QuinnFreedman/modular/modules/Lights/PCBs/lights_pcb/lights_pcb.kicad_pcb

## KiCad design modules/Lights/PCBs/lights_pcb/lights_pcb.kicad_pcb (2025-10-13)

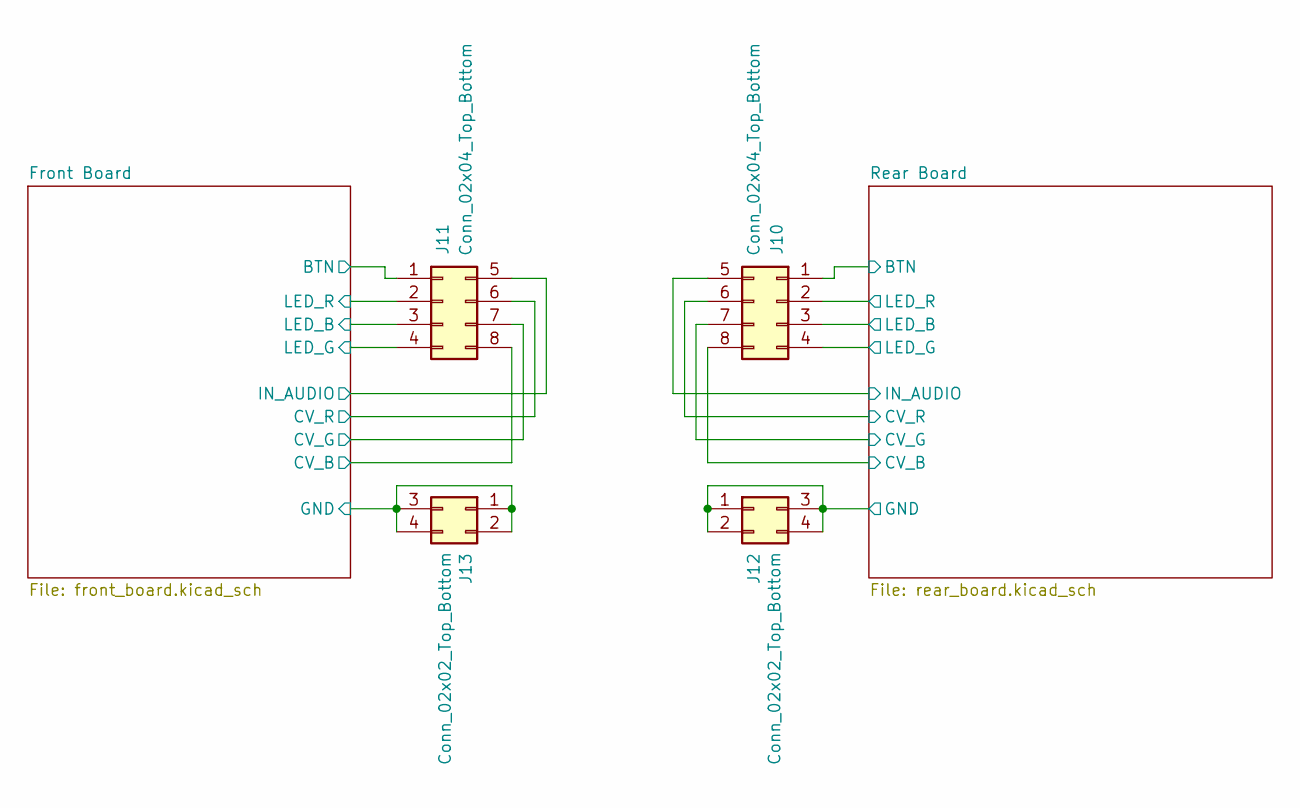
[picture p7: schematic lights_pcb.kicad_sch, Lights]

Parts:
J10: Conn_02x04_Top_Bottom; PinSocket_2x04_P2.54mm_Vertical
J11: Conn_02x04_Top_Bottom; PinHeader_2x04_P2.54mm_Horizontal
J12: Conn_02x02_Top_Bottom; PinSocket_2x02_P2.54mm_Vertical
J13: Conn_02x02_Top_Bottom; PinHeader_2x02_P2.54mm_Horizontal

Connections:
/Front Board/BTN: J11.1; also elsewhere on the board
/Front Board/CV_B: J11.8; also elsewhere on the board
/Front Board/CV_G: J11.7; also elsewhere on the board
/Front Board/CV_R: J11.6; also elsewhere on the board
/Front Board/GND: J13.1, J13.2, J13.3, J13.4; also elsewhere on the board
/Front Board/IN_AUDIO: J11.5; also elsewhere on the board
/Front Board/LED_B: J11.3; also elsewhere on the board
/Front Board/LED_G: J11.4; also elsewhere on the board
/Front Board/LED_R: J11.2; also elsewhere on the board
/Rear Board/BTN: J10.1; also elsewhere on the board
/Rear Board/CV_B: J10.8; also elsewhere on the board
/Rear Board/CV_G: J10.7; also elsewhere on the board
/Rear Board/CV_R: J10.6; also elsewhere on the board
/Rear Board/GND: J12.1, J12.2, J12.3, J12.4; also elsewhere on the board
/Rear Board/IN_AUDIO: J10.5; also elsewhere on the board
/Rear Board/LED_B: J10.3; also elsewhere on the board
/Rear Board/LED_G: J10.4; also elsewhere on the board
/Rear Board/LED_R: J10.2; also elsewhere on the board

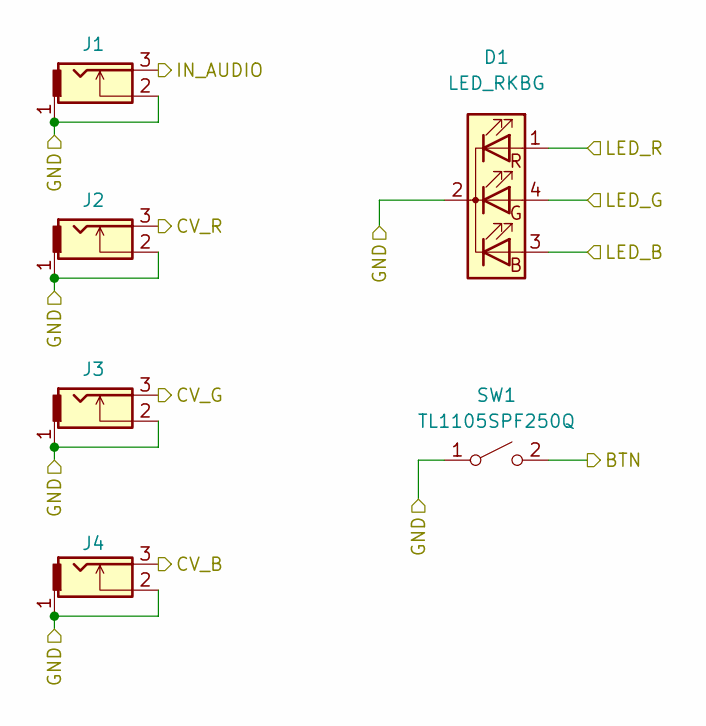
[picture p8: schematic front_board.kicad_sch, Lights]

Parts:
D1: LED_RKBG; LED_D5.0mm-4_RGB
J1, J2, J3, J4: THONKICONN
SW1: TL1105SPF250Q; SW_PUSH_6mm_H13mm

Connections:
/Front Board/BTN: SW1.2 (B); also elsewhere on the board
/Front Board/CV_B: J4.3; also elsewhere on the board
/Front Board/CV_G: J3.3; also elsewhere on the board
/Front Board/CV_R: J2.3; also elsewhere on the board
/Front Board/GND: D1.2 (K), J1.1, J1.2, J2.1, J2.2, J3.1, J3.2, J4.1, J4.2, SW1.1 (A); also elsewhere on the board
/Front Board/IN_AUDIO: J1.3; also elsewhere on the board
/Front Board/LED_B: D1.3 (BA); also elsewhere on the board
/Front Board/LED_G: D1.4 (GA); also elsewhere on the board
/Front Board/LED_R: D1.1 (RA); also elsewhere on the board

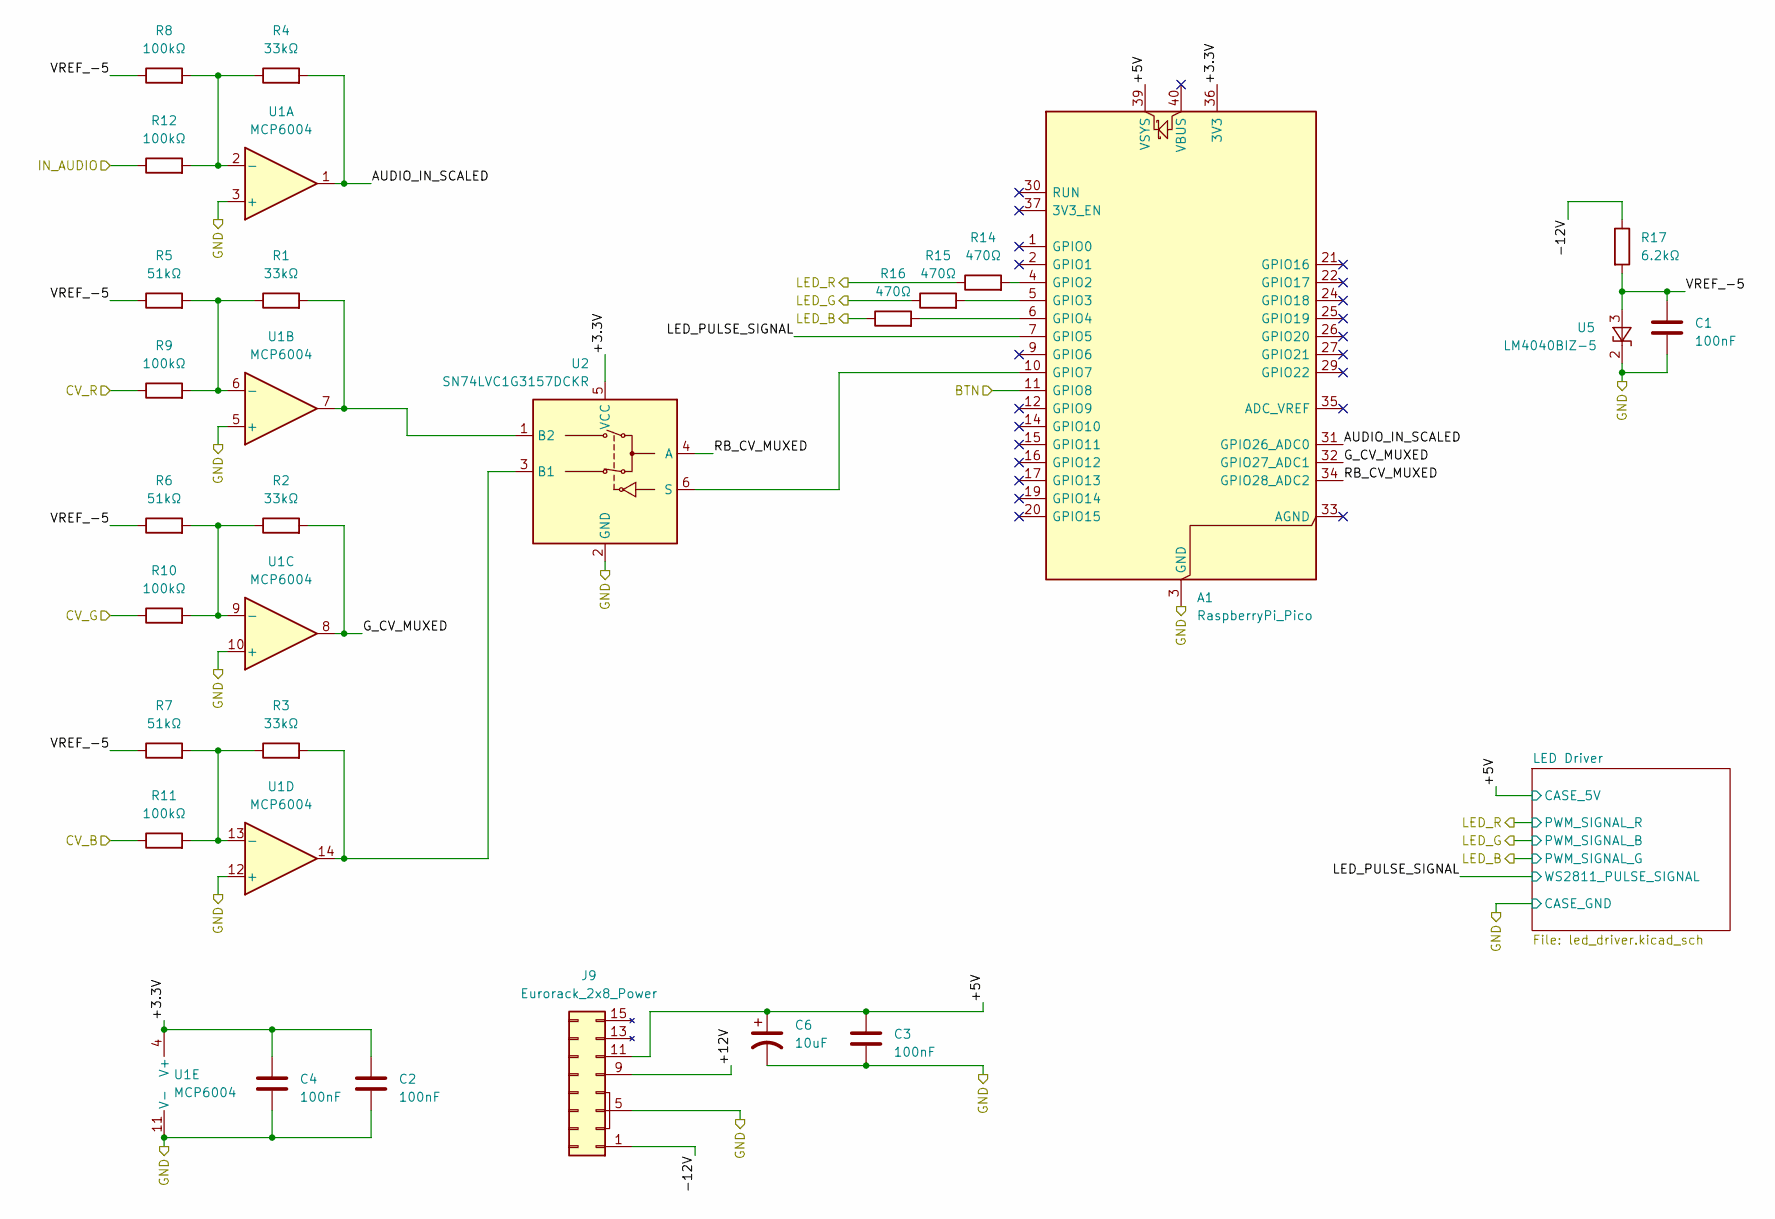
[picture p9: schematic rear_board.kicad_sch, Lights]

Parts:
A1: RaspberryPi_Pico; RaspberryPi_Pico_Common_Unspecified
C1, C2, C3, C4: 100nF; C_Disc_D5.0mm_W2.5mm_P5.00mm
C6: 10uF; CP_Radial_D4.0mm_P1.50mm
J9: Eurorack_2x8_Power; PinSocket_2x08_P2.54mm_Horizontal
R1, R2, R3, R4: 33kΩ; R_Axial_DIN0207_L6.3mm_D2.5mm_P7.62mm_Horizontal
R5, R6, R7: 51kΩ; R_Axial_DIN0207_L6.3mm_D2.5mm_P7.62mm_Horizontal
R8, R9, R10, R11, R12: 100kΩ; R_Axial_DIN0207_L6.3mm_D2.5mm_P7.62mm_Horizontal
R14, R15, R16: 470Ω; R_Axial_DIN0207_L6.3mm_D2.5mm_P7.62mm_Horizontal
R17: 6.2kΩ; R_Axial_DIN0207_L6.3mm_D2.5mm_P7.62mm_Horizontal
U1: MCP6004; DIP-14_W7.62mm
U2: SN74LVC1G3157DCKR; SOT-363_SC-70-6_Handsoldering
U5: LM4040BIZ-5; TO-92_Inline_Wide

Connections:
/Rear Board/+3.3V: A1.36 (3V3), C2.1, C4.1, U1.4 (V+), U2.5 (VCC)
/Rear Board/+5V: A1.39 (VSYS), C3.1, C6.1, J9.11 (+5v), J9.12 (+5v); also elsewhere on the board
/Rear Board/+12V: J9.9 (+12v), J9.10 (+12v)
/Rear Board/-12V: J9.1 (-12v), J9.2 (-12v), R17.1
/Rear Board/AUDIO_IN_SCALED: A1.31 (GPIO26_ADC0), R4.2, U1.1
/Rear Board/BTN: A1.11 (GPIO8); also elsewhere on the board
/Rear Board/CV_B: R11.1; also elsewhere on the board
/Rear Board/CV_G: R10.1; also elsewhere on the board
/Rear Board/CV_R: R9.1; also elsewhere on the board
/Rear Board/GND: A1.3 (GND), A1.8 (GND), A1.13 (GND), A1.18 (GND), A1.23 (GND), A1.28 (GND), A1.38 (GND), C1.2, C2.2, C3.2, C4.2, C6.2, J9.3 (GND), J9.4 (GND), J9.5 (GND), J9.6 (GND), J9.7 (GND), J9.8 (GND), U1.3 (+), U1.5 (+), U1.10 (+), U1.11 (V-), U1.12 (+), U2.2 (GND), U5.2 (K); also elsewhere on the board
/Rear Board/G_CV_MUXED: A1.32 (GPIO27_ADC1), R2.2, U1.8
/Rear Board/IN_AUDIO: R12.1; also elsewhere on the board
/Rear Board/LED_B: R16.1; also elsewhere on the board
/Rear Board/LED_G: R15.1; also elsewhere on the board
/Rear Board/LED_PULSE_SIGNAL: A1.7 (GPIO5); also elsewhere on the board
/Rear Board/LED_R: R14.1; also elsewhere on the board
/Rear Board/RB_CV_MUXED: A1.34 (GPIO28_ADC2), U2.4 (A)
/Rear Board/VREF_-5: C1.1, R5.1, R6.1, R7.1, R8.1, R17.2, U5.3 (A)
unnamed: A1.4 (GPIO2), R14.2
unnamed: A1.5 (GPIO3), R15.2
unnamed: A1.6 (GPIO4), R16.2
unnamed: A1.10 (GPIO7), U2.6 (S)
unnamed: R4.1, R8.2, R12.2, U1.2 (-)
unnamed: R1.1, R5.2, R9.2, U1.6 (-)
unnamed: R2.1, R6.2, R10.2, U1.9 (-)
unnamed: R3.1, R7.2, R11.2, U1.13 (-)
unnamed: R3.2, U1.14, U2.3 (B1)
unnamed: R1.2, U1.7, U2.1 (B2)

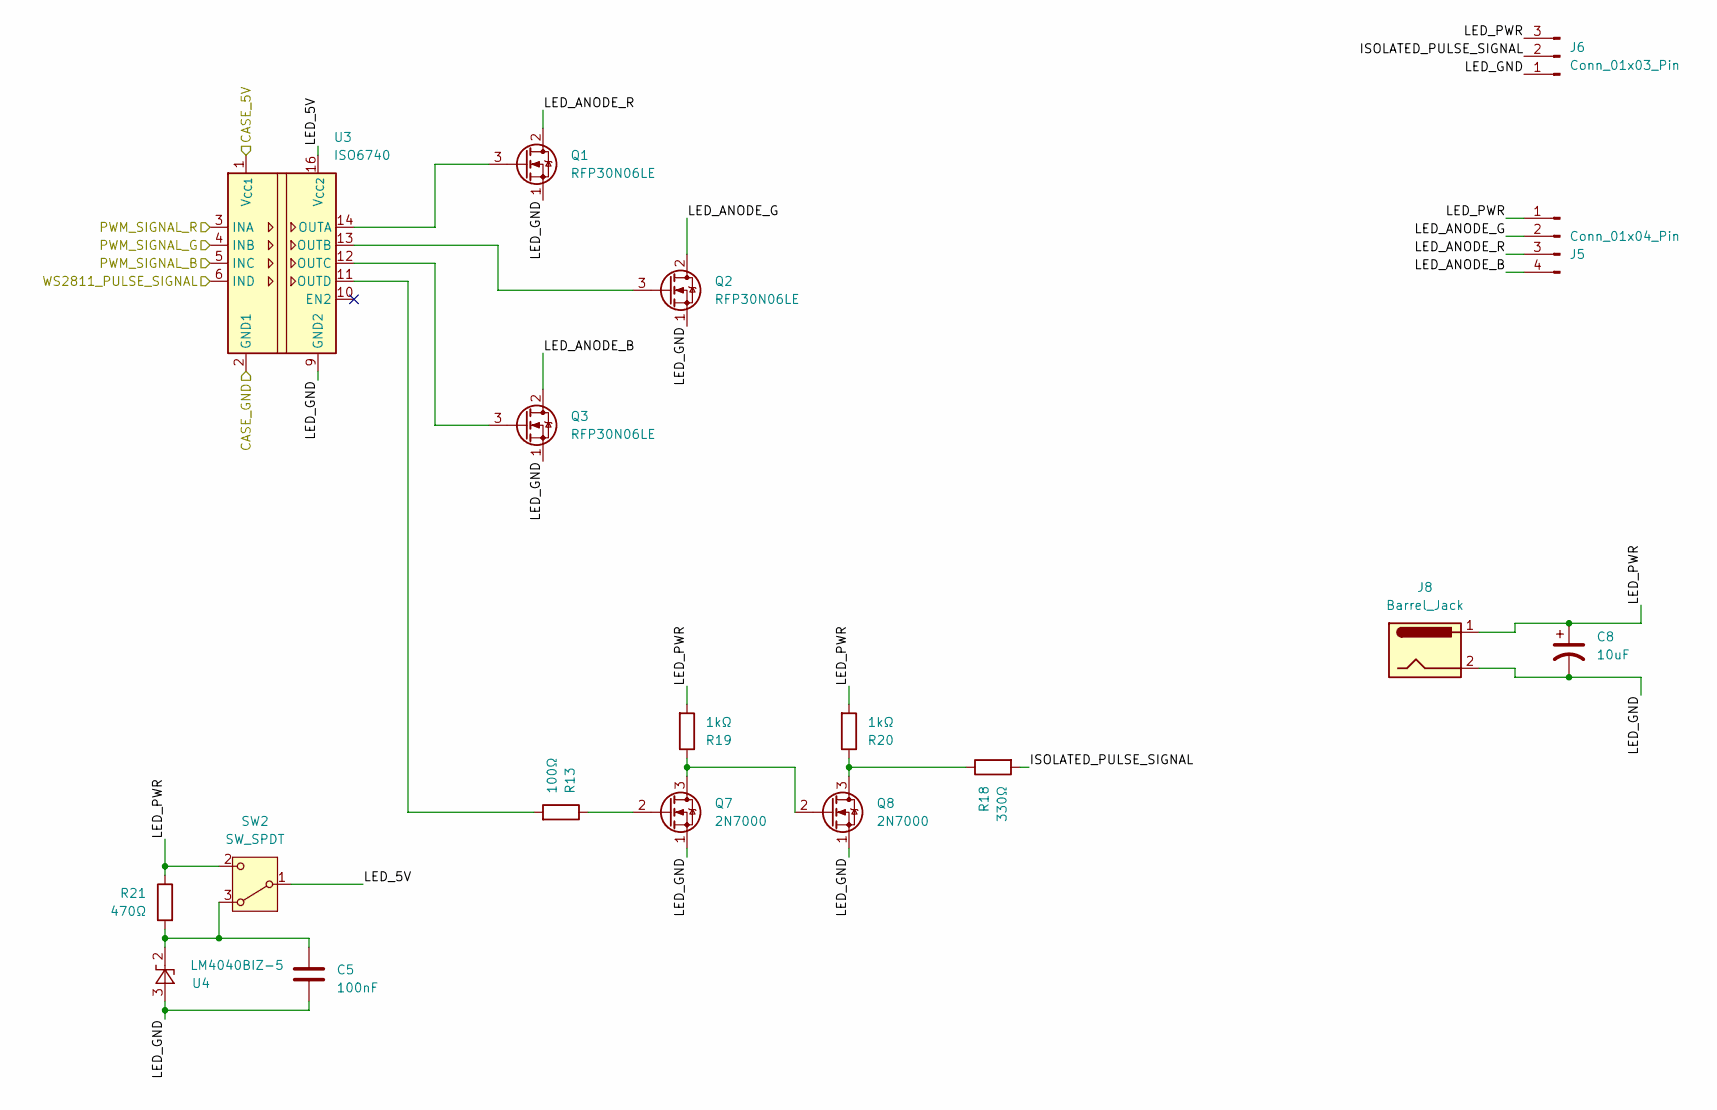
[picture p10: schematic led_driver.kicad_sch, Lights]

Parts:
C5: 100nF; C_Disc_D5.0mm_W2.5mm_P5.00mm
C8: 10uF; CP_Radial_D4.0mm_P1.50mm
J5: Conn_01x04_Pin; PinSocket_1x04_P2.54mm_Vertical
J6: Conn_01x03_Pin; PinSocket_1x03_P2.54mm_Vertical
J8: Barrel_Jack; BarrelJack_Wuerth_6941xx301002
Q1, Q2, Q3: RFP30N06LE; TO-220-3_Vertical
Q7, Q8: 2N7000; TO-92_Inline
R13: 100Ω; R_Axial_DIN0207_L6.3mm_D2.5mm_P7.62mm_Horizontal
R18: 330Ω; R_Axial_DIN0207_L6.3mm_D2.5mm_P7.62mm_Horizontal
R19, R20: 1kΩ; R_Axial_DIN0207_L6.3mm_D2.5mm_P7.62mm_Horizontal
R21: 470Ω; R_Axial_DIN0207_L6.3mm_D2.5mm_P7.62mm_Horizontal
SW2: SW_SPDT; SW_Slide-03_Wuerth-WS-SLTV_10x2.5x6.4_P2.54mm
U3: ISO6740; SOIC-16W_7.5x10.3mm_P1.27mm
U4: LM4040BIZ-5; TO-92_Inline_Wide

Connections:
/Rear Board/+5V: U3.1 (V_{CC1}); also elsewhere on the board
/Rear Board/GND: U3.2 (GND1), U3.8 (GND1); also elsewhere on the board
/Rear Board/LED Driver/ISOLATED_PULSE_SIGNAL: J6.2, R18.2
/Rear Board/LED Driver/LED_5V: SW2.1 (B), U3.16 (V_{CC2})
/Rear Board/LED Driver/LED_ANODE_B: J5.4, Q3.2 (D)
/Rear Board/LED Driver/LED_ANODE_G: J5.2, Q2.2 (D)
/Rear Board/LED Driver/LED_ANODE_R: J5.3, Q1.2 (D)
/Rear Board/LED Driver/LED_GND: C5.2, C8.2, J6.1, J8.2, Q1.1 (S), Q2.1 (S), Q3.1 (S), Q7.1 (S), Q8.1 (S), U3.9 (GND2), U3.15 (GND2), U4.3 (A)
/Rear Board/LED Driver/LED_PWR: C8.1, J5.1, J6.3, J8.1, R19.2, R20.2, R21.1, SW2.2 (C)
/Rear Board/LED_B: U3.4 (INB); also elsewhere on the board
/Rear Board/LED_G: U3.5 (INC); also elsewhere on the board
/Rear Board/LED_PULSE_SIGNAL: U3.6 (IND); also elsewhere on the board
/Rear Board/LED_R: U3.3 (INA); also elsewhere on the board
unnamed: Q1.3 (G), U3.14 (OUTA)
unnamed: Q2.3 (G), U3.13 (OUTB)
unnamed: Q3.3 (G), U3.12 (OUTC)
unnamed: Q7.3 (D), Q8.2 (G), R19.1
unnamed: Q7.2 (G), R13.1
unnamed: Q8.3 (D), R18.1, R20.1
unnamed: C5.1, R21.2, SW2.3 (A), U4.2 (K)
unnamed: R13.2, U3.11 (OUTD)
