QuinnFreedman/modular/modules/Lights/PCBs/lights_pcb/lights_pcb.kicad_pcb

## KiCad design modules/Lights/PCBs/lights_pcb/lights_pcb.kicad_pcb (continued)

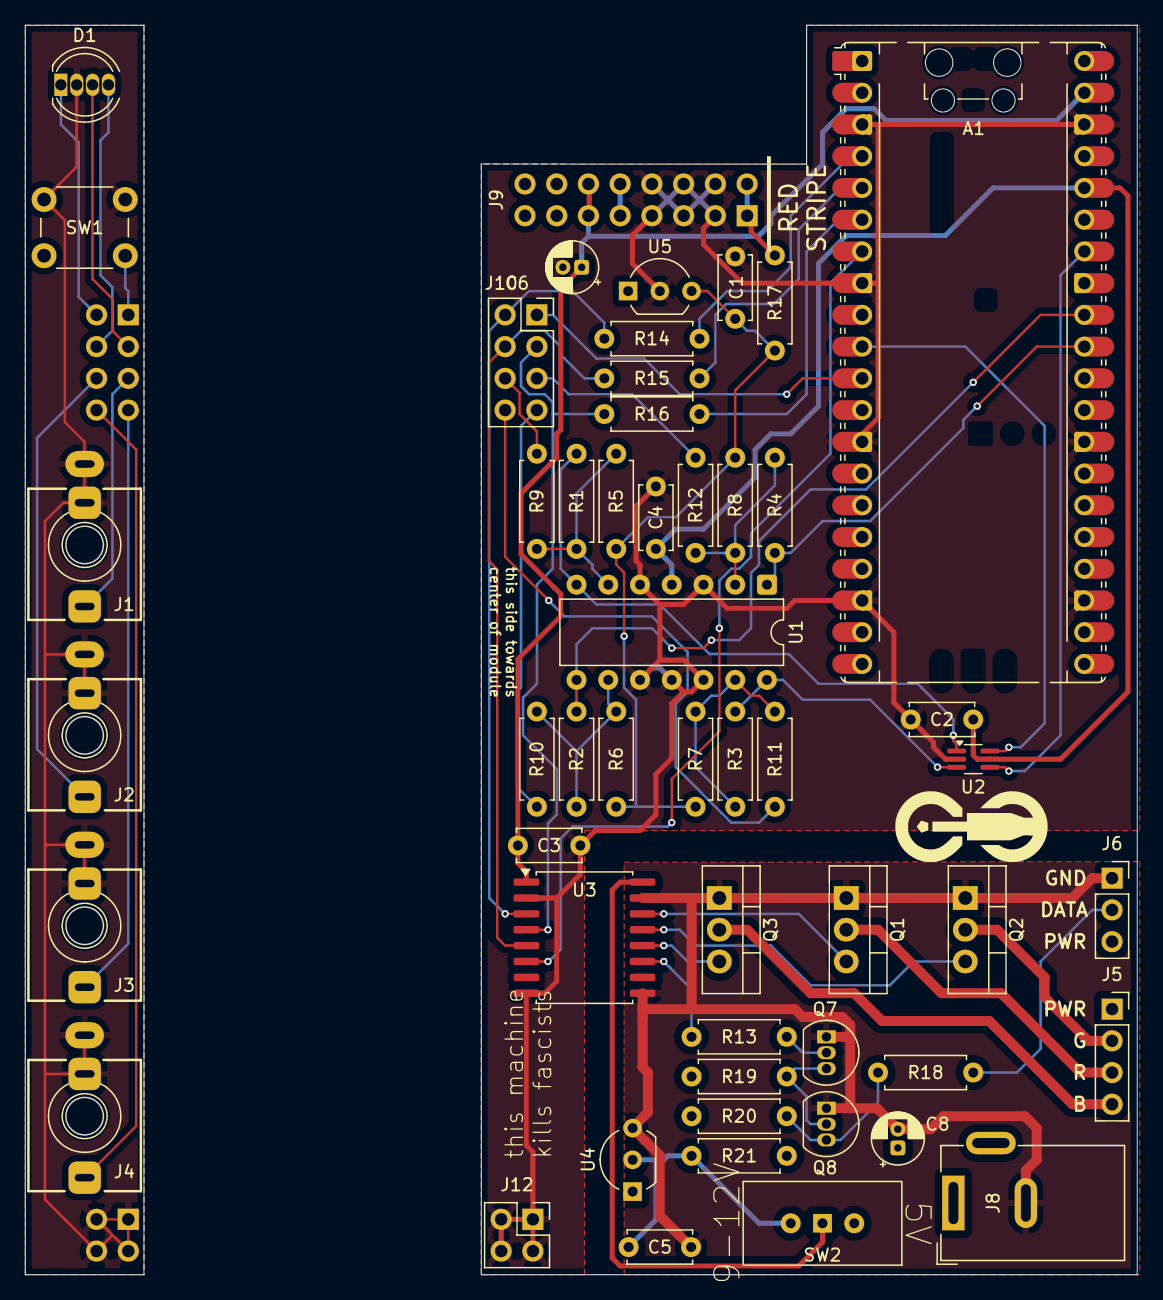
[picture p11: board lights_pcb.kicad_pcb from above]

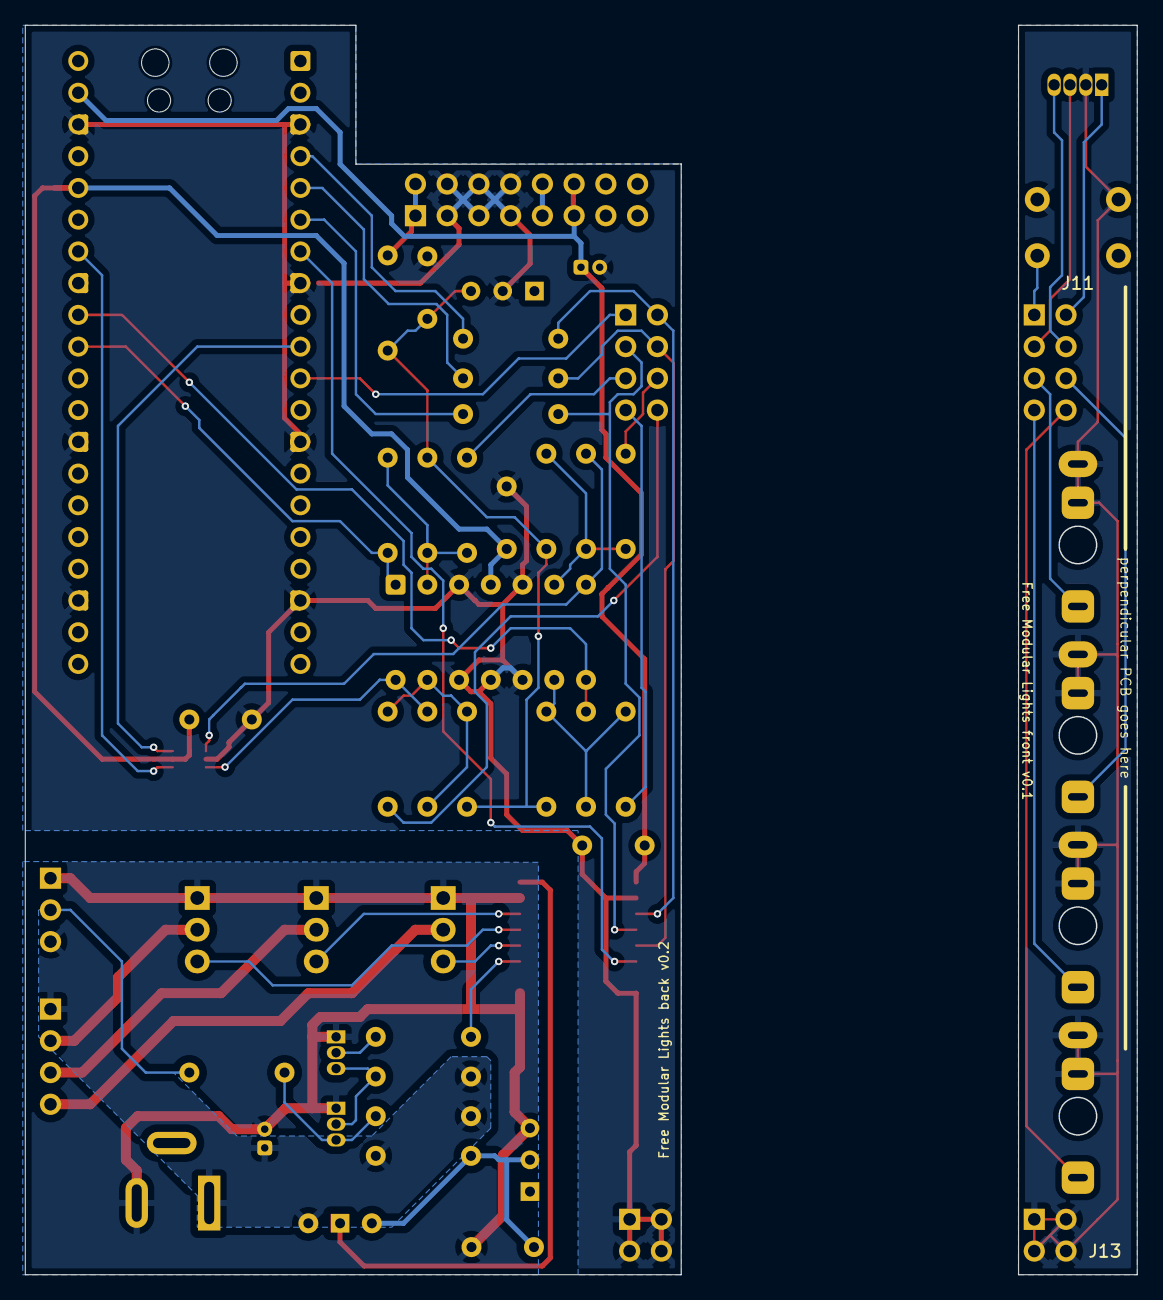
[picture p12: board lights_pcb.kicad_pcb from below]

Board: 2 copper layers, 52.5 x 100.0 mm, 57 parts (2 on the bottom side), 52 nets.

Other parts of the board:
B1, B2: Board
G1: logo_small
