QuinnFreedman/modular/modules/Logic/PCBs/logic_pcb/logic_pcb.kicad_pcb

## KiCad design modules/Logic/PCBs/logic_pcb/logic_pcb.kicad_pcb (2025-06-04)

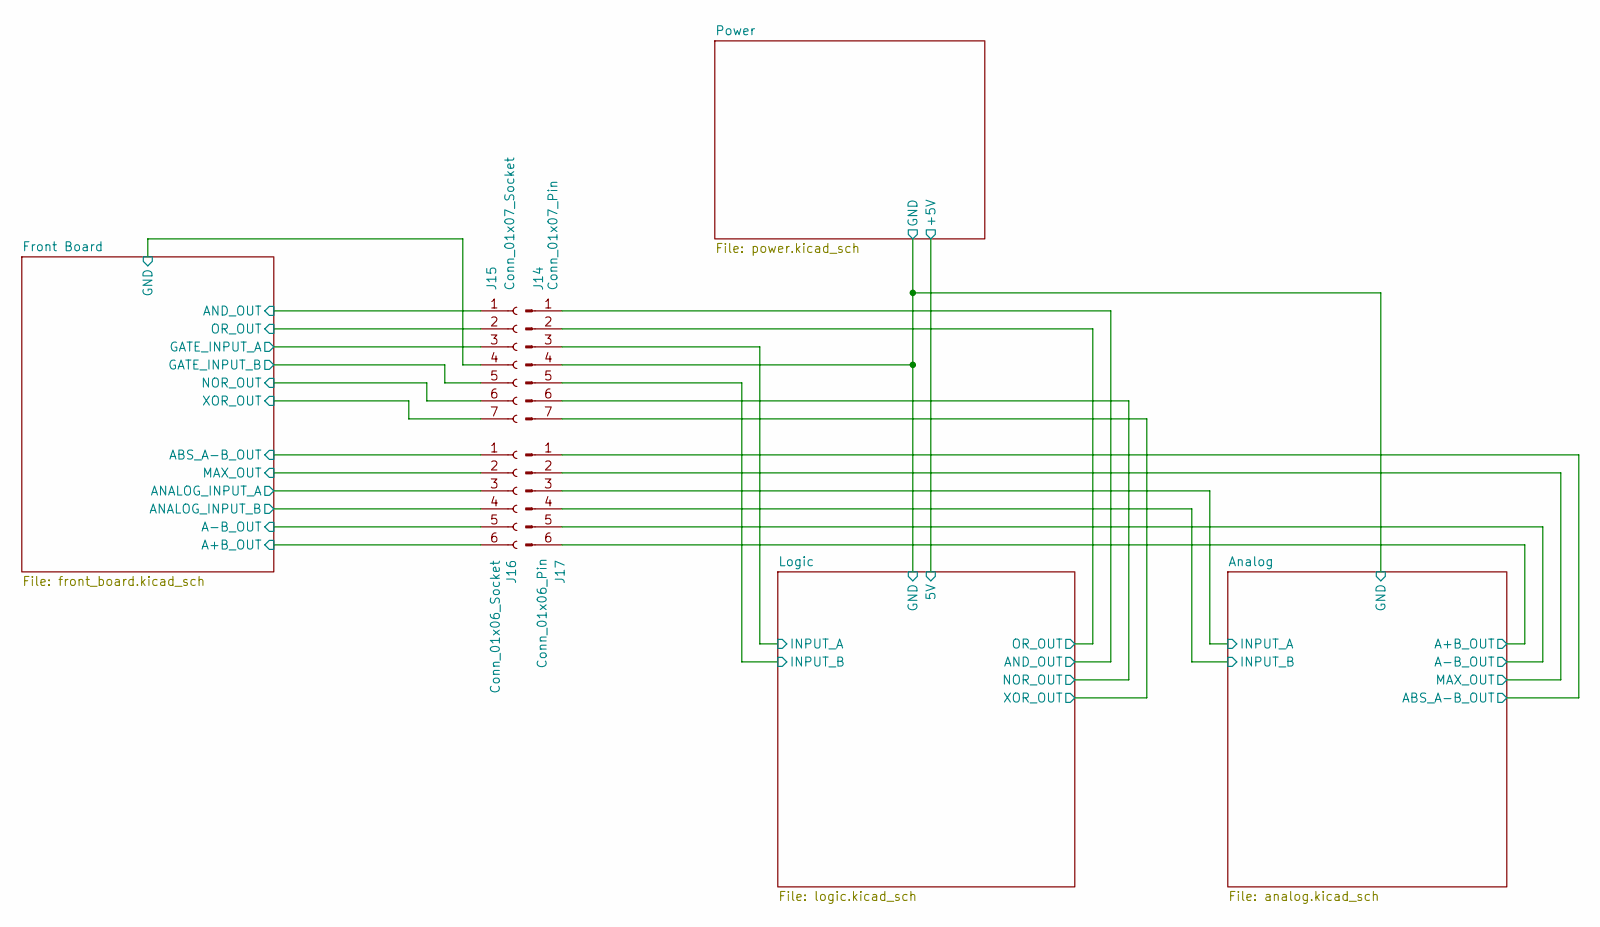
[picture p18: schematic logic_pcb.kicad_sch, ALU]

Parts:
J14: Conn_01x07_Pin; PinSocket_1x07_P2.54mm_Vertical
J15: Conn_01x07_Socket; PinSocket_1x07_P2.54mm_Vertical
J16: Conn_01x06_Socket; PinSocket_1x06_P2.54mm_Vertical
J17: Conn_01x06_Pin; PinSocket_1x06_P2.54mm_Vertical

Connections:
/Analog/A+B_OUT: J17.6; also elsewhere on the board
/Analog/A-B_OUT: J17.5; also elsewhere on the board
/Analog/ABS_A-B_OUT: J17.1; also elsewhere on the board
/Analog/GND: J14.4; also elsewhere on the board
/Analog/INPUT_A: J17.3; also elsewhere on the board
/Analog/INPUT_B: J17.4; also elsewhere on the board
/Analog/MAX_OUT: J17.2; also elsewhere on the board
/Front Board/A+B_OUT: J16.6; also elsewhere on the board
/Front Board/A-B_OUT: J16.5; also elsewhere on the board
/Front Board/ABS_A-B_OUT: J16.1; also elsewhere on the board
/Front Board/ANALOG_INPUT_A: J16.3; also elsewhere on the board
/Front Board/ANALOG_INPUT_B: J16.4; also elsewhere on the board
/Front Board/AND_OUT: J15.1; also elsewhere on the board
/Front Board/GATE_INPUT_A: J15.3; also elsewhere on the board
/Front Board/GATE_INPUT_B: J15.5; also elsewhere on the board
/Front Board/GND: J15.4; also elsewhere on the board
/Front Board/MAX_OUT: J16.2; also elsewhere on the board
/Front Board/NOR_OUT: J15.6; also elsewhere on the board
/Front Board/OR_OUT: J15.2; also elsewhere on the board
/Front Board/XOR_OUT: J15.7; also elsewhere on the board
/Logic/AND_OUT: J14.1; also elsewhere on the board
/Logic/INPUT_A: J14.3; also elsewhere on the board
/Logic/INPUT_B: J14.5; also elsewhere on the board
/Logic/NOR_OUT: J14.6; also elsewhere on the board
/Logic/OR_OUT: J14.2; also elsewhere on the board
/Logic/XOR_OUT: J14.7; also elsewhere on the board
