QuinnFreedman/modular/modules/Logic/PCBs/logic_pcb/logic_pcb.kicad_pcb

## KiCad design modules/Logic/PCBs/logic_pcb/logic_pcb.kicad_pcb (continued)

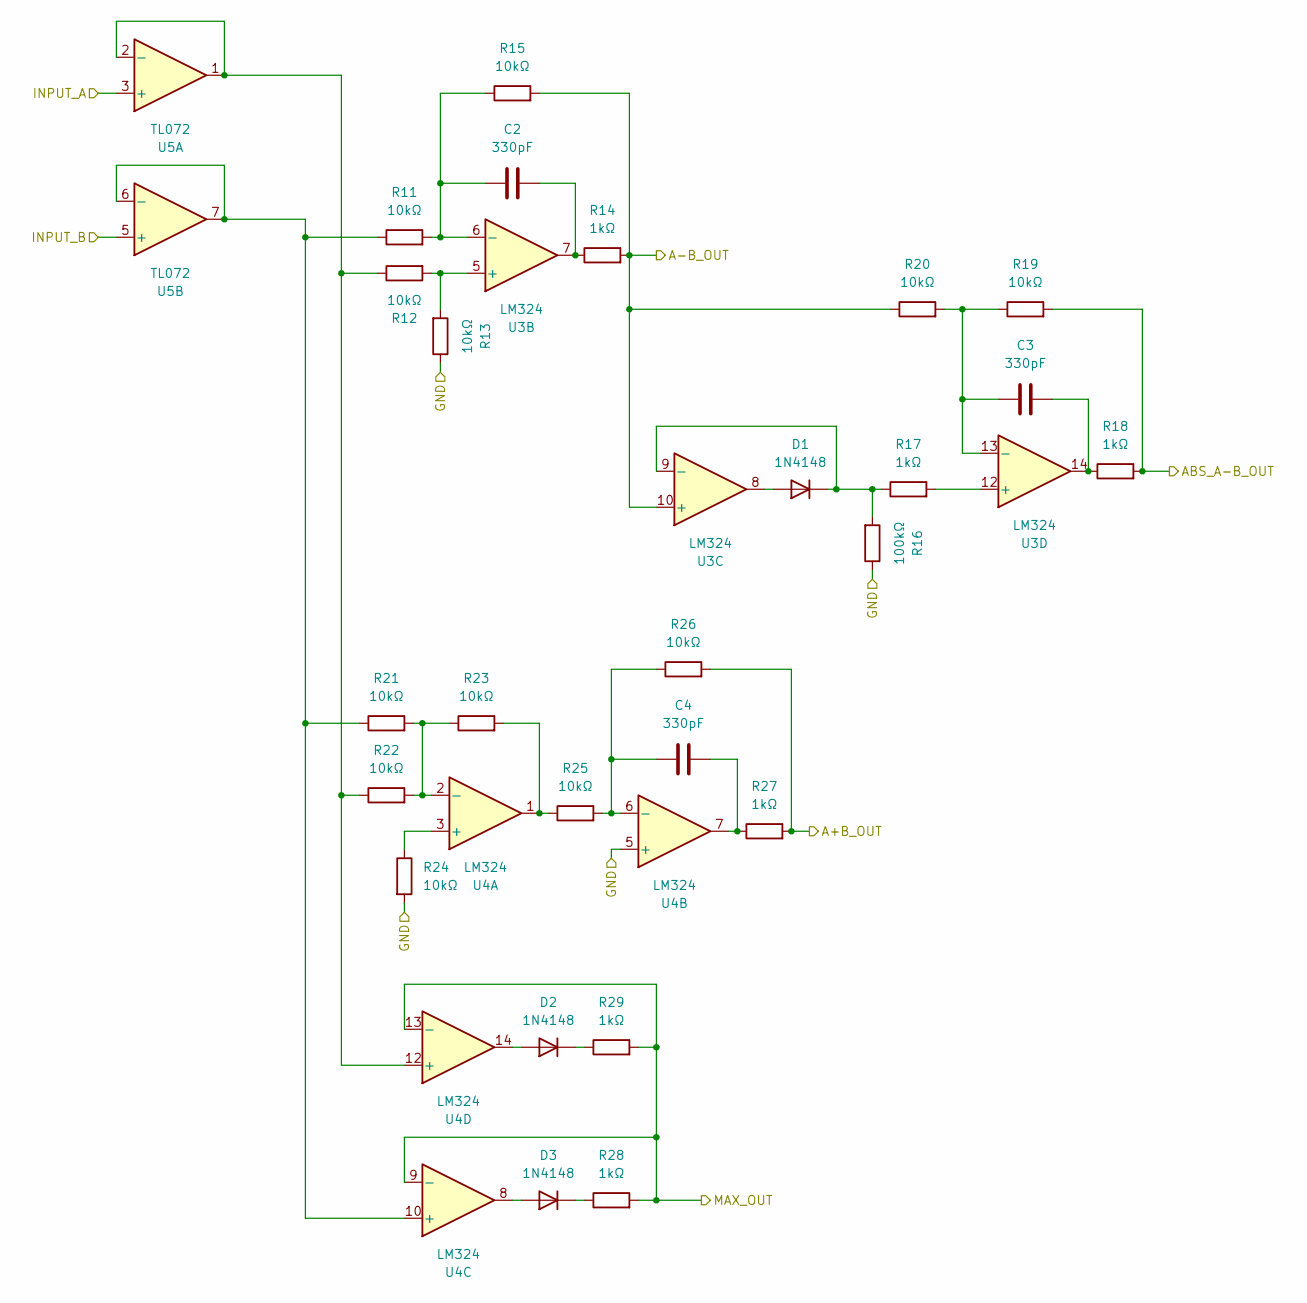
[picture p19: schematic analog.kicad_sch, ALU]

Parts:
C2, C3, C4: 330pF; C_0805_2012Metric_Pad1.18x1.45mm_HandSolder; JLC C376974
D1, D2, D3: 1N4148; D_SOD-123; JLC C5443965
R11, R12, R13, R15, R19, R20, R21, R22, R23, R24, R25, R26: 10kΩ; R_0805_2012Metric_Pad1.20x1.40mm_HandSolder; JLC C17414
R14, R17, R18, R27, R28, R29: 1kΩ; R_0805_2012Metric_Pad1.20x1.40mm_HandSolder; JLC C17513
R16: 100kΩ; R_0805_2012Metric_Pad1.20x1.40mm_HandSolder; JLC C149504
U3, U4: LM324; SOIC-14_3.9x8.7mm_P1.27mm; JLC C7943
U5: TL072; SOP-8_3.9x4.9mm_P1.27mm; JLC C5310783

Connections:
/Analog/A+B_OUT: R26.2, R27.2; also elsewhere on the board
/Analog/A-B_OUT: R14.2, R15.2, R20.1, U3.10 (+); also elsewhere on the board
/Analog/ABS_A-B_OUT: R18.2, R19.2; also elsewhere on the board
/Analog/GND: R13.1, R16.1, R24.2, U4.5 (+); also elsewhere on the board
/Analog/INPUT_A: U5.3 (+); also elsewhere on the board
/Analog/INPUT_B: U5.5 (+); also elsewhere on the board
/Analog/MAX_OUT: R28.2, R29.2, U4.9 (-), U4.13 (-); also elsewhere on the board
unnamed: C2.2, R14.1, U3.7
unnamed: C3.2, R18.1, U3.14
unnamed: C4.2, R27.1, U4.7
unnamed: D1.2 (A), U3.8
unnamed: D1.1 (K), R16.2, R17.1, U3.9 (-)
unnamed: D2.2 (A), U4.14
unnamed: D2.1 (K), R29.1
unnamed: D3.2 (A), U4.8
unnamed: D3.1 (K), R28.1
unnamed: R23.2, R25.1, U4.1
unnamed: R12.2, R13.2, U3.5 (+)
unnamed: C2.1, R11.2, R15.1, U3.6 (-)
unnamed: R17.2, U3.12 (+)
unnamed: C3.1, R19.1, R20.2, U3.13 (-)
unnamed: R24.1, U4.3 (+)
unnamed: R21.2, R22.2, R23.1, U4.2 (-)
unnamed: C4.1, R25.2, R26.1, U4.6 (-)
unnamed: R11.1, R21.1, U4.10 (+), U5.6 (-), U5.7
unnamed: R12.1, R22.1, U4.12 (+), U5.1, U5.2 (-)

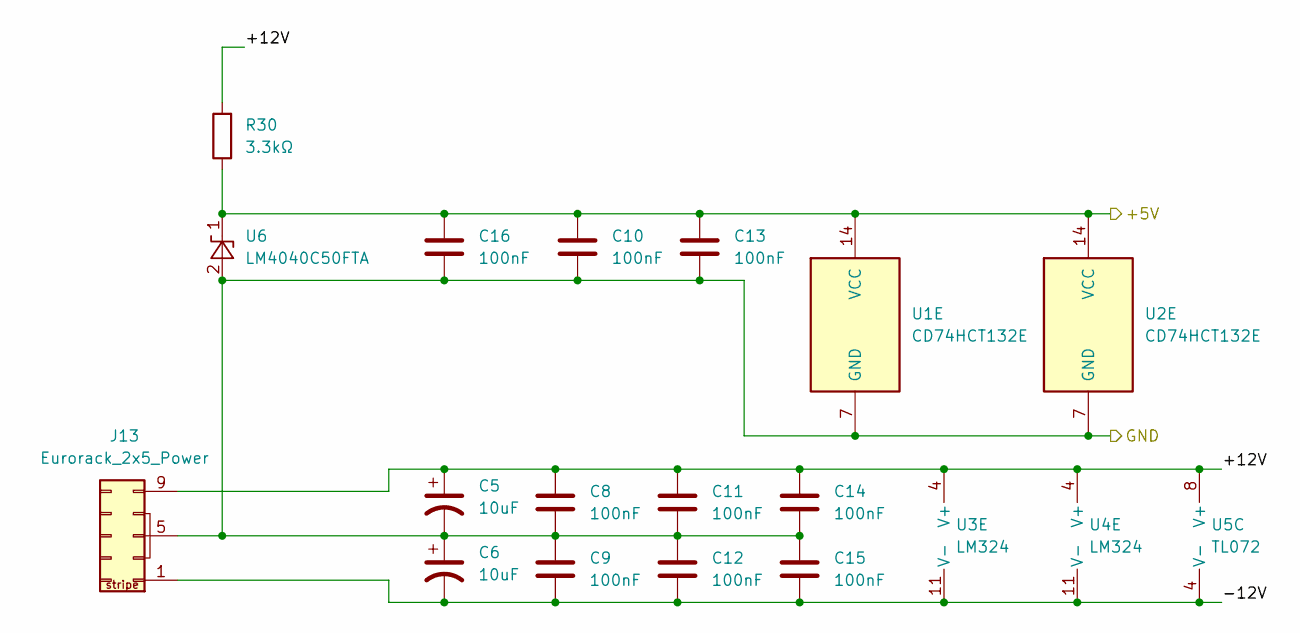
[picture p20: schematic power.kicad_sch, ALU]

Parts:
C5, C6: 10uF; CP_Elec_4x5.4; JLC C3343
C8, C9, C10, C11, C12, C13, C14, C15, C16: 100nF; C_0805_2012Metric_Pad1.18x1.45mm_HandSolder; JLC C29926
J13: Eurorack_2x5_Power; IDC-Header_2x05_P2.54mm_Vertical
R30: 3.3kΩ; R_0805_2012Metric_Pad1.20x1.40mm_HandSolder; JLC C26010
U1, U2: CD74HCT132E; SOIC-14_3.9x8.7mm_P1.27mm; JLC C484714
U3, U4: LM324; SOIC-14_3.9x8.7mm_P1.27mm; JLC C7943
U5: TL072; SOP-8_3.9x4.9mm_P1.27mm; JLC C5310783
U6: LM4040C50FTA; SOT-23; JLC C156291

Connections:
/Analog/GND: C5.2, C6.1, C8.2, C9.1, C10.2, C11.2, C12.1, C13.2, C14.2, C15.1, C16.2, J13.3 (GND), J13.4 (GND), J13.5 (GND), J13.6 (GND), J13.7 (GND), J13.8 (GND), U1.7 (GND), U2.7 (GND), U6.2 (A); also elsewhere on the board
/Logic/5V: C10.1, C13.1, C16.1, R30.1, U1.14 (VCC), U2.14 (VCC), U6.1 (K); also elsewhere on the board
/Power/+12V: C5.1, C8.1, C11.1, C14.1, J13.9 (+12v), J13.10 (+12v), R30.2, U3.4 (V+), U4.4 (V+), U5.8 (V+)
/Power/-12V: C6.2, C9.2, C12.2, C15.2, J13.1 (-12v), J13.2 (-12v), U3.11 (V-), U4.11 (V-), U5.4 (V-)

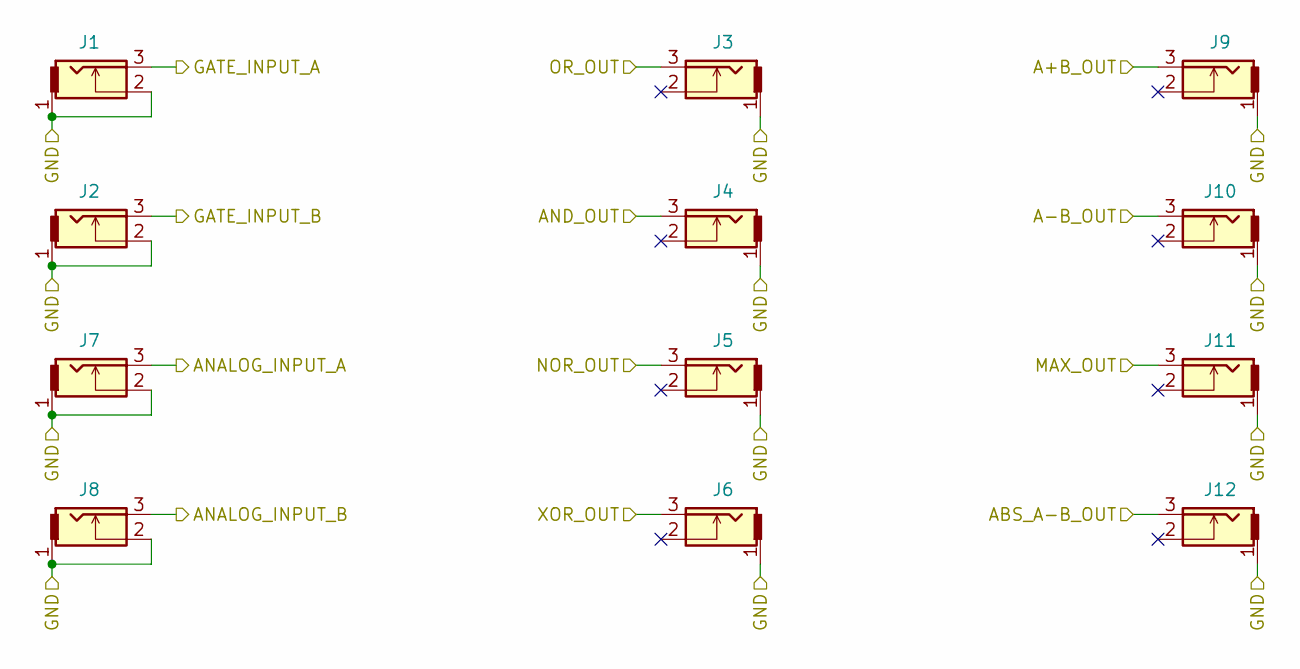
[picture p21: schematic front_board.kicad_sch, ALU]

Parts:
J1, J2, J3, J4, J5, J6, J7, J8, J9, J10, J11, J12: THONKICONN

Connections:
/Front Board/A+B_OUT: J9.3; also elsewhere on the board
/Front Board/A-B_OUT: J10.3; also elsewhere on the board
/Front Board/ABS_A-B_OUT: J12.3; also elsewhere on the board
/Front Board/ANALOG_INPUT_A: J7.3; also elsewhere on the board
/Front Board/ANALOG_INPUT_B: J8.3; also elsewhere on the board
/Front Board/AND_OUT: J4.3; also elsewhere on the board
/Front Board/GATE_INPUT_A: J1.3; also elsewhere on the board
/Front Board/GATE_INPUT_B: J2.3; also elsewhere on the board
/Front Board/GND: J1.1, J1.2, J2.1, J2.2, J3.1, J4.1, J5.1, J6.1, J7.1, J7.2, J8.1, J8.2, J9.1, J10.1, J11.1, J12.1; also elsewhere on the board
/Front Board/MAX_OUT: J11.3; also elsewhere on the board
/Front Board/NOR_OUT: J5.3; also elsewhere on the board
/Front Board/OR_OUT: J3.3; also elsewhere on the board
/Front Board/XOR_OUT: J6.3; also elsewhere on the board

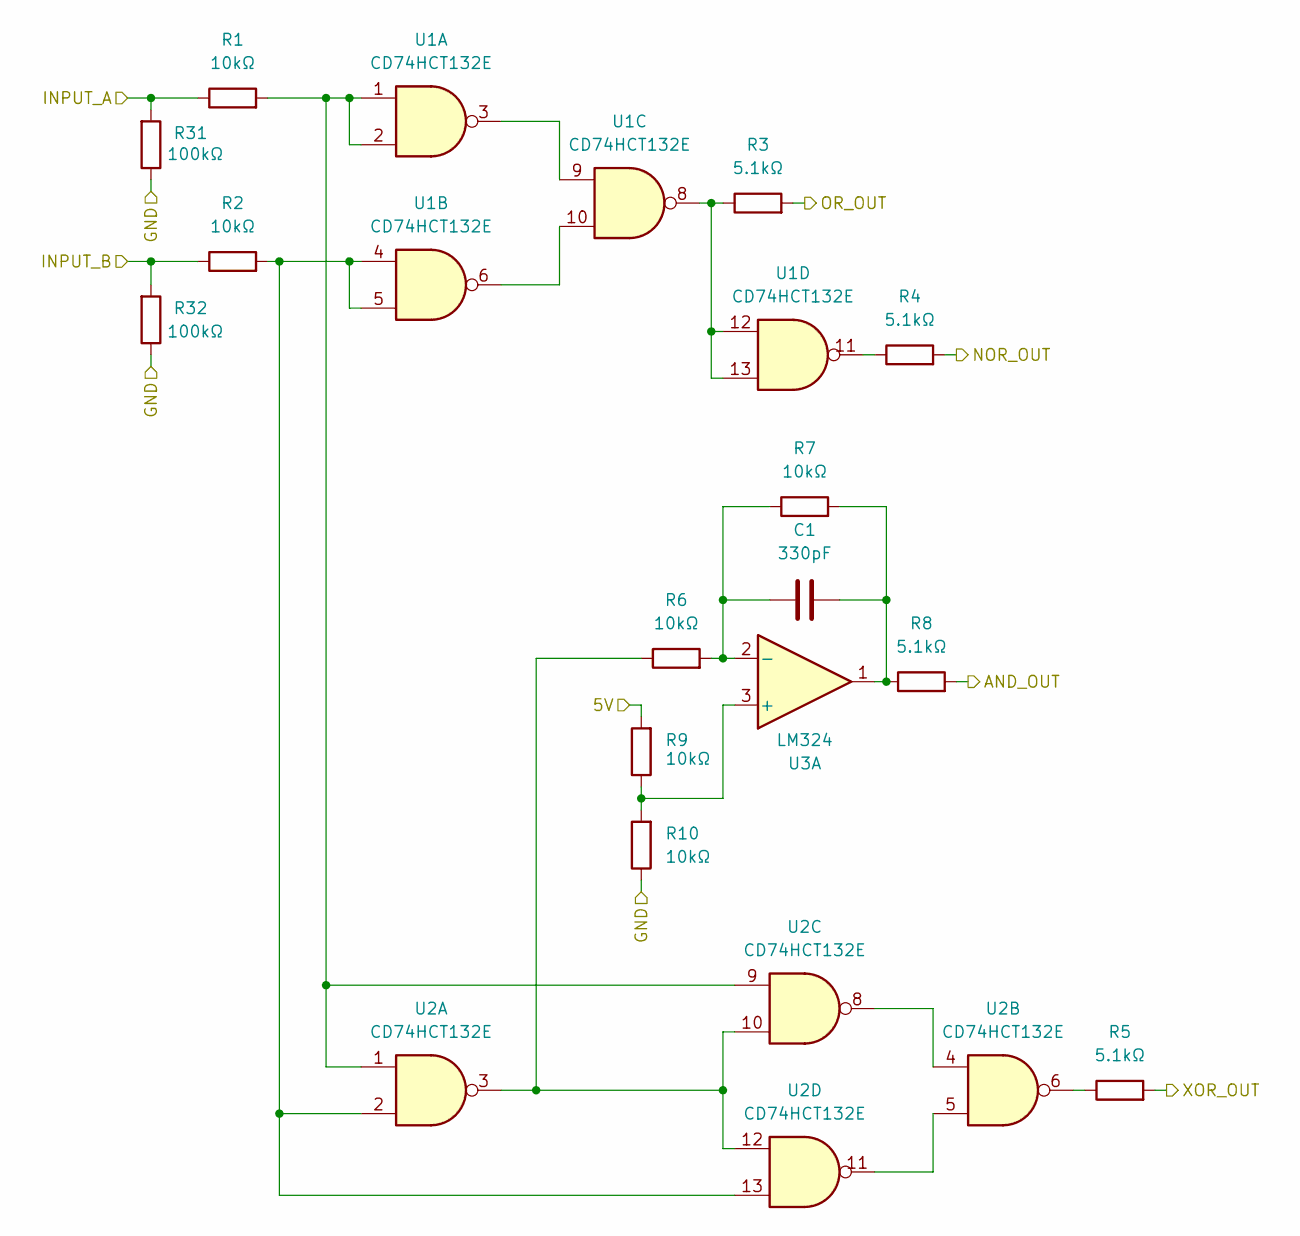
[picture p22: schematic logic.kicad_sch, ALU]

Parts:
C1: 330pF; C_0805_2012Metric_Pad1.18x1.45mm_HandSolder; JLC C376974
R1, R2, R6, R7, R9, R10: 10kΩ; R_0805_2012Metric_Pad1.20x1.40mm_HandSolder; JLC C17414
R3, R4, R5, R8: 5.1kΩ; R_0805_2012Metric_Pad1.20x1.40mm_HandSolder; JLC C27834
R31, R32: 100kΩ; R_0805_2012Metric_Pad1.20x1.40mm_HandSolder; JLC C149504
U1, U2: CD74HCT132E; SOIC-14_3.9x8.7mm_P1.27mm; JLC C484714
U3: LM324; SOIC-14_3.9x8.7mm_P1.27mm; JLC C7943

Connections:
/Analog/GND: R10.1, R31.1, R32.1; also elsewhere on the board
/Logic/5V: R9.2; also elsewhere on the board
/Logic/AND_OUT: R8.2; also elsewhere on the board
/Logic/INPUT_A: R1.1, R31.2; also elsewhere on the board
/Logic/INPUT_B: R2.1, R32.2; also elsewhere on the board
/Logic/NOR_OUT: R4.2; also elsewhere on the board
/Logic/OR_OUT: R3.2; also elsewhere on the board
/Logic/XOR_OUT: R5.2; also elsewhere on the board
unnamed: C1.2, R7.2, R8.1, U3.1
unnamed: R1.2, U1.1, U1.2, U2.1, U2.9
unnamed: R2.2, U1.4, U1.5, U2.2, U2.13
unnamed: R3.1, U1.8, U1.12, U1.13
unnamed: R4.1, U1.11
unnamed: R5.1, U2.6
unnamed: R6.1, U2.3, U2.10, U2.12
unnamed: U1.3, U1.9
unnamed: U1.6, U1.10
unnamed: U2.4, U2.8
unnamed: U2.5, U2.11
unnamed: R9.1, R10.2, U3.3 (+)
unnamed: C1.1, R6.2, R7.1, U3.2 (-)

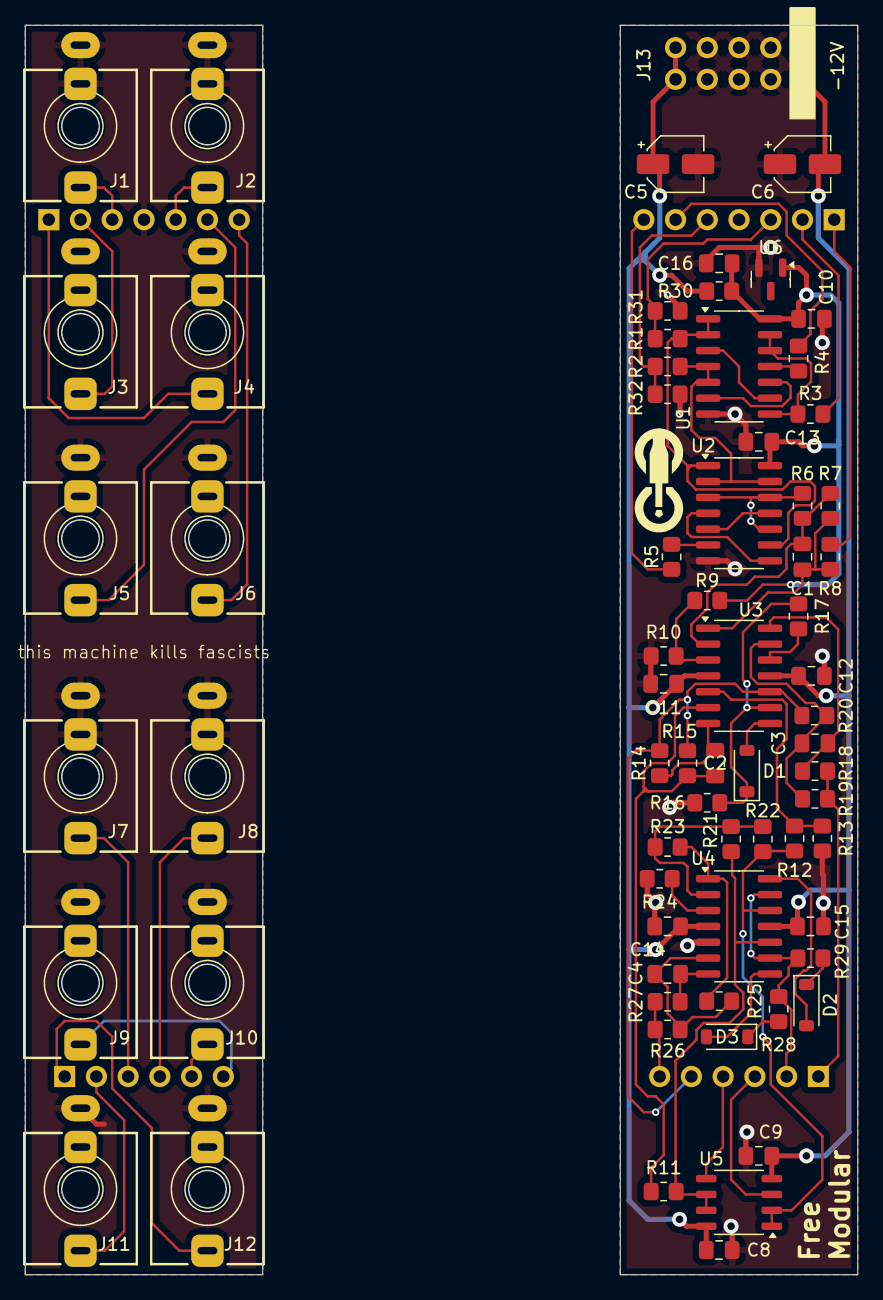
[picture p23: board logic_pcb.kicad_pcb from above]

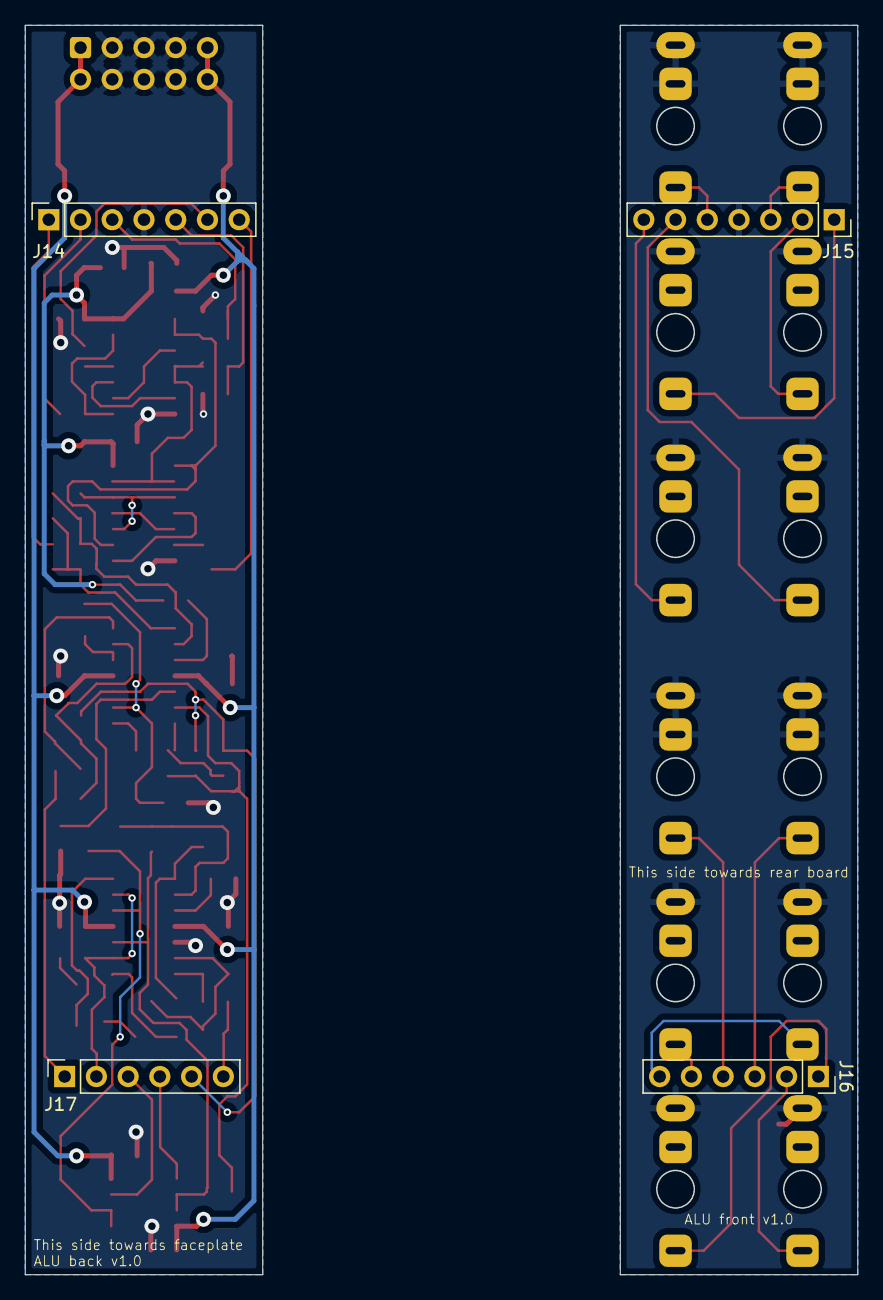
[picture p24: board logic_pcb.kicad_pcb from below]

Board: 2 copper layers, 19.0 x 100.0 mm, 76 parts (4 on the bottom side), 61 nets.

Other parts of the board:
B1, B2: Board
G1: logo_very_small
