QuinnFreedman/modular/modules/OffsetAtten/PCBs/offset_atten_pcb/offset_atten_pcb.kicad_pcb

## KiCad design modules/OffsetAtten/PCBs/offset_atten_pcb/offset_atten_pcb.kicad_pcb (2025-04-23)

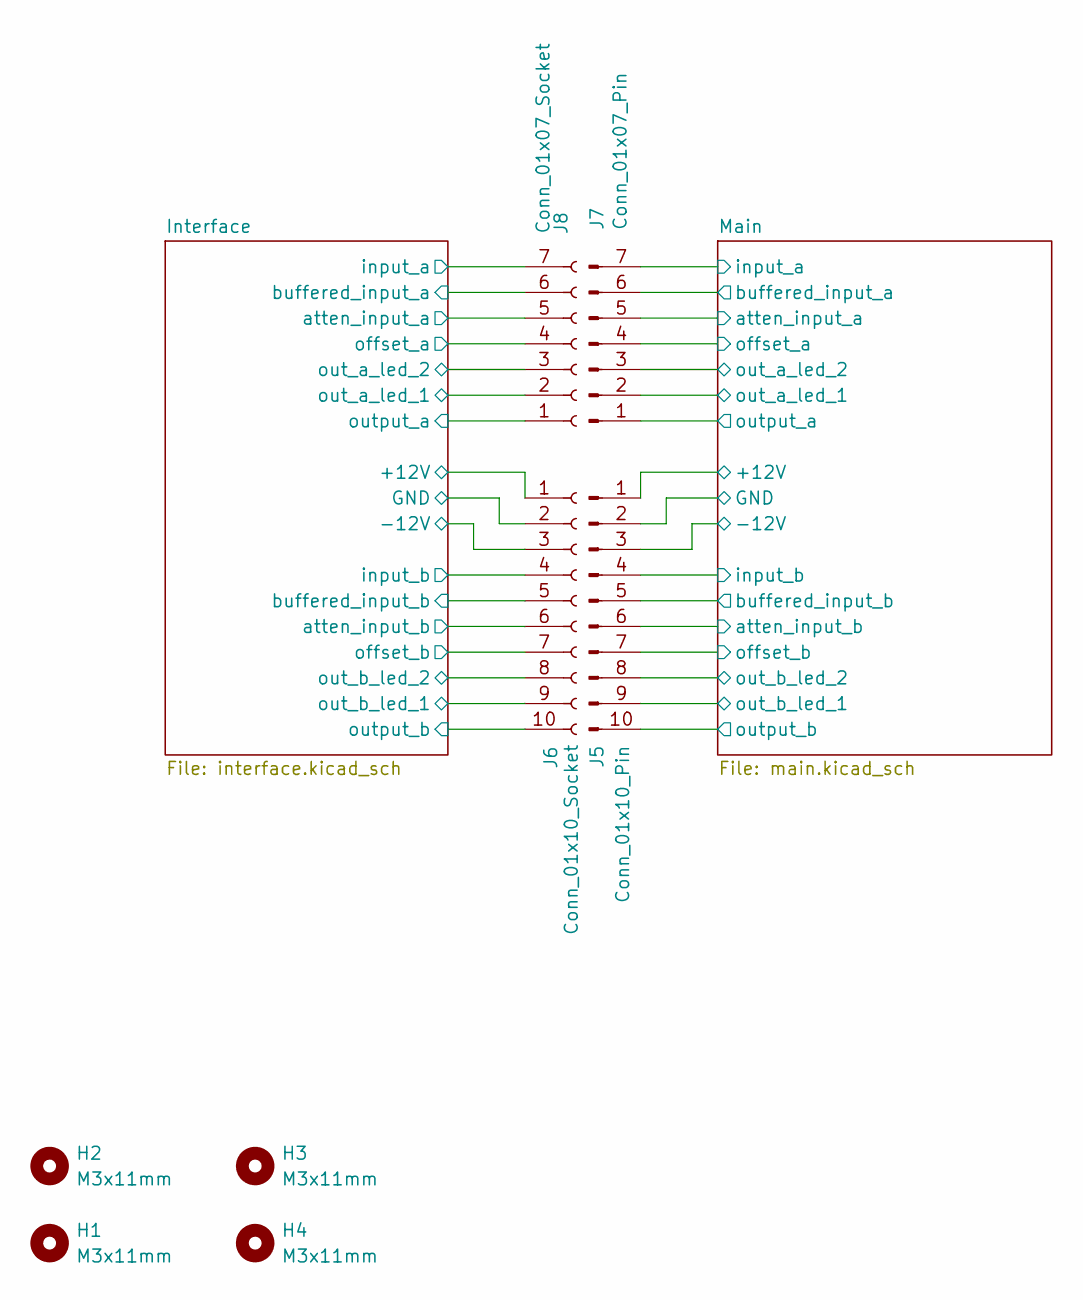
[picture p25: schematic offset_atten_pcb.kicad_sch, OffsetAtten]

Parts:
H1, H2, H3, H4: M3x11mm; MountingHole_3.2mm_M3
J5: Conn_01x10_Pin; PinSocket_1x10_P2.54mm_Vertical
J6: Conn_01x10_Socket; PinSocket_1x10_P2.54mm_Vertical
J7: Conn_01x07_Pin; PinSocket_1x07_P2.54mm_Vertical
J8: Conn_01x07_Socket; PinSocket_1x07_P2.54mm_Vertical

Connections:
/Interface/+12V: J6.1; also elsewhere on the board
/Interface/-12V: J6.3; also elsewhere on the board
/Interface/GND: J6.2; also elsewhere on the board
/Interface/atten_input_a: J8.5; also elsewhere on the board
/Interface/atten_input_b: J6.6; also elsewhere on the board
/Interface/buffered_input_a: J8.6; also elsewhere on the board
/Interface/buffered_input_b: J6.5; also elsewhere on the board
/Interface/input_a: J8.7; also elsewhere on the board
/Interface/input_b: J6.4; also elsewhere on the board
/Interface/offset_a: J8.4; also elsewhere on the board
/Interface/offset_b: J6.7; also elsewhere on the board
/Interface/out_a_led_1: J8.2; also elsewhere on the board
/Interface/out_a_led_2: J8.3; also elsewhere on the board
/Interface/out_b_led_1: J6.9; also elsewhere on the board
/Interface/out_b_led_2: J6.8; also elsewhere on the board
/Interface/output_a: J8.1; also elsewhere on the board
/Interface/output_b: J6.10; also elsewhere on the board
/Main/+12V: J5.1; also elsewhere on the board
/Main/-12V: J5.3; also elsewhere on the board
/Main/GND: J5.2; also elsewhere on the board
/Main/atten_input_a: J7.5; also elsewhere on the board
/Main/atten_input_b: J5.6; also elsewhere on the board
/Main/buffered_input_a: J7.6; also elsewhere on the board
/Main/buffered_input_b: J5.5; also elsewhere on the board
/Main/input_a: J7.7; also elsewhere on the board
/Main/input_b: J5.4; also elsewhere on the board
/Main/offset_a: J7.4; also elsewhere on the board
/Main/offset_b: J5.7; also elsewhere on the board
/Main/out_a_led_1: J7.2; also elsewhere on the board
/Main/out_a_led_2: J7.3; also elsewhere on the board
/Main/out_b_led_1: J5.9; also elsewhere on the board
/Main/out_b_led_2: J5.8; also elsewhere on the board
/Main/output_a: J7.1; also elsewhere on the board
/Main/output_b: J5.10; also elsewhere on the board

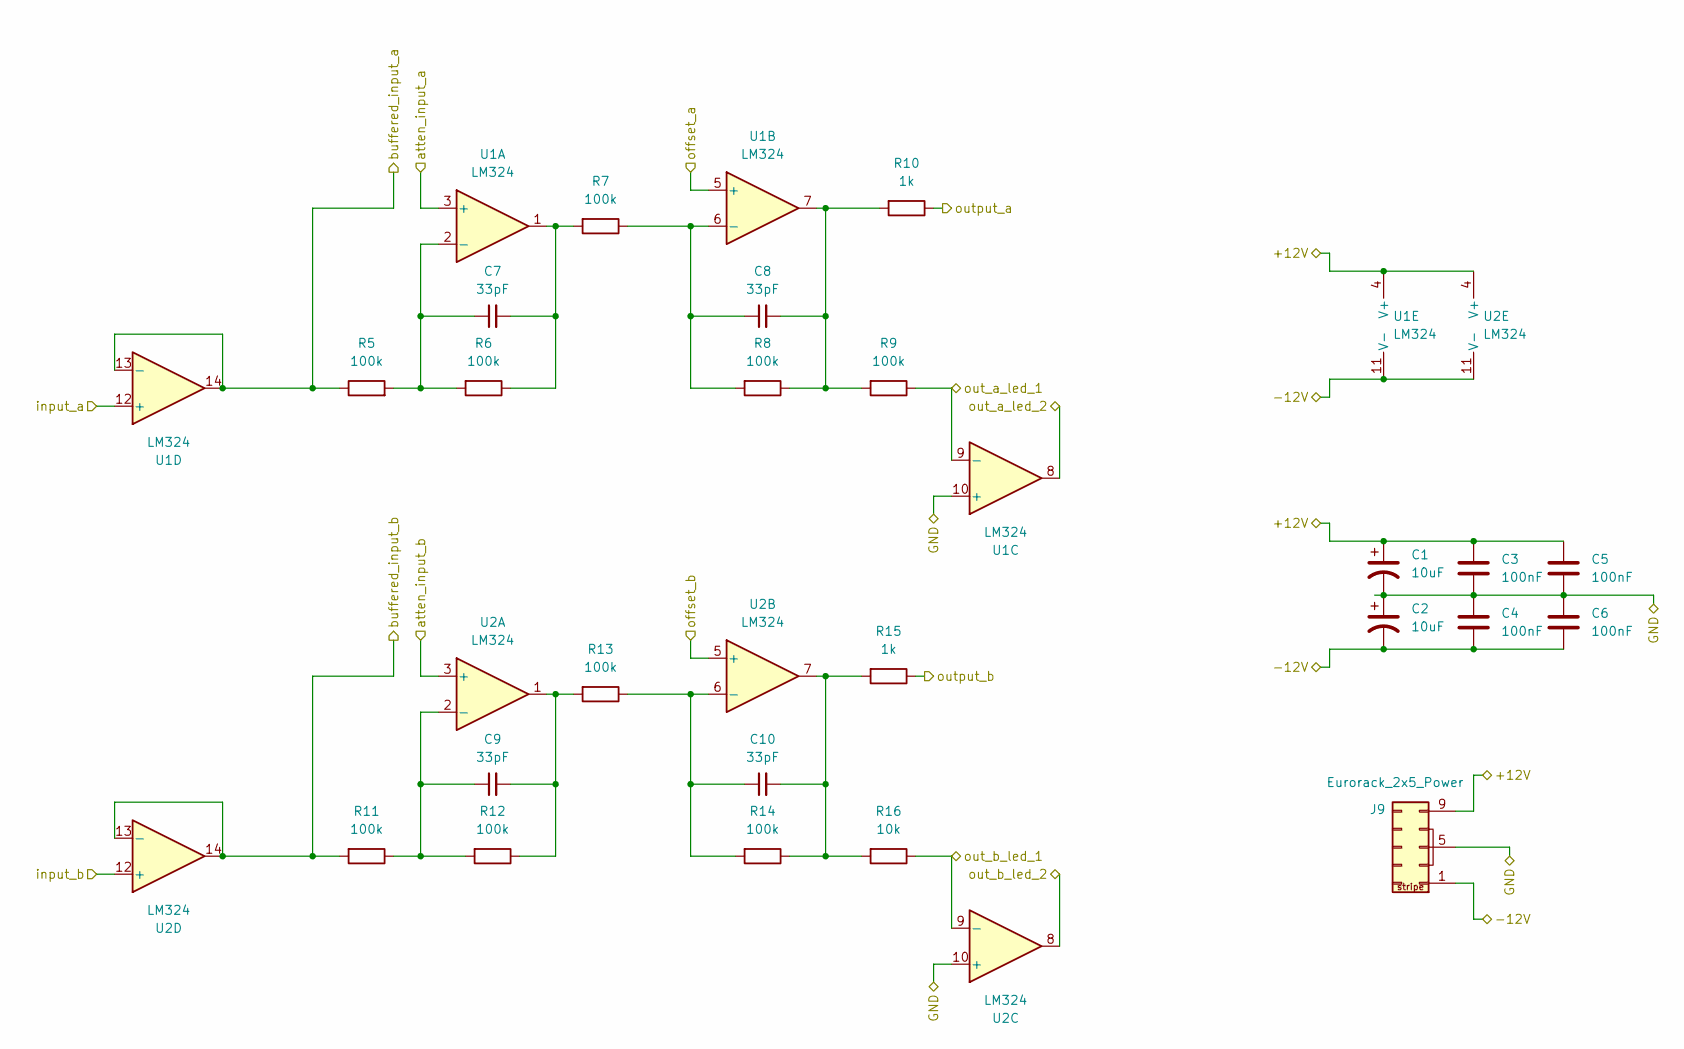
[picture p26: schematic main.kicad_sch, OffsetAtten]

Parts:
C1, C2: 10uF; CP_Radial_D4.0mm_P1.50mm
C3, C4, C5, C6: 100nF; C_Disc_D4.7mm_W2.5mm_P5.00mm
C7, C8, C9, C10: 33pF; C_Disc_D4.7mm_W2.5mm_P5.00mm
J9: Eurorack_2x5_Power; IDC-Header_2x05_P2.54mm_Vertical
R5, R6, R7, R8, R9, R11, R12, R13, R14: 100k; R_Axial_DIN0207_L6.3mm_D2.5mm_P10.16mm_Horizontal
R10, R15: 1k; R_Axial_DIN0207_L6.3mm_D2.5mm_P10.16mm_Horizontal
R16: 10k; R_Axial_DIN0207_L6.3mm_D2.5mm_P10.16mm_Horizontal
U1, U2: LM324; DIP-14_W7.62mm

Connections:
/Main/+12V: C1.1, C3.1, C5.1, J9.9 (+12v), J9.10 (+12v), U1.4 (V+), U2.4 (V+); also elsewhere on the board
/Main/-12V: C2.2, C4.2, C6.2, J9.1 (-12v), J9.2 (-12v), U1.11 (V-), U2.11 (V-); also elsewhere on the board
/Main/GND: C1.2, C2.1, C3.2, C4.1, C5.2, C6.1, J9.3 (GND), J9.4 (GND), J9.5 (GND), J9.6 (GND), J9.7 (GND), J9.8 (GND), U1.10 (+), U2.10 (+); also elsewhere on the board
/Main/atten_input_a: U1.3 (+); also elsewhere on the board
/Main/atten_input_b: U2.3 (+); also elsewhere on the board
/Main/buffered_input_a: R5.1, U1.13 (-), U1.14; also elsewhere on the board
/Main/buffered_input_b: R11.2, U2.13 (-), U2.14; also elsewhere on the board
/Main/input_a: U1.12 (+); also elsewhere on the board
/Main/input_b: U2.12 (+); also elsewhere on the board
/Main/offset_a: U1.5 (+); also elsewhere on the board
/Main/offset_b: U2.5 (+); also elsewhere on the board
/Main/out_a_led_1: R9.1, U1.9 (-); also elsewhere on the board
/Main/out_a_led_2: U1.8; also elsewhere on the board
/Main/out_b_led_1: R16.1, U2.9 (-); also elsewhere on the board
/Main/out_b_led_2: U2.8; also elsewhere on the board
/Main/output_a: R10.1; also elsewhere on the board
/Main/output_b: R15.1; also elsewhere on the board
unnamed: C7.2, R6.1, R7.2, U1.1
unnamed: C8.2, R8.1, R9.2, R10.2, U1.7
unnamed: C9.2, R12.1, R13.2, U2.1
unnamed: C10.2, R14.1, R15.2, R16.2, U2.7
unnamed: C7.1, R5.2, R6.2, U1.2 (-)
unnamed: C8.1, R7.1, R8.2, U1.6 (-)
unnamed: C9.1, R11.1, R12.2, U2.2 (-)
unnamed: C10.1, R13.1, R14.2, U2.6 (-)

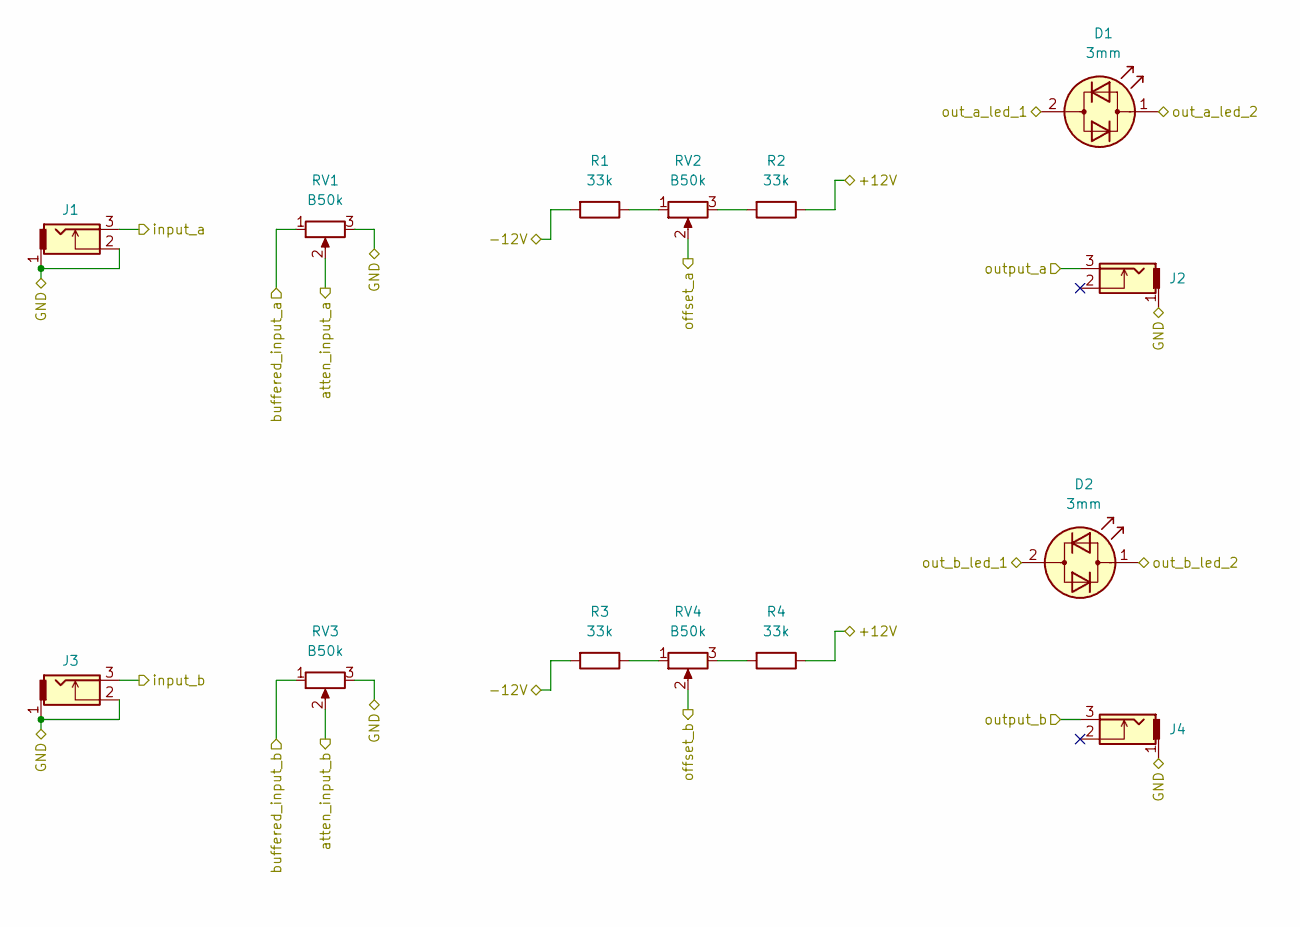
[picture p27: schematic interface.kicad_sch, OffsetAtten]

Parts:
D1, D2: 3mm; LED_D3.0mm_Clear
J1, J2, J3, J4: THONKICONN; THONKICONN_perf
R1, R2, R3, R4: 33k; R_Axial_DIN0207_L6.3mm_D2.5mm_P10.16mm_Horizontal
RV1, RV2, RV3, RV4: B50k; Alpha_Potentiometer_Grounded

Connections:
/Interface/+12V: R2.1, R4.1; also elsewhere on the board
/Interface/-12V: R1.2, R3.2; also elsewhere on the board
/Interface/GND: J1.1, J1.2, J2.1, J3.1, J3.2, J4.1, RV1.3, RV1.MP, RV2.MP, RV3.3, RV4.MP; also elsewhere on the board
/Interface/atten_input_a: RV1.2; also elsewhere on the board
/Interface/atten_input_b: RV3.2; also elsewhere on the board
/Interface/buffered_input_a: RV1.1; also elsewhere on the board
/Interface/buffered_input_b: RV3.1; also elsewhere on the board
/Interface/input_a: J1.3; also elsewhere on the board
/Interface/input_b: J3.3; also elsewhere on the board
/Interface/offset_a: RV2.2; also elsewhere on the board
/Interface/offset_b: RV4.2; also elsewhere on the board
/Interface/out_a_led_1: D1.2 (AK); also elsewhere on the board
/Interface/out_a_led_2: D1.1 (KA); also elsewhere on the board
/Interface/out_b_led_1: D2.2 (AK); also elsewhere on the board
/Interface/out_b_led_2: D2.1 (KA); also elsewhere on the board
/Interface/output_a: J2.3; also elsewhere on the board
/Interface/output_b: J4.3; also elsewhere on the board
unnamed: R1.1, RV2.1
unnamed: R2.2, RV2.3
unnamed: R3.1, RV4.1
unnamed: R4.2, RV4.3

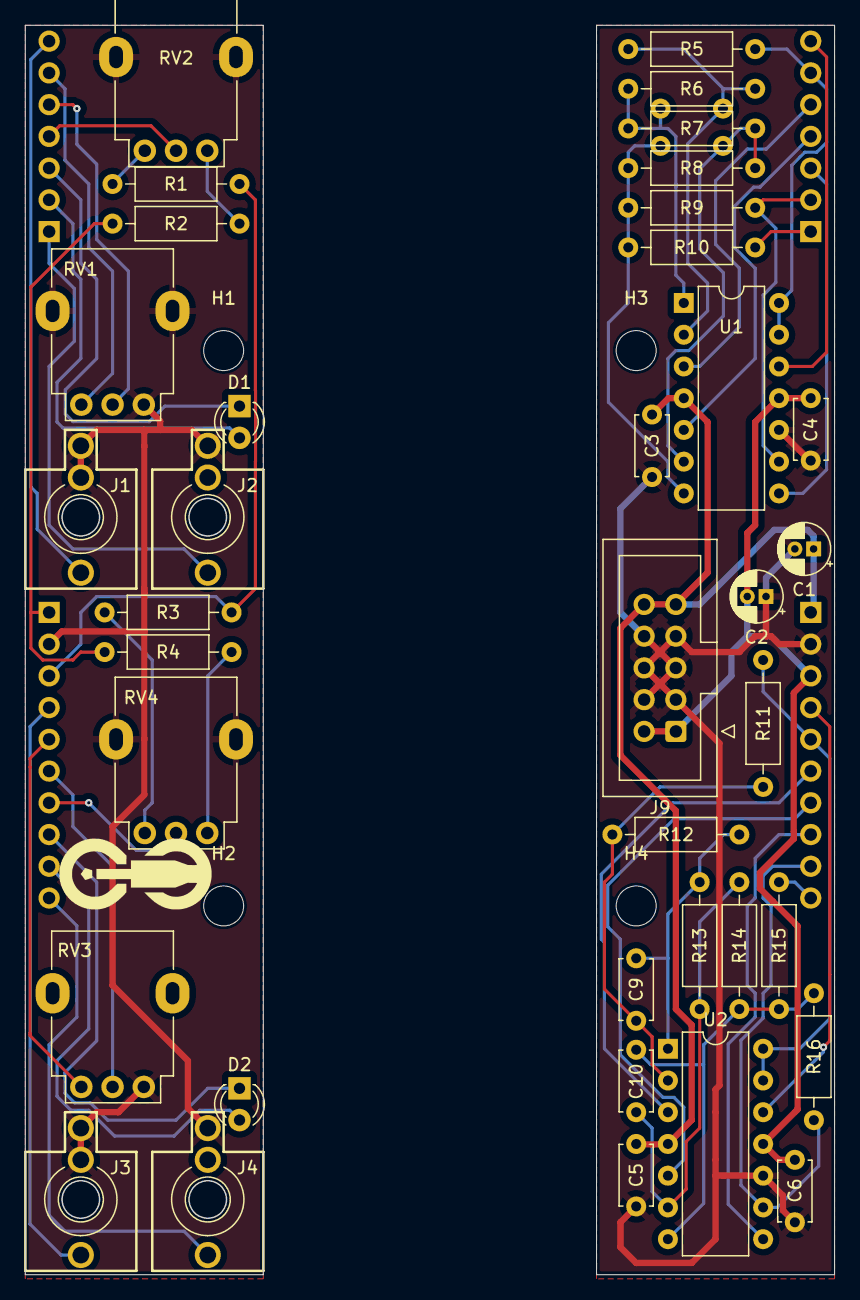
[picture p28: board offset_atten_pcb.kicad_pcb from above]

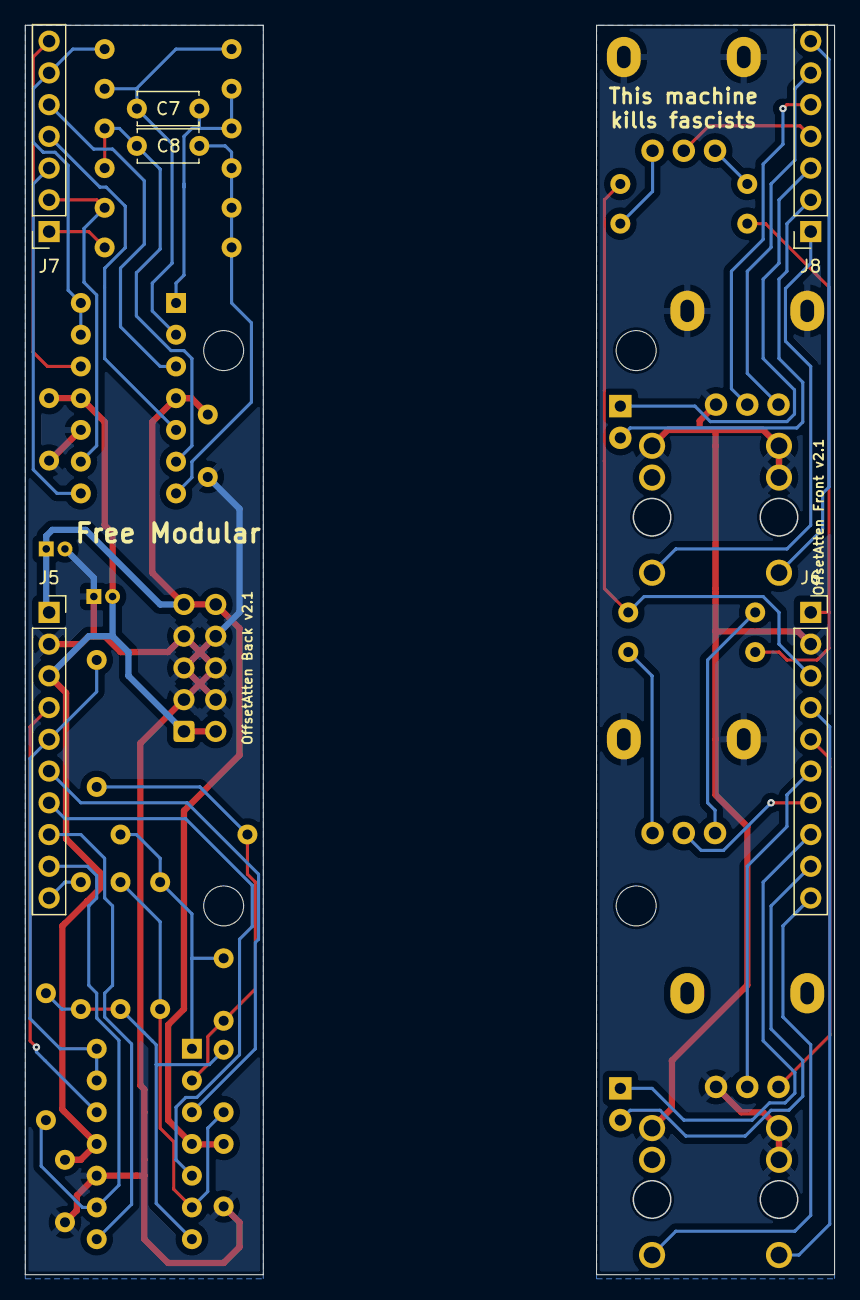
[picture p29: board offset_atten_pcb.kicad_pcb from below]

Board: 2 copper layers, 64.8 x 100.0 mm, 50 parts (6 on the bottom side), 46 nets.

Other parts of the board:
B1, B2: Board
G1: logo_small
