QuinnFreedman/modular/modules/Output/PCBs/output_pcb/output_pcb.kicad_pcb

## KiCad design modules/Output/PCBs/output_pcb/output_pcb.kicad_pcb (2025-03-09)

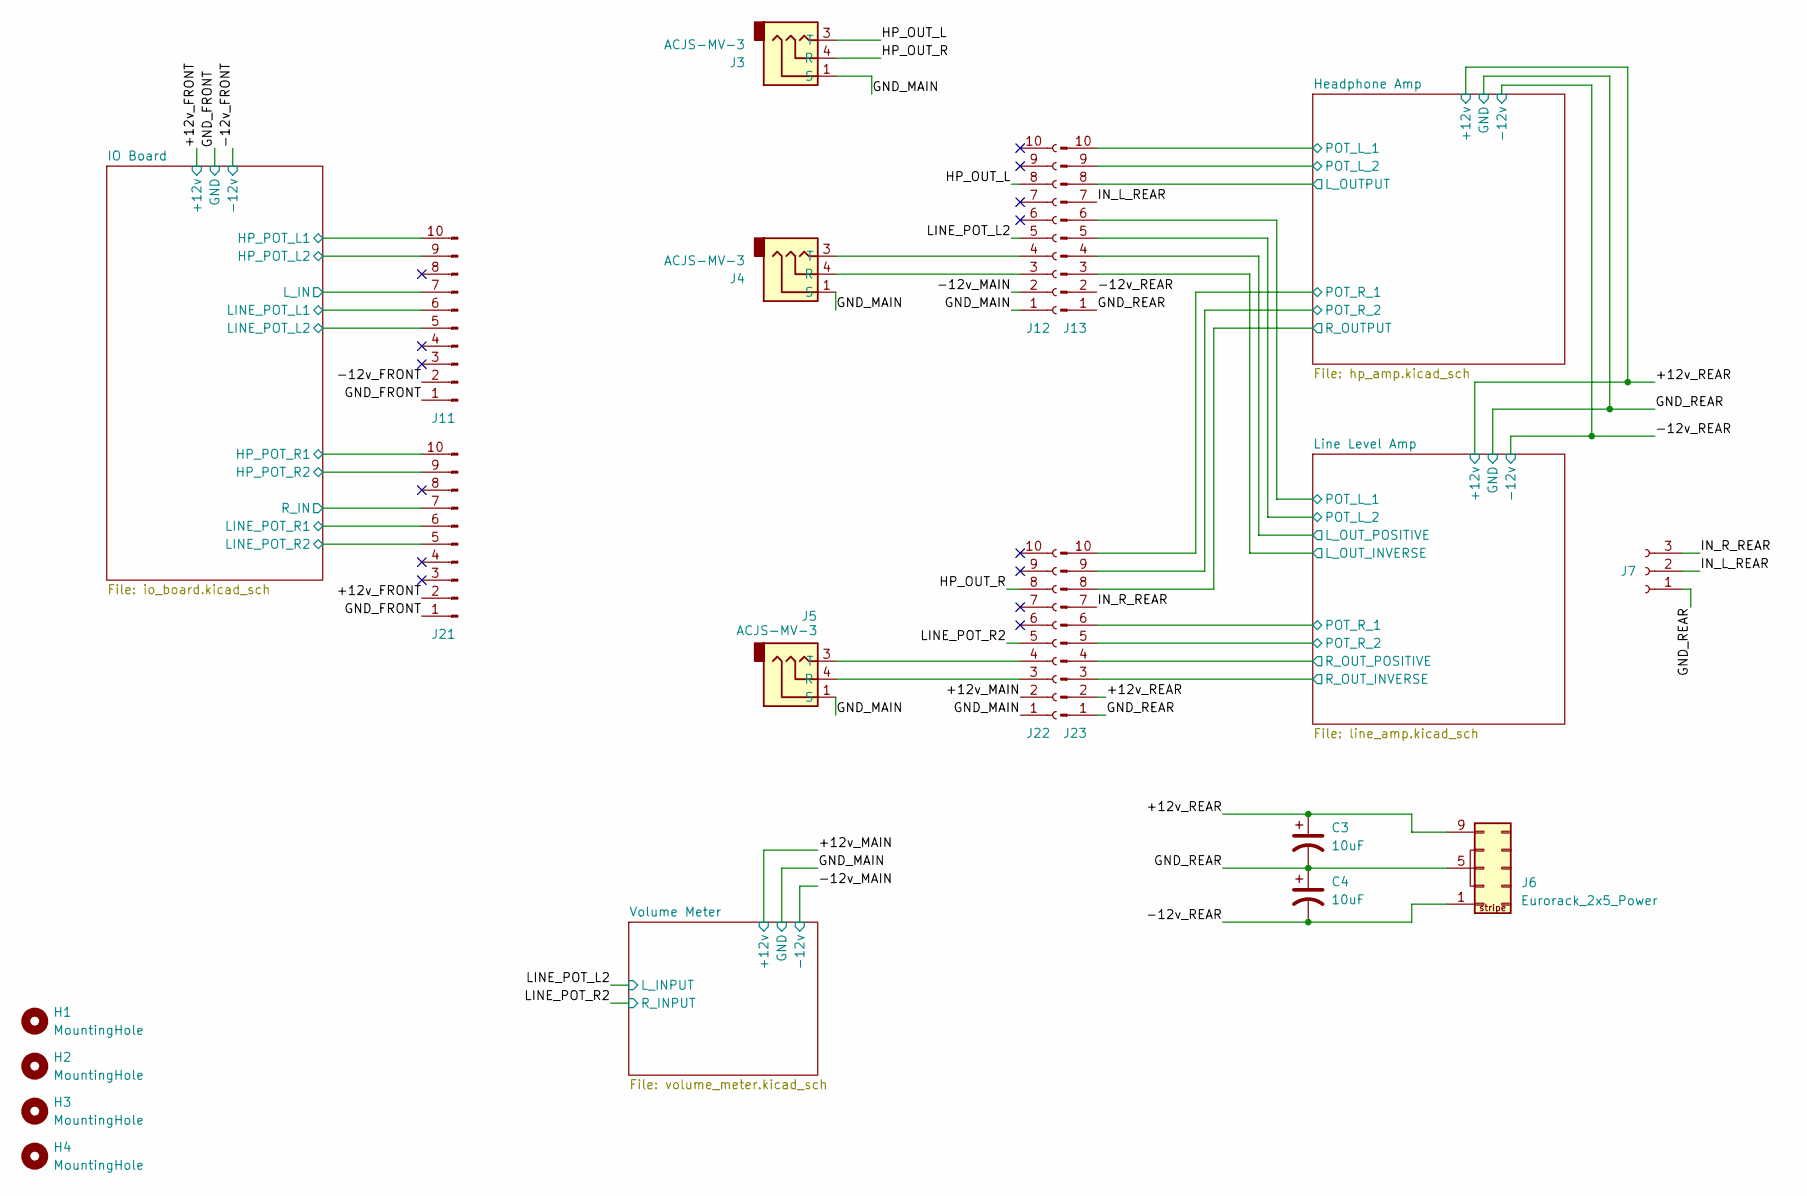
[picture p30: schematic output_pcb.kicad_sch, Output]

Parts:
C3, C4: 10uF; CP_Radial_D4.0mm_P1.50mm
H1, H2, H3, H4: MountingHole; MountingHole_2.7mm_M2.5
J3, J4, J5: ACJS-MV-3; Jack_6.35mm_ACJS-MV
J6: Eurorack_2x5_Power; IDC-Header_2x05_P2.54mm_Vertical
J7: Conn_01x03_Socket; PinHeader_1x03_P2.54mm_Vertical
J11, J13, J21, J23: Conn_01x10_Pin; PinHeader_1x10_P2.54mm_Vertical
J12, J22: Conn_01x10_Socket; PinHeader_1x10_P2.54mm_Vertical

Connections:
/+12v_FRONT: J21.2; also elsewhere on the board
/+12v_MAIN: J22.2; also elsewhere on the board
/+12v_REAR: C3.1, J6.9 (+12v), J6.10 (+12v), J23.2; also elsewhere on the board
/-12v_FRONT: J11.2; also elsewhere on the board
/-12v_MAIN: J12.2; also elsewhere on the board
/-12v_REAR: C4.2, J6.1 (-12v), J6.2 (-12v), J13.2; also elsewhere on the board
/GND_FRONT: J11.1, J21.1; also elsewhere on the board
/GND_MAIN: J3.1 (S), J4.1 (S), J5.1 (S), J12.1, J22.1; also elsewhere on the board
/GND_REAR: C3.2, C4.1, J6.3 (GND), J6.4 (GND), J6.5 (GND), J6.6 (GND), J6.7 (GND), J6.8 (GND), J7.1, J13.1, J23.1; also elsewhere on the board
/HP_OUT_L: J3.3 (T), J12.8
/HP_OUT_R: J3.4 (R), J22.8
/Headphone Amp/L_OUTPUT: J13.8; also elsewhere on the board
/Headphone Amp/POT_L_1: J13.10; also elsewhere on the board
/Headphone Amp/POT_L_2: J13.9; also elsewhere on the board
/Headphone Amp/POT_R_1: J23.10; also elsewhere on the board
/Headphone Amp/POT_R_2: J23.9; also elsewhere on the board
/Headphone Amp/R_OUTPUT: J23.8; also elsewhere on the board
/IN_L_REAR: J7.2, J13.7
/IN_R_REAR: J7.3, J23.7
/IO Board/HP_POT_L1: J11.10; also elsewhere on the board
/IO Board/HP_POT_L2: J11.9; also elsewhere on the board
/IO Board/HP_POT_R1: J21.10; also elsewhere on the board
/IO Board/HP_POT_R2: J21.9; also elsewhere on the board
/IO Board/LINE_POT_L1: J11.6; also elsewhere on the board
/IO Board/LINE_POT_L2: J11.5; also elsewhere on the board
/IO Board/LINE_POT_R1: J21.6; also elsewhere on the board
/IO Board/LINE_POT_R2: J21.5; also elsewhere on the board
/IO Board/L_IN: J11.7; also elsewhere on the board
/IO Board/R_IN: J21.7; also elsewhere on the board
/LINE_POT_L2: J12.5; also elsewhere on the board
/LINE_POT_R2: J22.5; also elsewhere on the board
/Line Level Amp/L_OUT_INVERSE: J13.3; also elsewhere on the board
/Line Level Amp/L_OUT_POSITIVE: J13.4; also elsewhere on the board
/Line Level Amp/POT_L_1: J13.6; also elsewhere on the board
/Line Level Amp/POT_L_2: J13.5; also elsewhere on the board
/Line Level Amp/POT_R_1: J23.6; also elsewhere on the board
/Line Level Amp/POT_R_2: J23.5; also elsewhere on the board
/Line Level Amp/R_OUT_INVERSE: J23.3; also elsewhere on the board
/Line Level Amp/R_OUT_POSITIVE: J23.4; also elsewhere on the board
unnamed: J4.4 (R), J12.3
unnamed: J4.3 (T), J12.4
unnamed: J5.4 (R), J22.3
unnamed: J5.3 (T), J22.4

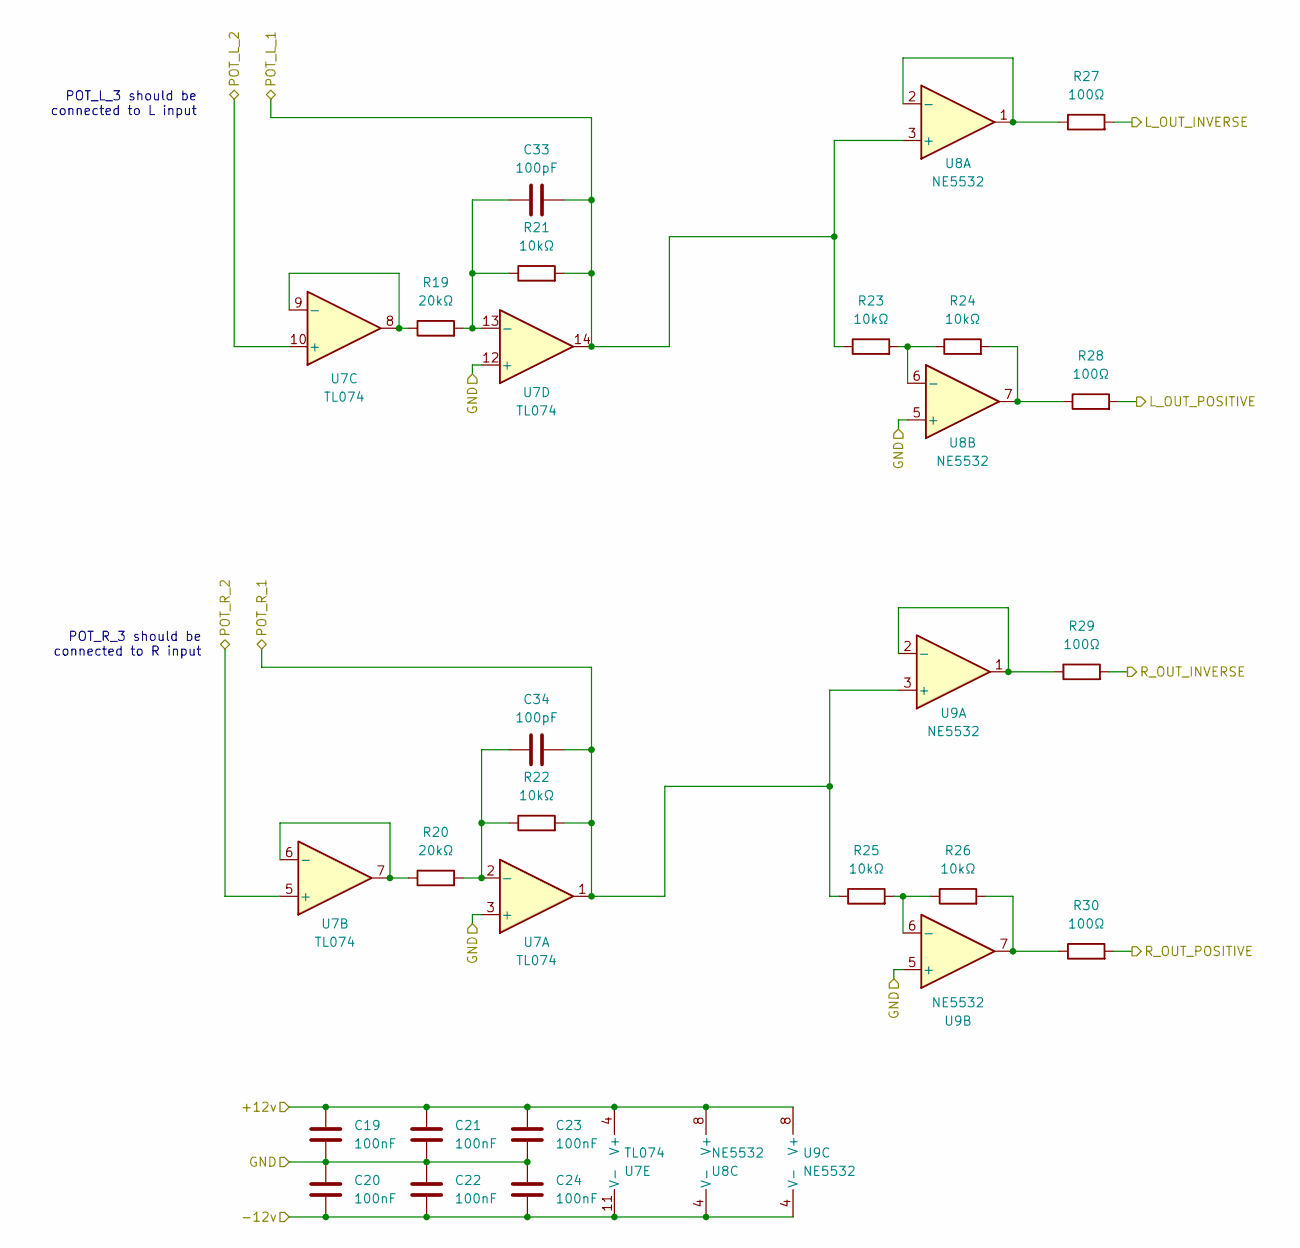
[picture p31: schematic line_amp.kicad_sch, Output]

Parts:
C19, C20, C21, C22, C23, C24: 100nF; C_Disc_D4.7mm_W2.5mm_P5.00mm
C33, C34: 100pF; C_Disc_D4.7mm_W2.5mm_P5.00mm
R19, R20: 20kΩ; R_Axial_DIN0207_L6.3mm_D2.5mm_P10.16mm_Horizontal
R21, R22, R23, R24, R25, R26: 10kΩ; R_Axial_DIN0207_L6.3mm_D2.5mm_P10.16mm_Horizontal
R27, R28, R29, R30: 100Ω; R_Axial_DIN0207_L6.3mm_D2.5mm_P10.16mm_Horizontal
U7: TL074; DIP-14_W7.62mm
U8, U9: NE5532; DIP-8_W7.62mm

Connections:
/+12v_REAR: C19.2, C21.2, C23.2, U7.4 (V+), U8.8 (V+), U9.8 (V+); also elsewhere on the board
/-12v_REAR: C20.1, C22.1, C24.1, U7.11 (V-), U8.4 (V-), U9.4 (V-); also elsewhere on the board
/GND_REAR: C19.1, C20.2, C21.1, C22.2, C23.1, C24.2, U7.3 (+), U7.12 (+), U8.5 (+), U9.5 (+); also elsewhere on the board
/Line Level Amp/L_OUT_INVERSE: R27.2; also elsewhere on the board
/Line Level Amp/L_OUT_POSITIVE: R28.2; also elsewhere on the board
/Line Level Amp/POT_L_1: C33.2, R21.2, R23.1, U7.14, U8.3 (+); also elsewhere on the board
/Line Level Amp/POT_L_2: U7.10 (+); also elsewhere on the board
/Line Level Amp/POT_R_1: C34.2, R22.2, R25.1, U7.1, U9.3 (+); also elsewhere on the board
/Line Level Amp/POT_R_2: U7.5 (+); also elsewhere on the board
/Line Level Amp/R_OUT_INVERSE: R29.2; also elsewhere on the board
/Line Level Amp/R_OUT_POSITIVE: R30.2; also elsewhere on the board
unnamed: R24.2, R28.1, U8.7
unnamed: R26.2, R30.1, U9.7
unnamed: C34.1, R20.2, R22.1, U7.2 (-)
unnamed: R20.1, U7.6 (-), U7.7
unnamed: R19.1, U7.8, U7.9 (-)
unnamed: C33.1, R19.2, R21.1, U7.13 (-)
unnamed: R27.1, U8.1, U8.2 (-)
unnamed: R23.2, R24.1, U8.6 (-)
unnamed: R29.1, U9.1, U9.2 (-)
unnamed: R25.2, R26.1, U9.6 (-)

Notes on the sheet:
POT_R_3 should be connected to R input
POT_L_3 should be connected to L input

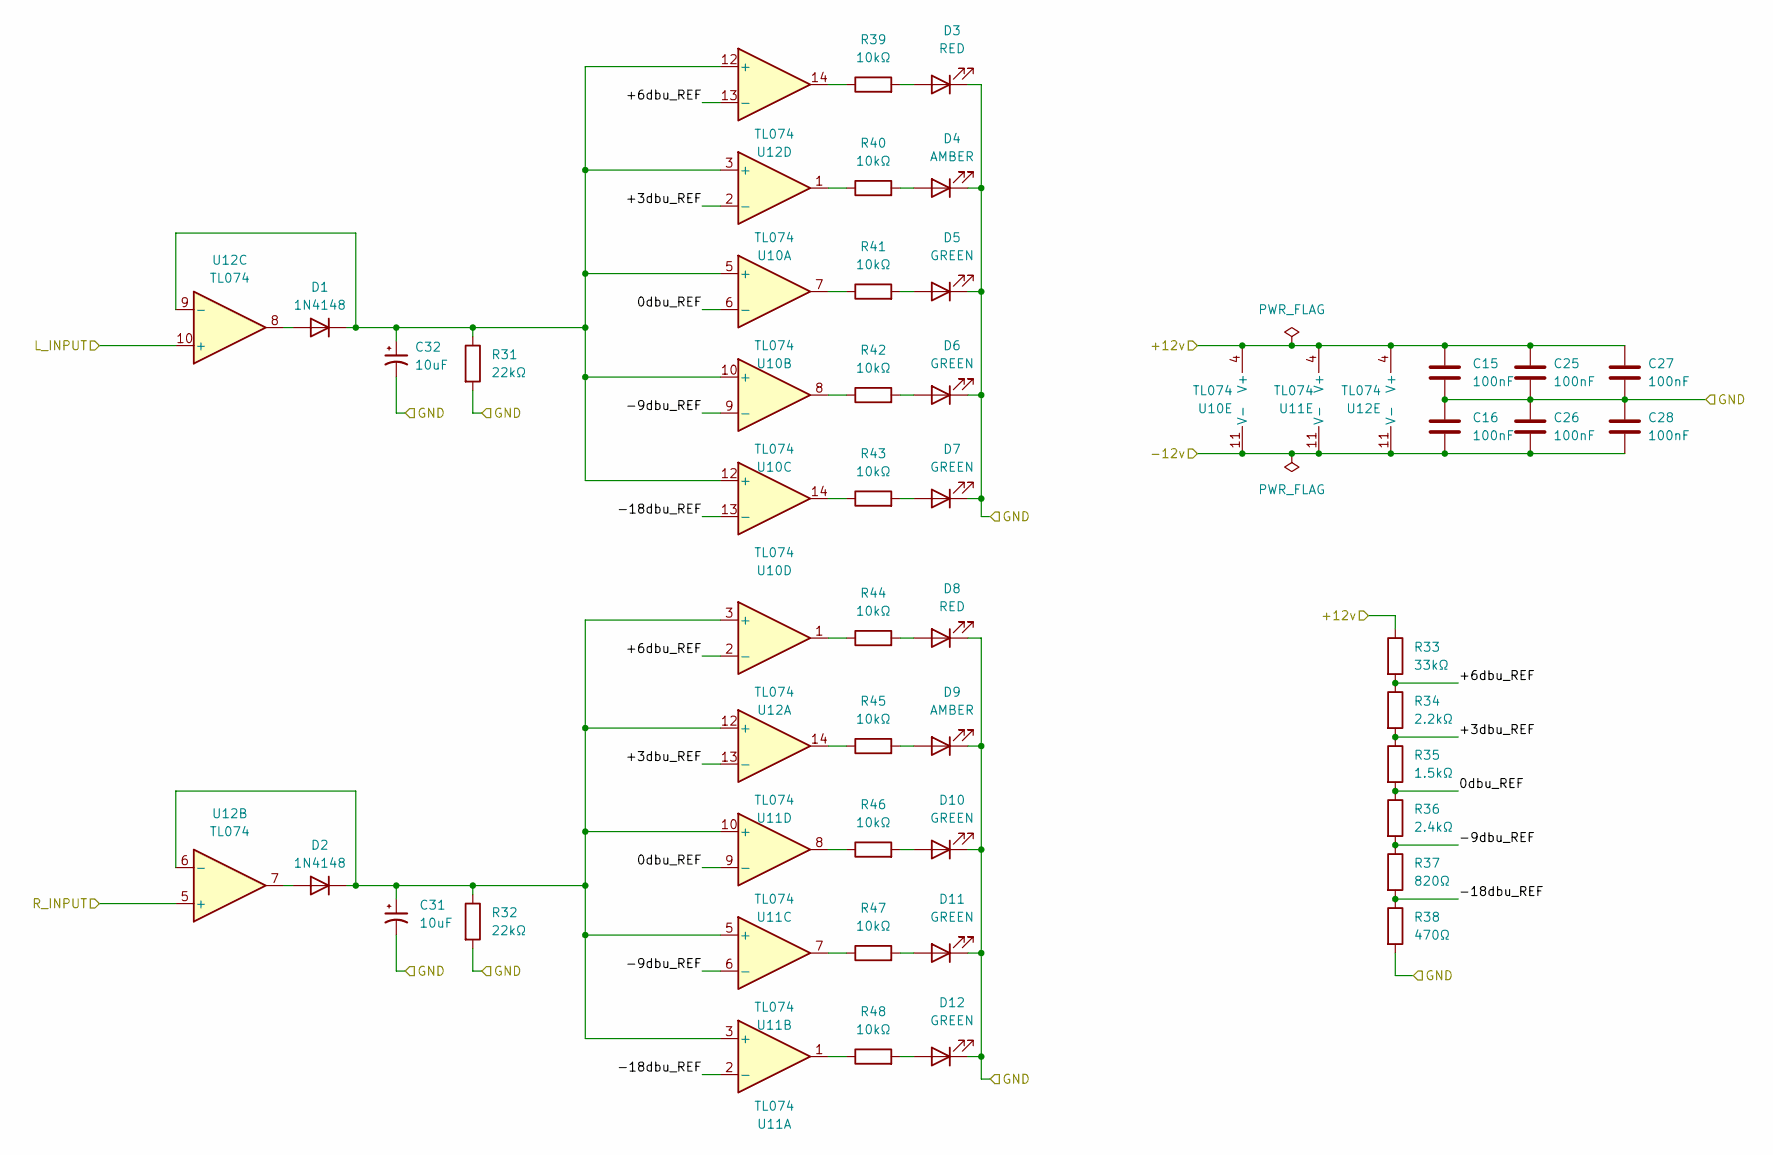
[picture p32: schematic volume_meter.kicad_sch, Output]

Parts:
C15, C16, C25, C26, C27, C28: 100nF; C_Disc_D4.7mm_W2.5mm_P5.00mm
C31, C32: 10uF; CP_Radial_D4.0mm_P1.50mm
D1, D2: 1N4148; D_A-405_P7.62mm_Horizontal
D3, D8: RED; LED_D3.0mm
D4, D9: AMBER; LED_D3.0mm
D5, D6, D7, D10, D11, D12: GREEN; LED_D3.0mm
R31, R32: 22kΩ; R_Axial_DIN0207_L6.3mm_D2.5mm_P10.16mm_Horizontal
R33: 33kΩ; R_Axial_DIN0207_L6.3mm_D2.5mm_P10.16mm_Horizontal
R34: 2.2kΩ; R_Axial_DIN0207_L6.3mm_D2.5mm_P10.16mm_Horizontal
R35: 1.5kΩ; R_Axial_DIN0207_L6.3mm_D2.5mm_P10.16mm_Horizontal
R36: 2.4kΩ; R_Axial_DIN0207_L6.3mm_D2.5mm_P10.16mm_Horizontal
R37: 820Ω; R_Axial_DIN0207_L6.3mm_D2.5mm_P10.16mm_Horizontal
R38: 470Ω; R_Axial_DIN0207_L6.3mm_D2.5mm_P10.16mm_Horizontal
R39, R40, R41, R42, R43, R44, R45, R46, R47, R48: 10kΩ; R_Axial_DIN0207_L6.3mm_D2.5mm_P10.16mm_Horizontal
U10, U11, U12: TL074; DIP-14_W7.62mm

Connections:
/+12v_MAIN: C15.1, C25.1, C27.1, R33.1, U10.4 (V+), U11.4 (V+), U12.4 (V+); also elsewhere on the board
/-12v_MAIN: C16.2, C26.2, C28.2, U10.11 (V-), U11.11 (V-), U12.11 (V-); also elsewhere on the board
/GND_MAIN: C15.2, C16.1, C25.2, C26.1, C27.2, C28.1, C31.2, C32.2, D3.1 (K), D4.1 (K), D5.1 (K), D6.1 (K), D7.1 (K), D8.1 (K), D9.1 (K), D10.1 (K), D11.1 (K), D12.1 (K), R31.2, R32.2, R38.2; also elsewhere on the board
/LINE_POT_L2: U12.10 (+); also elsewhere on the board
/LINE_POT_R2: U12.5 (+); also elsewhere on the board
/Volume Meter/0dbu_REF: R35.2, R36.1, U10.6 (-), U11.9 (-)
/Volume Meter/+3dbu_REF: R34.2, R35.1, U10.2 (-), U11.13 (-)
/Volume Meter/+6dbu_REF: R33.2, R34.1, U12.2 (-), U12.13 (-)
/Volume Meter/-9dbu_REF: R36.2, R37.1, U10.9 (-), U11.6 (-)
/Volume Meter/-18dbu_REF: R37.2, R38.1, U10.13 (-), U11.2 (-)
unnamed: D1.2 (A), U12.8
unnamed: C32.1, D1.1 (K), R31.1, U10.3 (+), U10.5 (+), U10.10 (+), U10.12 (+), U12.9 (-), U12.12 (+)
unnamed: D2.2 (A), U12.7
unnamed: C31.1, D2.1 (K), R32.1, U11.3 (+), U11.5 (+), U11.10 (+), U11.12 (+), U12.3 (+), U12.6 (-)
unnamed: D3.2 (A), R39.2
unnamed: D4.2 (A), R40.2
unnamed: D5.2 (A), R41.2
unnamed: D6.2 (A), R42.2
unnamed: D7.2 (A), R43.2
unnamed: D8.2 (A), R44.2
unnamed: D9.2 (A), R45.2
unnamed: D10.2 (A), R46.2
unnamed: D11.2 (A), R47.2
unnamed: D12.2 (A), R48.2
unnamed: R39.1, U12.14
unnamed: R40.1, U10.1
unnamed: R41.1, U10.7
unnamed: R42.1, U10.8
unnamed: R43.1, U10.14
unnamed: R44.1, U12.1
unnamed: R45.1, U11.14
unnamed: R46.1, U11.8
unnamed: R47.1, U11.7
unnamed: R48.1, U11.1

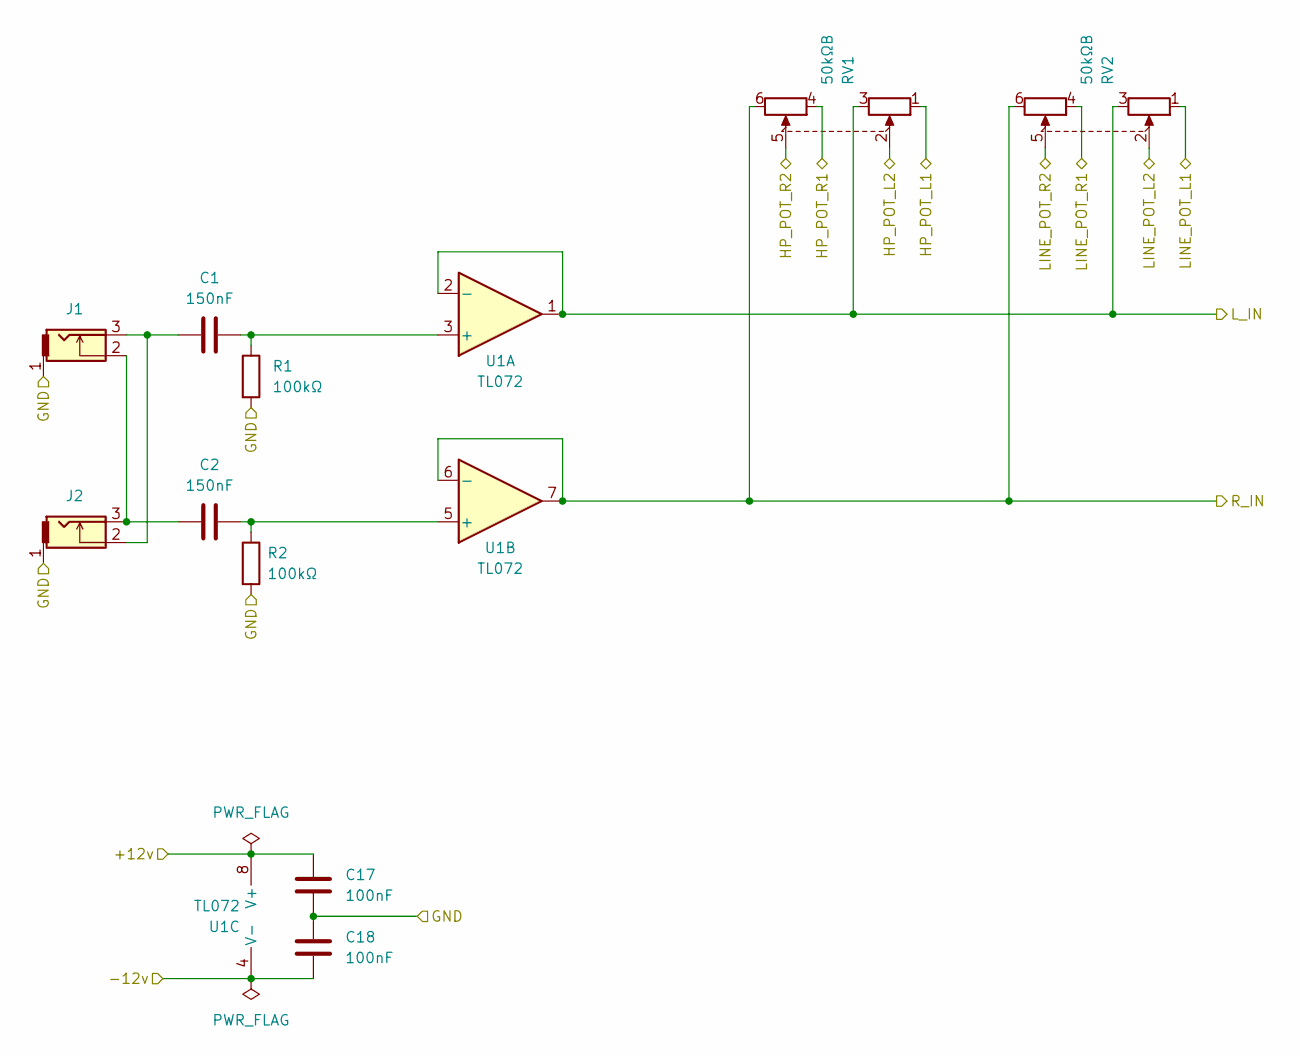
[picture p33: schematic io_board.kicad_sch, Output]

Parts:
C1, C2: 150nF; C_Disc_D4.7mm_W2.5mm_P5.00mm
C17, C18: 100nF; C_Disc_D4.7mm_W2.5mm_P5.00mm
J1, J2: THONKICONN
R1, R2: 100kΩ; R_Axial_DIN0207_L6.3mm_D2.5mm_P10.16mm_Horizontal
RV1, RV2: 50kΩB; Potentiometer_Alpha_RD902F-40-00D_Dual_Vertical
U1: TL072; DIP-8_W7.62mm

Connections:
/+12v_FRONT: C17.1, U1.8 (V+); also elsewhere on the board
/-12v_FRONT: C18.2, U1.4 (V-); also elsewhere on the board
/GND_FRONT: C17.2, C18.1, J1.1, J2.1, R1.2, R2.2; also elsewhere on the board
/IO Board/HP_POT_L1: RV1.1; also elsewhere on the board
/IO Board/HP_POT_L2: RV1.2; also elsewhere on the board
/IO Board/HP_POT_R1: RV1.4; also elsewhere on the board
/IO Board/HP_POT_R2: RV1.5; also elsewhere on the board
/IO Board/LINE_POT_L1: RV2.1; also elsewhere on the board
/IO Board/LINE_POT_L2: RV2.2; also elsewhere on the board
/IO Board/LINE_POT_R1: RV2.4; also elsewhere on the board
/IO Board/LINE_POT_R2: RV2.5; also elsewhere on the board
/IO Board/L_IN: RV1.3, RV2.3, U1.1, U1.2 (-); also elsewhere on the board
/IO Board/R_IN: RV1.6, RV2.6, U1.6 (-), U1.7; also elsewhere on the board
unnamed: C1.1, J1.3, J2.2
unnamed: C2.1, J1.2, J2.3
unnamed: C1.2, R1.1, U1.3 (+)
unnamed: C2.2, R2.1, U1.5 (+)

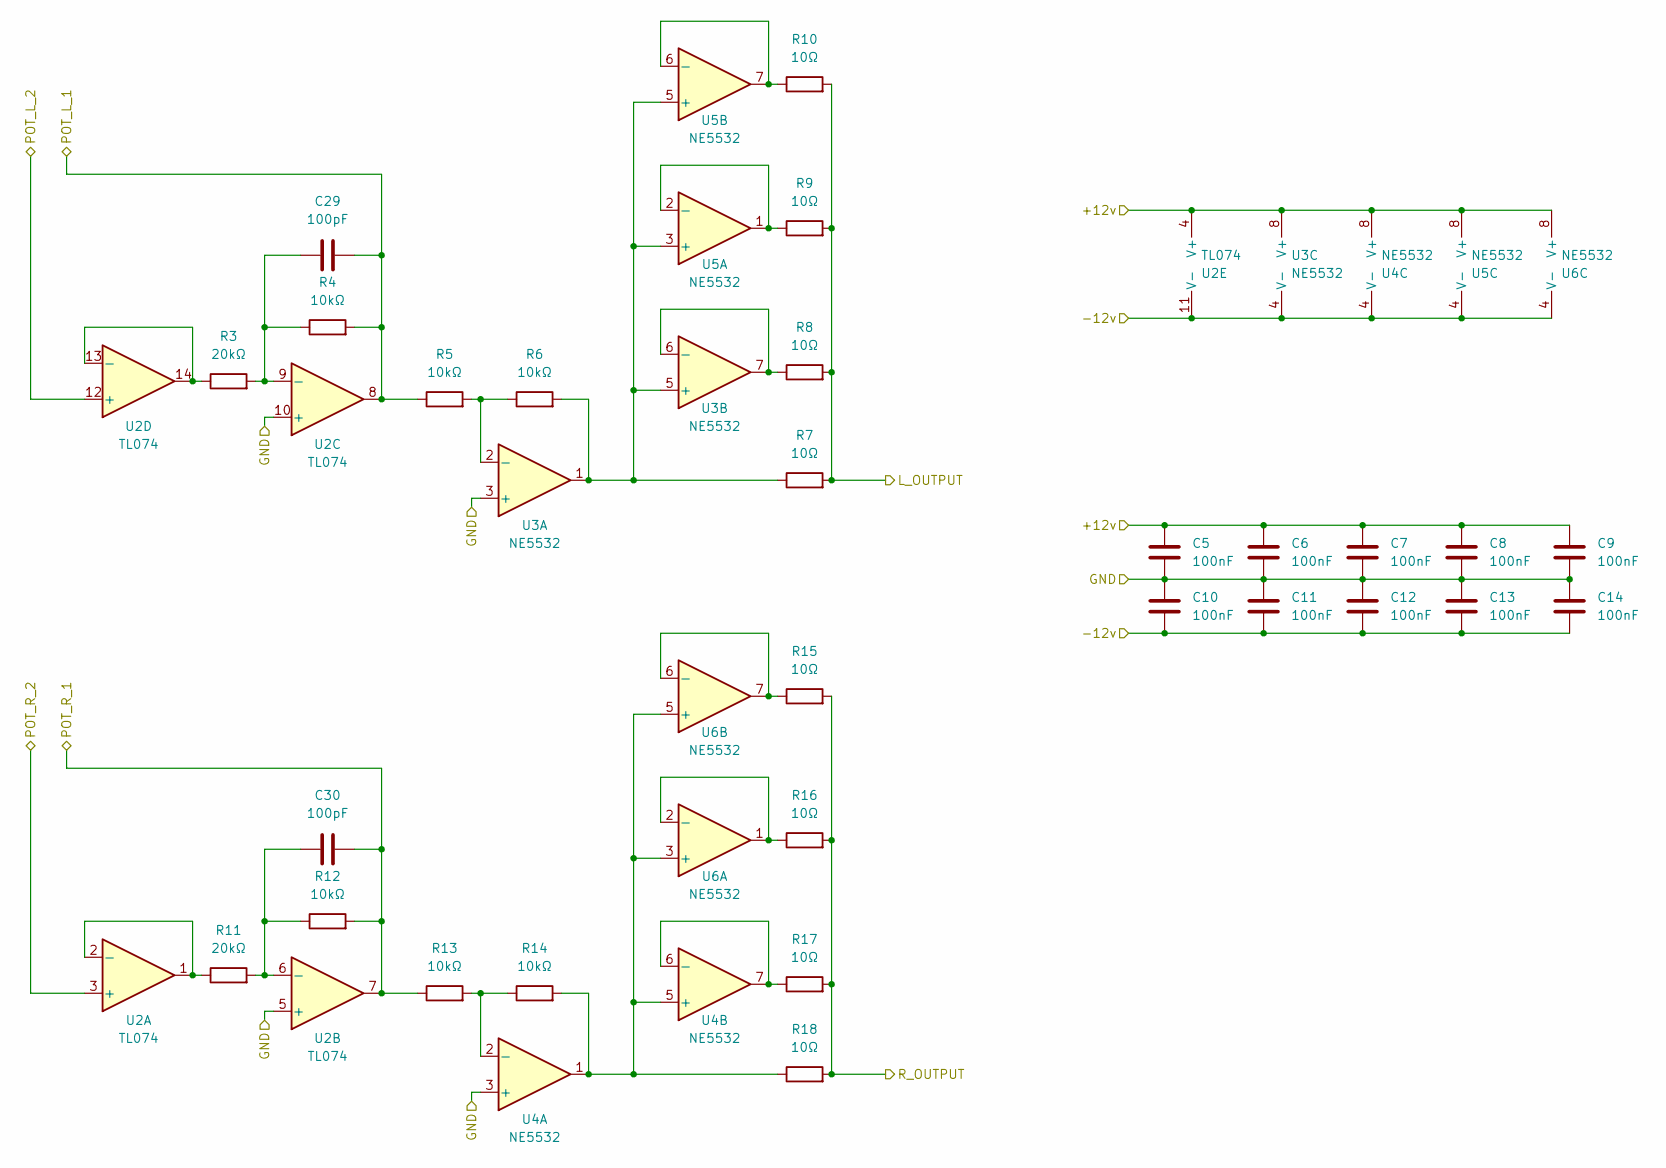
[picture p34: schematic hp_amp.kicad_sch, Output]

Parts:
C5, C6, C7, C8, C9, C10, C11, C12, C13, C14: 100nF; C_Disc_D4.7mm_W2.5mm_P5.00mm
C29, C30: 100pF; C_Disc_D4.7mm_W2.5mm_P5.00mm
R3, R11: 20kΩ; R_Axial_DIN0207_L6.3mm_D2.5mm_P10.16mm_Horizontal
R4, R5, R6, R12, R13, R14: 10kΩ; R_Axial_DIN0207_L6.3mm_D2.5mm_P10.16mm_Horizontal
R7, R8, R9, R10, R15, R16, R17, R18: 10Ω; R_Axial_DIN0207_L6.3mm_D2.5mm_P10.16mm_Horizontal
U2: TL074; DIP-14_W7.62mm
U3, U4, U5, U6: NE5532; DIP-8_W7.62mm

Connections:
/+12v_REAR: C5.2, C6.2, C7.2, C8.2, C9.2, U2.4 (V+), U3.8 (V+), U4.8 (V+), U5.8 (V+), U6.8 (V+); also elsewhere on the board
/-12v_REAR: C10.1, C11.1, C12.1, C13.1, C14.1, U2.11 (V-), U3.4 (V-), U4.4 (V-), U5.4 (V-), U6.4 (V-); also elsewhere on the board
/GND_REAR: C5.1, C6.1, C7.1, C8.1, C9.1, C10.2, C11.2, C12.2, C13.2, C14.2, U2.5 (+), U2.10 (+), U3.3 (+), U4.3 (+); also elsewhere on the board
/Headphone Amp/L_OUTPUT: R7.2, R8.2, R9.2, R10.2; also elsewhere on the board
/Headphone Amp/POT_L_1: C29.2, R4.2, R5.1, U2.8; also elsewhere on the board
/Headphone Amp/POT_L_2: U2.12 (+); also elsewhere on the board
/Headphone Amp/POT_R_1: C30.2, R12.2, R13.1, U2.7; also elsewhere on the board
/Headphone Amp/POT_R_2: U2.3 (+); also elsewhere on the board
/Headphone Amp/R_OUTPUT: R15.2, R16.2, R17.2, R18.2; also elsewhere on the board
unnamed: R11.1, U2.1, U2.2 (-)
unnamed: C30.1, R11.2, R12.1, U2.6 (-)
unnamed: C29.1, R3.2, R4.1, U2.9 (-)
unnamed: R3.1, U2.13 (-), U2.14
unnamed: R5.2, R6.1, U3.2 (-)
unnamed: R6.2, R7.1, U3.1, U3.5 (+), U5.3 (+), U5.5 (+)
unnamed: R8.1, U3.6 (-), U3.7
unnamed: R13.2, R14.1, U4.2 (-)
unnamed: R14.2, R18.1, U4.1, U4.5 (+), U6.3 (+), U6.5 (+)
unnamed: R17.1, U4.6 (-), U4.7
unnamed: R9.1, U5.1, U5.2 (-)
unnamed: R10.1, U5.6 (-), U5.7
unnamed: R16.1, U6.1, U6.2 (-)
unnamed: R15.1, U6.6 (-), U6.7

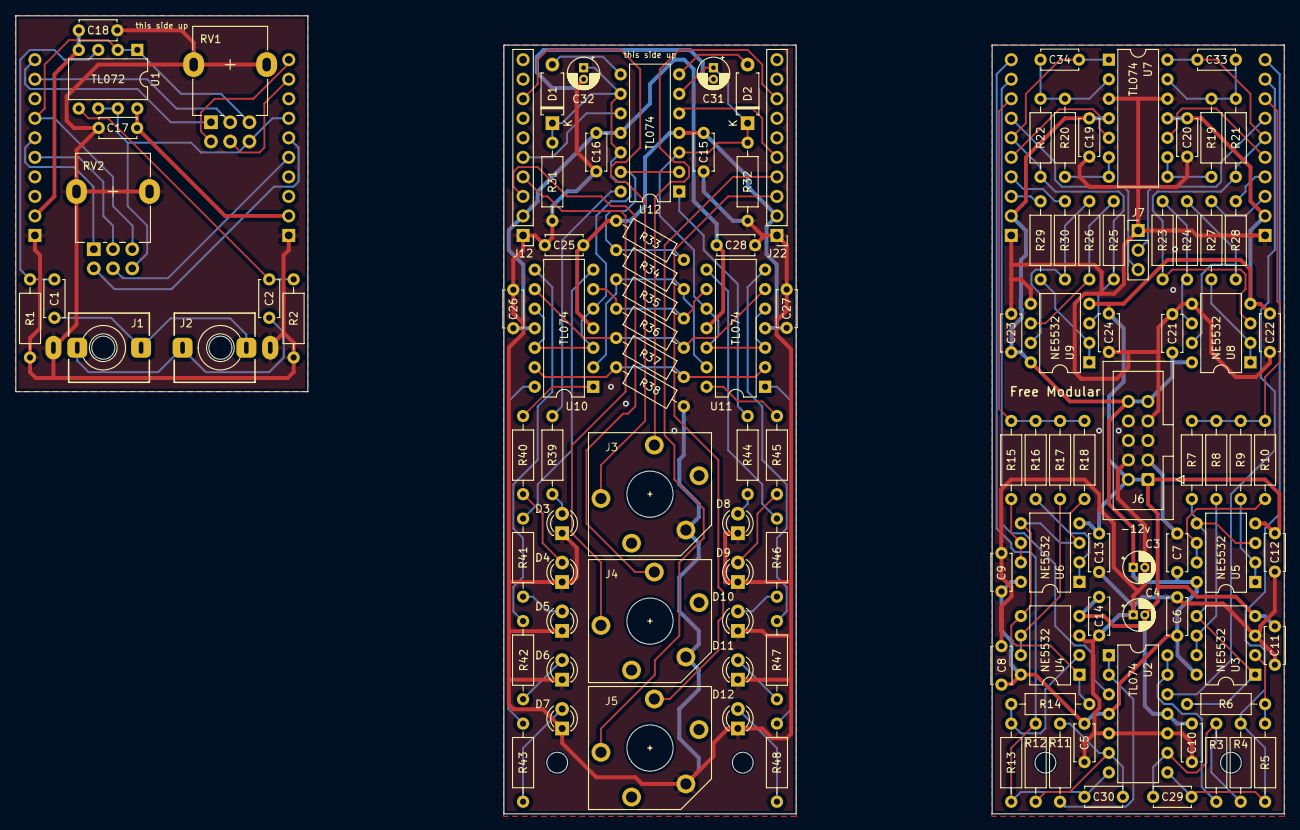
[picture p35: board output_pcb.kicad_pcb from above]

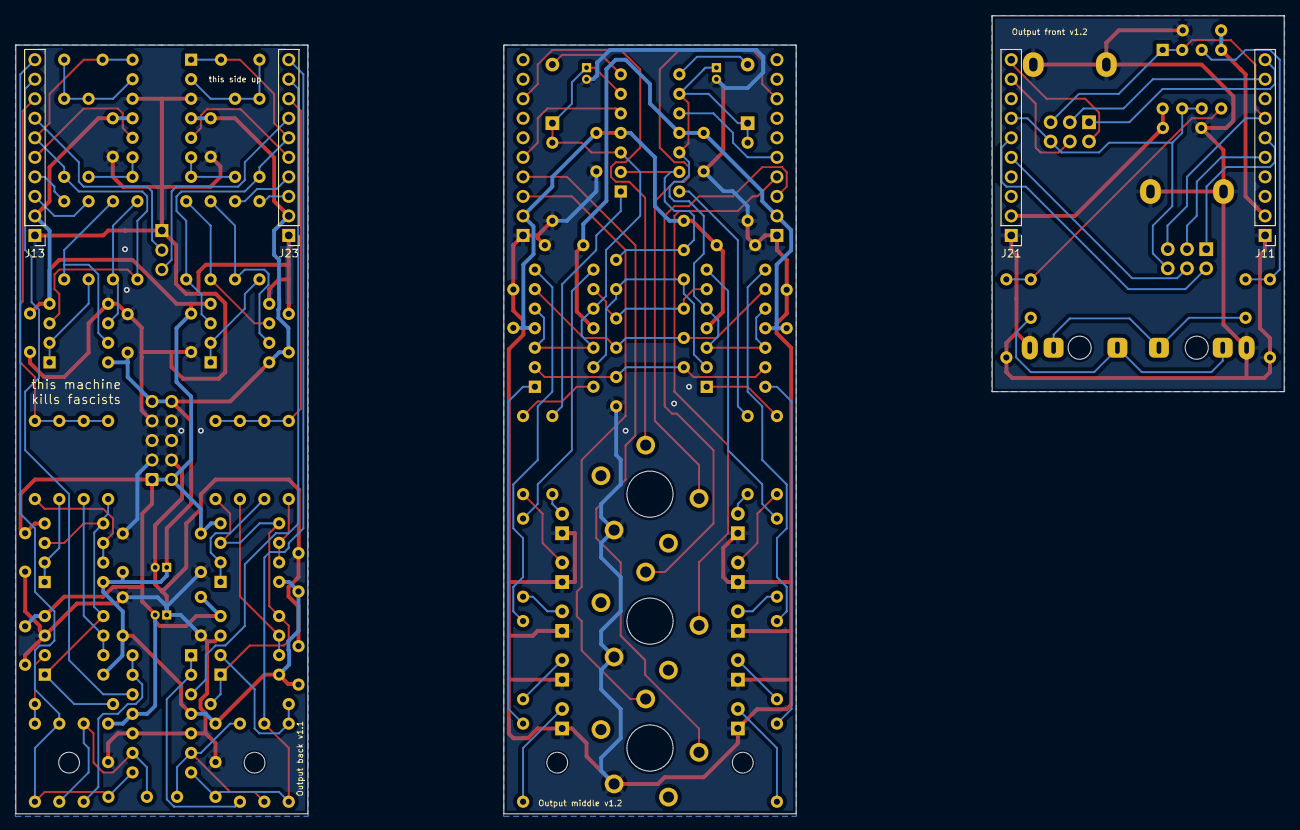
[picture p36: board output_pcb.kicad_pcb from below]

Board: 2 copper layers, 165.0 x 103.8 mm, 128 parts (4 on the bottom side), 100 nets.

Other parts of the board:
B1, B2, B3: Board
