QuinnFreedman/modular/modules/RNG/PCBs/rng_pcb_front/rng_pcb_front.kicad_pcb

## KiCad design modules/RNG/PCBs/rng_pcb_front/rng_pcb_front.kicad_pcb (2025-01-02)

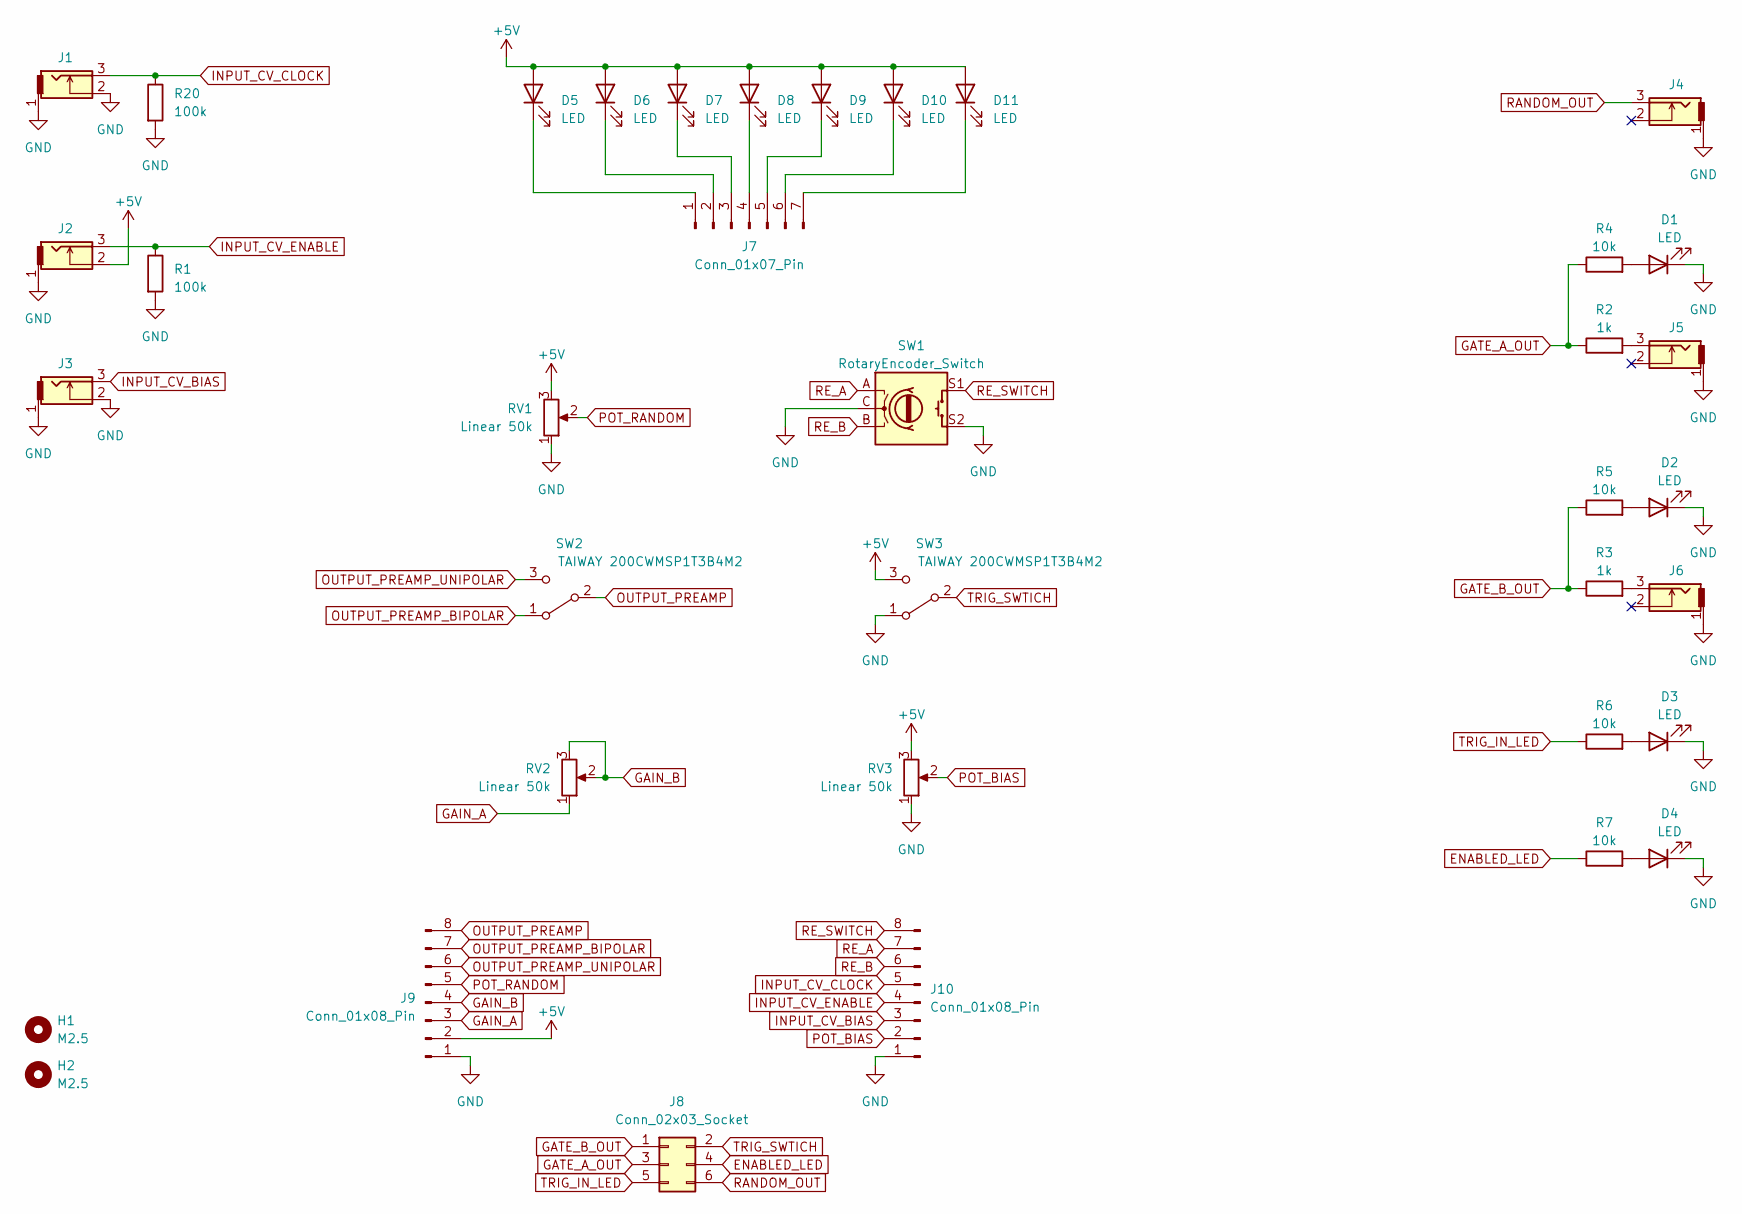
[picture p37: schematic rng_pcb_front.kicad_sch, RNG Front]

Parts:
D1, D2, D3, D4, D5, D6, D7, D8, D9, D10, D11: LED; LED_D3.0mm
H1, H2: M2.5; MountingHole_2.7mm_M2.5
J1, J2, J3, J4, J5, J6: THONKICONN
J7: Conn_01x07_Pin; PinHeader_1x07_P2.54mm_Vertical
J8: Conn_02x03_Socket; PinHeader_2x03_P2.54mm_Vertical
J9, J10: Conn_01x08_Pin; PinHeader_1x08_P2.54mm_Vertical
R1, R20: 100k; R_Axial_DIN0207_L6.3mm_D2.5mm_P7.62mm_Horizontal
R2, R3: 1k; R_Axial_DIN0207_L6.3mm_D2.5mm_P7.62mm_Horizontal
R4, R5, R6, R7: 10k; R_Axial_DIN0207_L6.3mm_D2.5mm_P7.62mm_Horizontal
RV1, RV2, RV3: Linear 50k; Alpha_Potentiometer_Grounded
SW1: RotaryEncoder_Switch; RotaryEncoder_Alps_EC12E-Switch_Vertical_H20mm
SW2, SW3: TAIWAY 200CWMSP1T3B4M2

Connections:
+5V: D5.2 (A), D6.2 (A), D7.2 (A), D8.2 (A), D9.2 (A), D10.2 (A), D11.2 (A), J2.2, J9.2, RV1.3, RV3.3, SW3.3 (C)
ENABLED_LED: J8.4, R7.1
GAIN_A: J9.3, RV2.1
GAIN_B: J9.4, RV2.2, RV2.3
GATE_A_OUT: J8.3, R2.1, R4.1
GATE_B_OUT: J8.1, R3.1, R5.1
GND: D1.1 (K), D2.1 (K), D3.1 (K), D4.1 (K), J1.1, J1.2, J2.1, J3.1, J3.2, J4.1, J5.1, J6.1, J9.1, J10.1, R1.2, R20.2, RV1.1, RV1.MP, RV2.MP, RV3.1, RV3.MP, SW1.C, SW1.MP, SW1.S2, SW3.1 (A)
INPUT_CV_BIAS: J3.3, J10.3
INPUT_CV_CLOCK: J1.3, J10.5, R20.1
INPUT_CV_ENABLE: J2.3, J10.4, R1.1
unnamed: D1.2 (A), R4.2
unnamed: D2.2 (A), R5.2
unnamed: D3.2 (A), R6.2
unnamed: D4.2 (A), R7.2
unnamed: D5.1 (K), J7.1
unnamed: D6.1 (K), J7.2
unnamed: D7.1 (K), J7.3
unnamed: D8.1 (K), J7.4
unnamed: D9.1 (K), J7.5
unnamed: D10.1 (K), J7.6
unnamed: D11.1 (K), J7.7
unnamed: J5.3, R2.2
unnamed: J6.3, R3.2
OUTPUT_PREAMP: J9.8, SW2.2 (B)
OUTPUT_PREAMP_BIPOLAR: J9.7, SW2.1 (A)
OUTPUT_PREAMP_UNIPOLAR: J9.6, SW2.3 (C)
POT_BIAS: J10.2, RV3.2
POT_RANDOM: J9.5, RV1.2
RANDOM_OUT: J4.3, J8.6
RE_A: J10.7, SW1.A
RE_B: J10.6, SW1.B
RE_SWITCH: J10.8, SW1.S1
TRIG_IN_LED: J8.5, R6.1
TRIG_SWTICH: J8.2, SW3.2 (B)

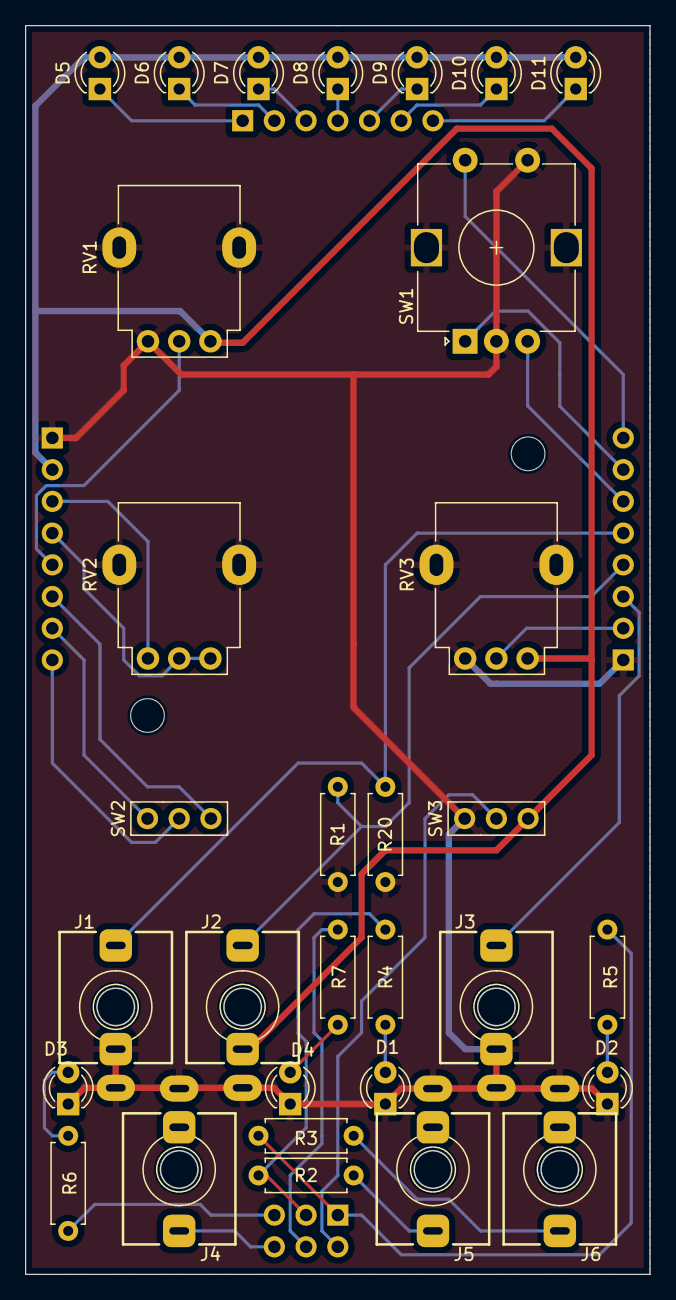
[picture p38: board rng_pcb_front.kicad_pcb from above]

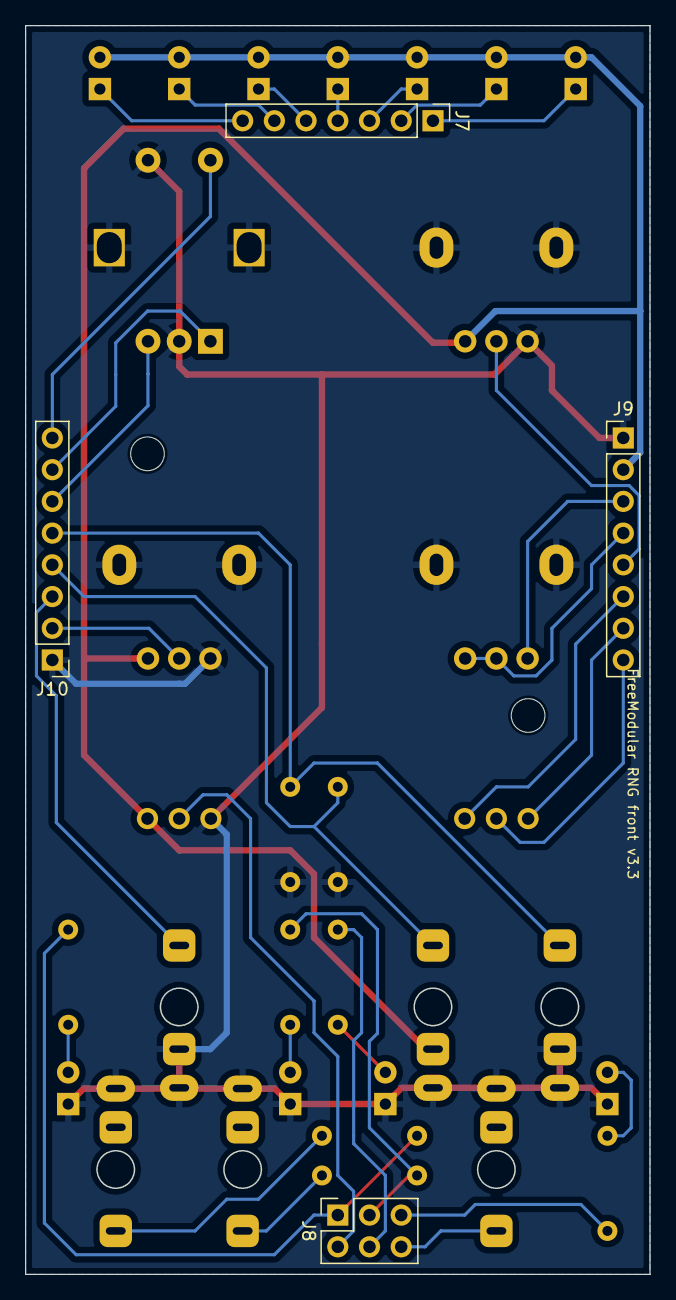
[picture p39: board rng_pcb_front.kicad_pcb from below]

Board: 2 copper layers, 50.0 x 100.0 mm, 37 parts (3 on the bottom side), 34 nets.
