QuinnFreedman/modular/modules/Boost/PCBs/boost_pcb/boost_pcb.kicad_pcb

## KiCad design modules/Boost/PCBs/boost_pcb/boost_pcb.kicad_pcb (2024-10-30)

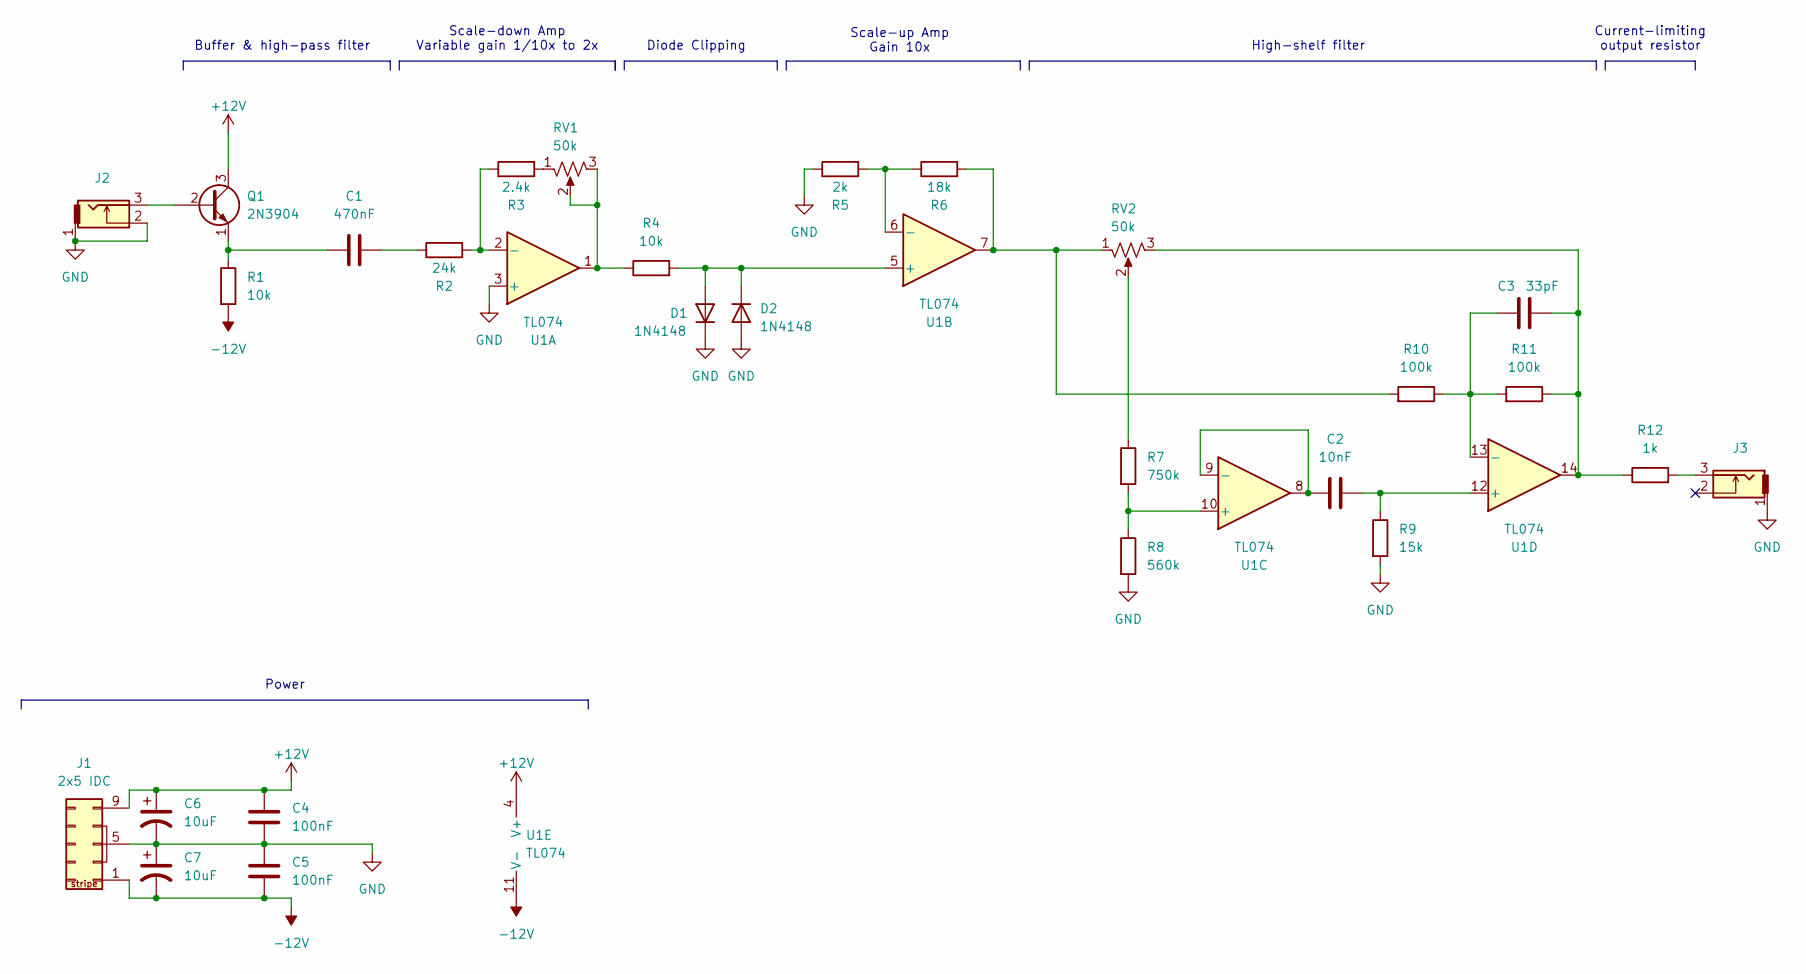
[picture p40: schematic boost_pcb.kicad_sch, Boost]

Parts:
C1: 470nF; C_Disc_D4.7mm_W2.5mm_P5.00mm
C2: 10nF; C_Disc_D4.7mm_W2.5mm_P5.00mm
C3: 33pF; C_Disc_D4.7mm_W2.5mm_P5.00mm
C4, C5: 100nF; C_Disc_D4.7mm_W2.5mm_P5.00mm
C6, C7: 10uF; CP_Radial_D4.0mm_P1.50mm
D1, D2: 1N4148; D_DO-35_SOD27_P7.62mm_Horizontal
J1: 2x5 IDC; IDC-Header_2x05_P2.54mm_Vertical
J2, J3: THONKICONN
Q1: 2N3904; TO-92_Inline_Wide
R1, R4: 10k; R_Axial_DIN0207_L6.3mm_D2.5mm_P7.62mm_Horizontal
R2: 24k; R_Axial_DIN0207_L6.3mm_D2.5mm_P7.62mm_Horizontal
R3: 2.4k; R_Axial_DIN0207_L6.3mm_D2.5mm_P7.62mm_Horizontal
R5: 2k; R_Axial_DIN0207_L6.3mm_D2.5mm_P7.62mm_Horizontal
R6: 18k; R_Axial_DIN0207_L6.3mm_D2.5mm_P7.62mm_Horizontal
R7: 750k; R_Axial_DIN0207_L6.3mm_D2.5mm_P7.62mm_Horizontal
R8: 560k; R_Axial_DIN0207_L6.3mm_D2.5mm_P7.62mm_Horizontal
R9: 15k; R_Axial_DIN0207_L6.3mm_D2.5mm_P7.62mm_Horizontal
R10, R11: 100k; R_Axial_DIN0207_L6.3mm_D2.5mm_P7.62mm_Horizontal
R12: 1k; R_Axial_DIN0207_L6.3mm_D2.5mm_P7.62mm_Horizontal
RV1, RV2: 50k; Alpha_Potentiometer_Grounded
U1: TL074; DIP-14_W7.62mm

Connections:
+12V: C4.1, C6.1, J1.9 (+12v), J1.10 (+12v), Q1.3 (C), U1.4 (V+)
-12V: C5.2, C7.2, J1.1 (-12v), J1.2 (-12v), R1.2, U1.11 (V-)
GND: C4.2, C5.1, C6.2, C7.1, D1.1 (K), D2.2 (A), J1.3 (GND), J1.4 (GND), J1.5 (GND), J1.6 (GND), J1.7 (GND), J1.8 (GND), J2.1, J2.2, J3.1, R5.1, R8.2, R9.2, RV1.MP, RV2.MP, U1.3 (+)
unnamed: C1.2, R2.1
unnamed: C3.2, R11.1, R12.1, RV2.3, U1.14
unnamed: D1.2 (A), D2.1 (K), R4.2, U1.5 (+)
unnamed: J3.3, R12.2
unnamed: J2.3, Q1.2 (B)
unnamed: C1.1, Q1.1 (E), R1.1
unnamed: R3.2, RV1.1
unnamed: R4.1, RV1.2, RV1.3, U1.1
unnamed: R7.1, RV2.2
unnamed: R6.2, R10.2, RV2.1, U1.7
unnamed: R2.2, R3.1, U1.2 (-)
unnamed: R5.2, R6.1, U1.6 (-)
unnamed: R7.2, R8.1, U1.10 (+)
unnamed: C2.1, U1.8, U1.9 (-)
unnamed: C2.2, R9.1, U1.12 (+)
unnamed: C3.1, R10.1, R11.2, U1.13 (-)

Notes on the sheet:
Buffer & high-pass filter
Current-limiting output resistor
Scale-up Amp Gain 10x
Diode Clipping
High-shelf filter
Scale-down Amp Variable gain 1/10x to 2x
Power

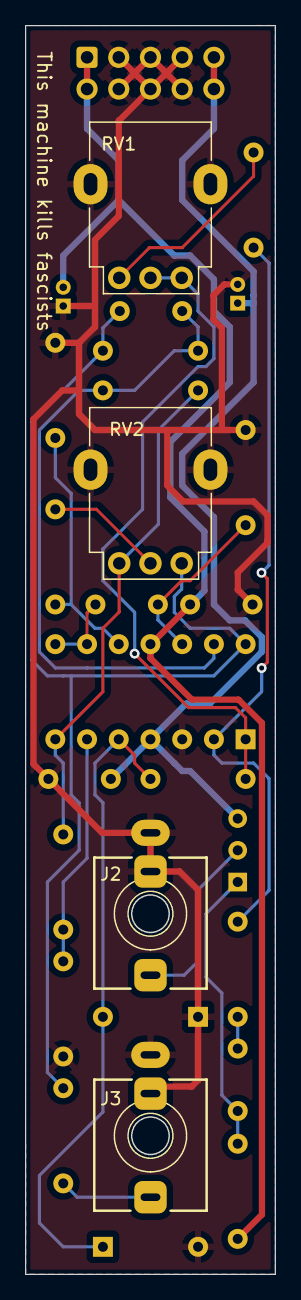
[picture p41: board boost_pcb.kicad_pcb from above]

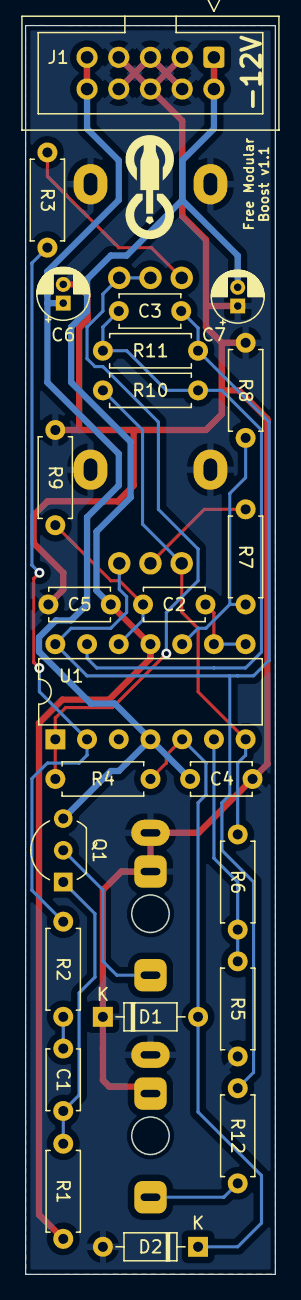
[picture p42: board boost_pcb.kicad_pcb from below]

Board: 2 copper layers, 20.0 x 100.0 mm, 29 parts (25 on the bottom side), 19 nets.

Other parts of the board:
G1: logo_very_small
