QuinnFreedman/modular/modules/RNG/PCBs/rng_pcb_back/rng_pcb_back.kicad_pcb

## KiCad design modules/RNG/PCBs/rng_pcb_back/rng_pcb_back.kicad_pcb (2024-10-24)

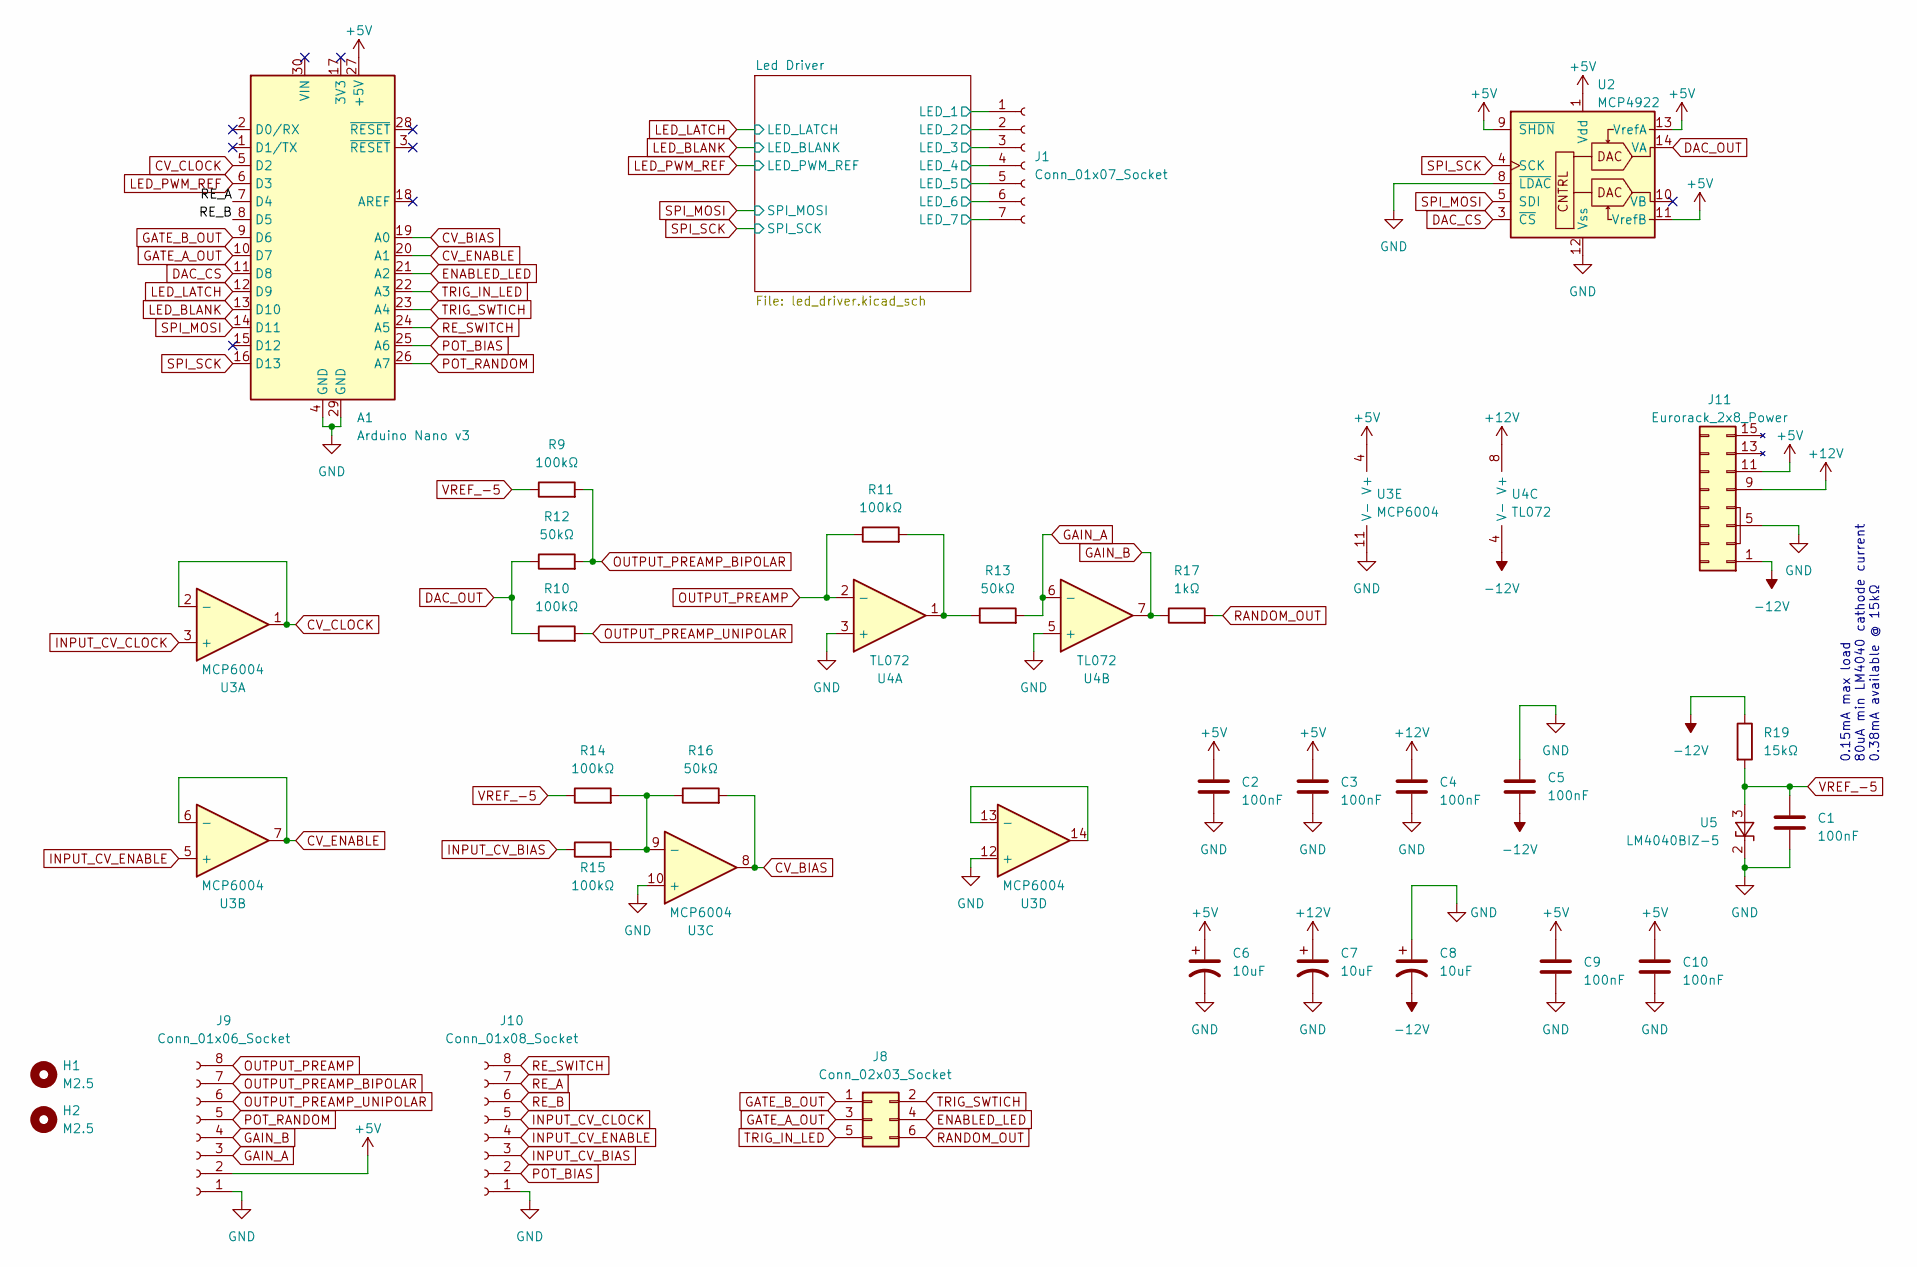
[picture p43: schematic rng_pcb_back.kicad_sch, RNG]

Parts:
A1: Arduino Nano v3; Arduino_Nano
C1, C2, C3, C4, C5, C9, C10: 100nF; C_Disc_D5.0mm_W2.5mm_P5.00mm
C6, C7, C8: 10uF; CP_Radial_D4.0mm_P1.50mm
H1, H2: M2.5; MountingHole_2.7mm_M2.5
J1: Conn_01x07_Socket; PinHeader_1x07_P2.54mm_Vertical
J8: Conn_02x03_Socket; PinHeader_2x03_P2.54mm_Vertical
J9: Conn_01x06_Socket; PinHeader_1x08_P2.54mm_Vertical
J10: Conn_01x08_Socket; PinHeader_1x08_P2.54mm_Vertical
J11: Eurorack_2x8_Power; IDC-Header_2x08_P2.54mm_Vertical
R9, R10, R11, R14, R15: 100kΩ; R_Axial_DIN0207_L6.3mm_D2.5mm_P7.62mm_Horizontal
R12, R13, R16: 50kΩ; R_Axial_DIN0207_L6.3mm_D2.5mm_P7.62mm_Horizontal
R17: 1kΩ; R_Axial_DIN0207_L6.3mm_D2.5mm_P7.62mm_Horizontal
R19: 15kΩ; R_Axial_DIN0207_L6.3mm_D2.5mm_P7.62mm_Horizontal
U2: MCP4922; DIP-14_W7.62mm
U3: MCP6004; DIP-14_W7.62mm
U4: TL072; DIP-8_W7.62mm
U5: LM4040BIZ-5; TO-92_Inline_Wide

Connections:
+5V: A1.27 (+5V), C2.1, C3.1, C6.1, C9.1, C10.1, J9.2, J11.11 (+5v), J11.12 (+5v), U2.1 (Vdd), U2.9 (~SHDN), U2.11 (VrefB), U2.13 (VrefA), U3.4 (V+); also elsewhere on the board
+12V: C4.1, C7.1, J11.9 (+12v), J11.10 (+12v), U4.8 (V+)
-12V: C5.2, C8.2, J11.1 (-12v), J11.2 (-12v), R19.1, U4.4 (V-)
/Led Driver/LED_1: J1.1; also elsewhere on the board
/Led Driver/LED_2: J1.2; also elsewhere on the board
/Led Driver/LED_3: J1.3; also elsewhere on the board
/Led Driver/LED_4: J1.4; also elsewhere on the board
/Led Driver/LED_5: J1.5; also elsewhere on the board
/Led Driver/LED_6: J1.6; also elsewhere on the board
/Led Driver/LED_7: J1.7; also elsewhere on the board
CV_BIAS: A1.19 (A0), R16.2, U3.8
CV_CLOCK: A1.5 (D2), U3.1, U3.2 (-)
CV_ENABLE: A1.20 (A1), U3.6 (-), U3.7
DAC_CS: A1.11 (D8), U2.3 (~CS)
DAC_OUT: R10.1, R12.1, U2.14 (VA)
ENABLED_LED: A1.21 (A2), J8.4
GAIN_A: J9.3, R13.2, U4.6 (-)
GAIN_B: J9.4, R17.1, U4.7
GATE_A_OUT: A1.10 (D7), J8.3
GATE_B_OUT: A1.9 (D6), J8.1
GND: A1.4 (GND), A1.29 (GND), C1.2, C2.2, C3.2, C4.2, C5.1, C6.2, C7.2, C8.1, C9.2, C10.2, J9.1, J10.1, J11.3 (GND), J11.4 (GND), J11.5 (GND), J11.6 (GND), J11.7 (GND), J11.8 (GND), U2.8 (~LDAC), U2.12 (Vss), U3.10 (+), U3.11 (V-), U3.12 (+), U4.3 (+), U4.5 (+), U5.2 (K); also elsewhere on the board
INPUT_CV_BIAS: J10.3, R15.1
INPUT_CV_CLOCK: J10.5, U3.3 (+)
INPUT_CV_ENABLE: J10.4, U3.5 (+)
LED_BLANK: A1.13 (D10); also elsewhere on the board
LED_LATCH: A1.12 (D9); also elsewhere on the board
LED_PWM_REF: A1.6 (D3); also elsewhere on the board
unnamed: R11.2, R13.1, U4.1
unnamed: R14.2, R15.2, R16.1, U3.9 (-)
unnamed: U3.13 (-), U3.14
OUTPUT_PREAMP: J9.8, R11.1, U4.2 (-)
OUTPUT_PREAMP_BIPOLAR: J9.7, R9.2, R12.2
OUTPUT_PREAMP_UNIPOLAR: J9.6, R10.2
POT_BIAS: A1.25 (A6), J10.2
POT_RANDOM: A1.26 (A7), J9.5
RANDOM_OUT: J8.6, R17.2
RE_A: A1.7 (D4), J10.7
RE_B: A1.8 (D5), J10.6
RE_SWITCH: A1.24 (A5), J10.8
SPI_MOSI: A1.14 (D11), U2.5 (SDI); also elsewhere on the board
SPI_SCK: A1.16 (D13), U2.4 (SCK); also elsewhere on the board
TRIG_IN_LED: A1.22 (A3), J8.5
TRIG_SWTICH: A1.23 (A4), J8.2
VREF_-5: C1.1, R9.1, R14.1, R19.2, U5.3 (A)

Notes on the sheet:
0.15mA max load 80uA min LM4040 cathode current 0.38mA available @ 15kΩ

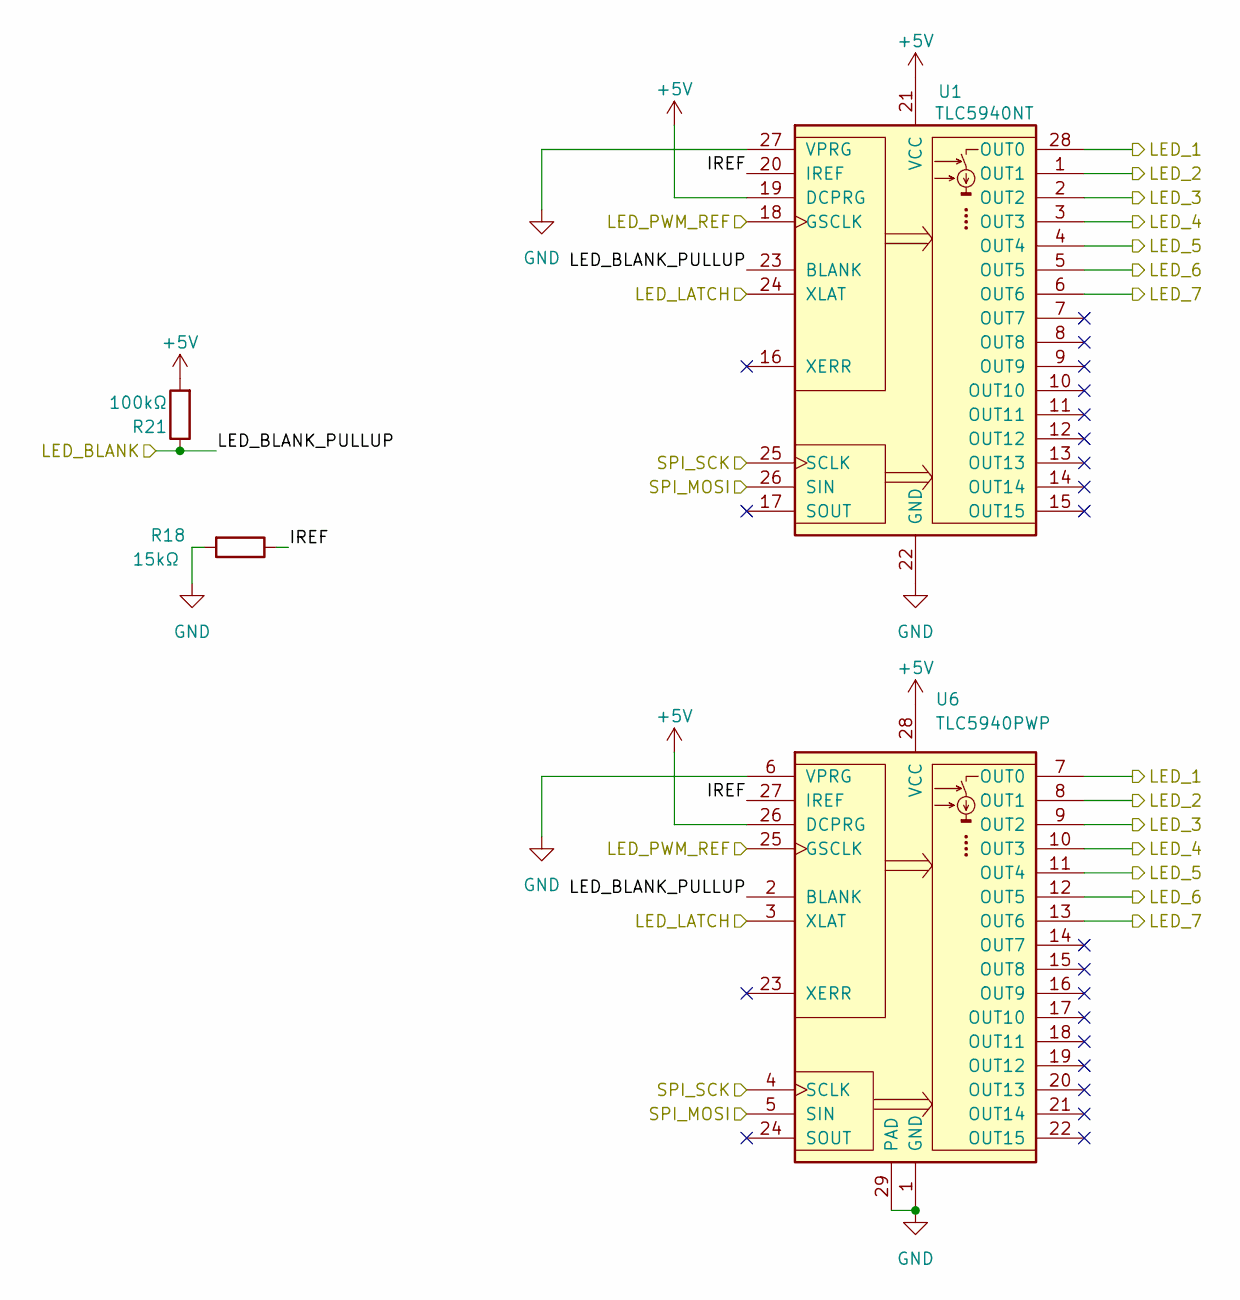
[picture p44: schematic led_driver.kicad_sch, RNG]

Parts:
R18: 15kΩ; R_Axial_DIN0207_L6.3mm_D2.5mm_P7.62mm_Horizontal
R21: 100kΩ; R_Axial_DIN0207_L6.3mm_D2.5mm_P7.62mm_Horizontal
U1: TLC5940NT; DIP-28_W7.62mm
U6: TLC5940PWP; HTSSOP-28-1EP_4.4x9.7mm_P0.65mm_EP3.4x9.5mm_Mask2.4x6.17mm_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

Connections:
+5V: R21.2, U1.19 (DCPRG), U1.21 (VCC), U6.26 (DCPRG), U6.28 (VCC); also elsewhere on the board
/Led Driver/IREF: R18.1, U1.20 (IREF), U6.27 (IREF)
/Led Driver/LED_1: U1.28 (OUT0), U6.7 (OUT0); also elsewhere on the board
/Led Driver/LED_2: U1.1 (OUT1), U6.8 (OUT1); also elsewhere on the board
/Led Driver/LED_3: U1.2 (OUT2), U6.9 (OUT2); also elsewhere on the board
/Led Driver/LED_4: U1.3 (OUT3), U6.10 (OUT3); also elsewhere on the board
/Led Driver/LED_5: U1.4 (OUT4), U6.11 (OUT4); also elsewhere on the board
/Led Driver/LED_6: U1.5 (OUT5), U6.12 (OUT5); also elsewhere on the board
/Led Driver/LED_7: U1.6 (OUT6), U6.13 (OUT6); also elsewhere on the board
GND: R18.2, U1.22 (GND), U1.27 (VPRG), U6.1 (GND), U6.6 (VPRG), U6.29 (PAD); also elsewhere on the board
LED_BLANK: R21.1, U1.23 (BLANK), U6.2 (BLANK); also elsewhere on the board
LED_LATCH: U1.24 (XLAT), U6.3 (XLAT); also elsewhere on the board
LED_PWM_REF: U1.18 (GSCLK), U6.25 (GSCLK); also elsewhere on the board
SPI_MOSI: U1.26 (SIN), U6.5 (SIN); also elsewhere on the board
SPI_SCK: U1.25 (SCLK), U6.4 (SCLK); also elsewhere on the board

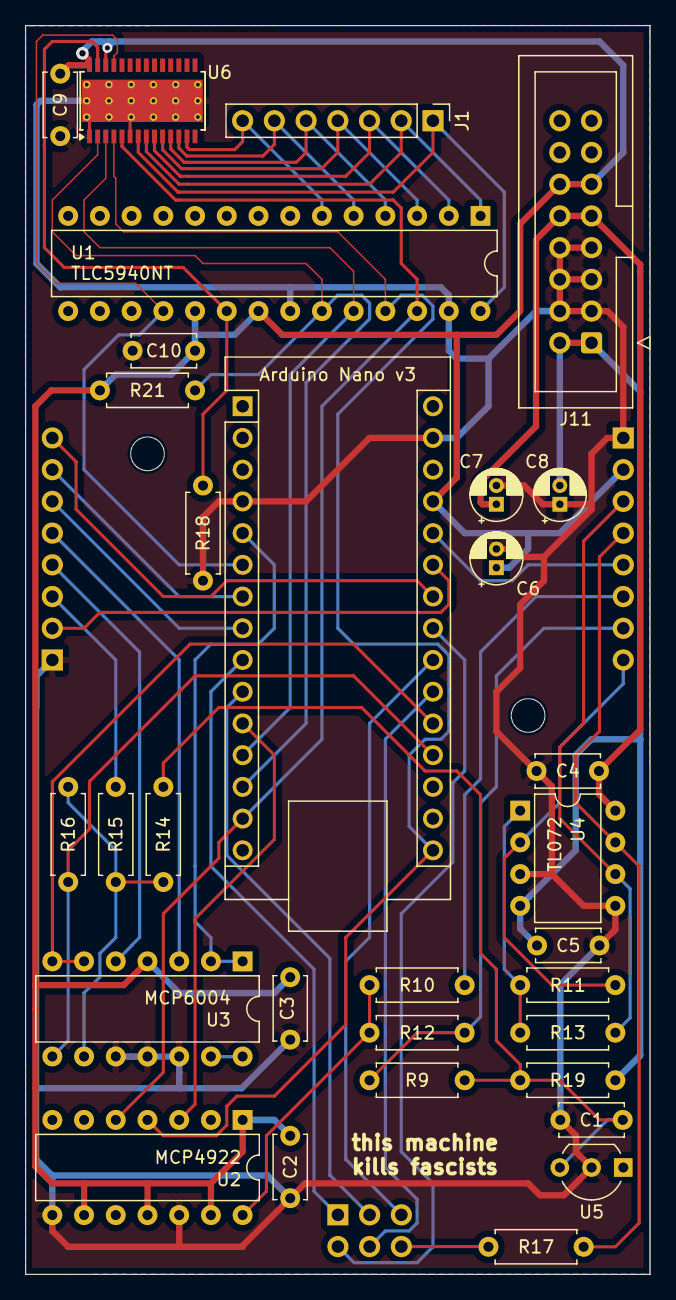
[picture p45: board modules/RNG/PCBs/rng_pcb_back/rng_pcb_back.kicad_pcb from above]

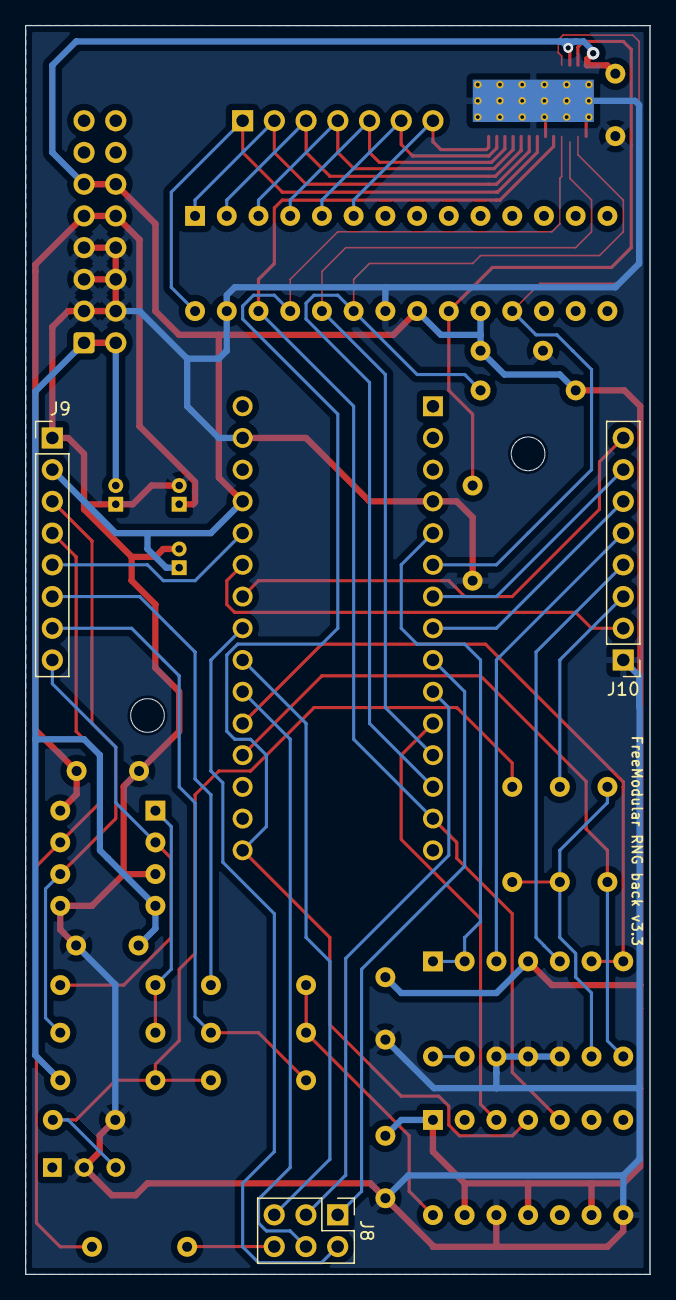
[picture p46: board modules/RNG/PCBs/rng_pcb_back/rng_pcb_back.kicad_pcb from below]

Board: 2 copper layers, 50.0 x 100.0 mm, 36 parts (3 on the bottom side), 45 nets.
