QuinnFreedman/modular/modules/devboard/PCBs/devboard_pcb/devboard_pcb.kicad_pcb

## KiCad design modules/devboard/PCBs/devboard_pcb/devboard_pcb.kicad_pcb (2024-05-05)

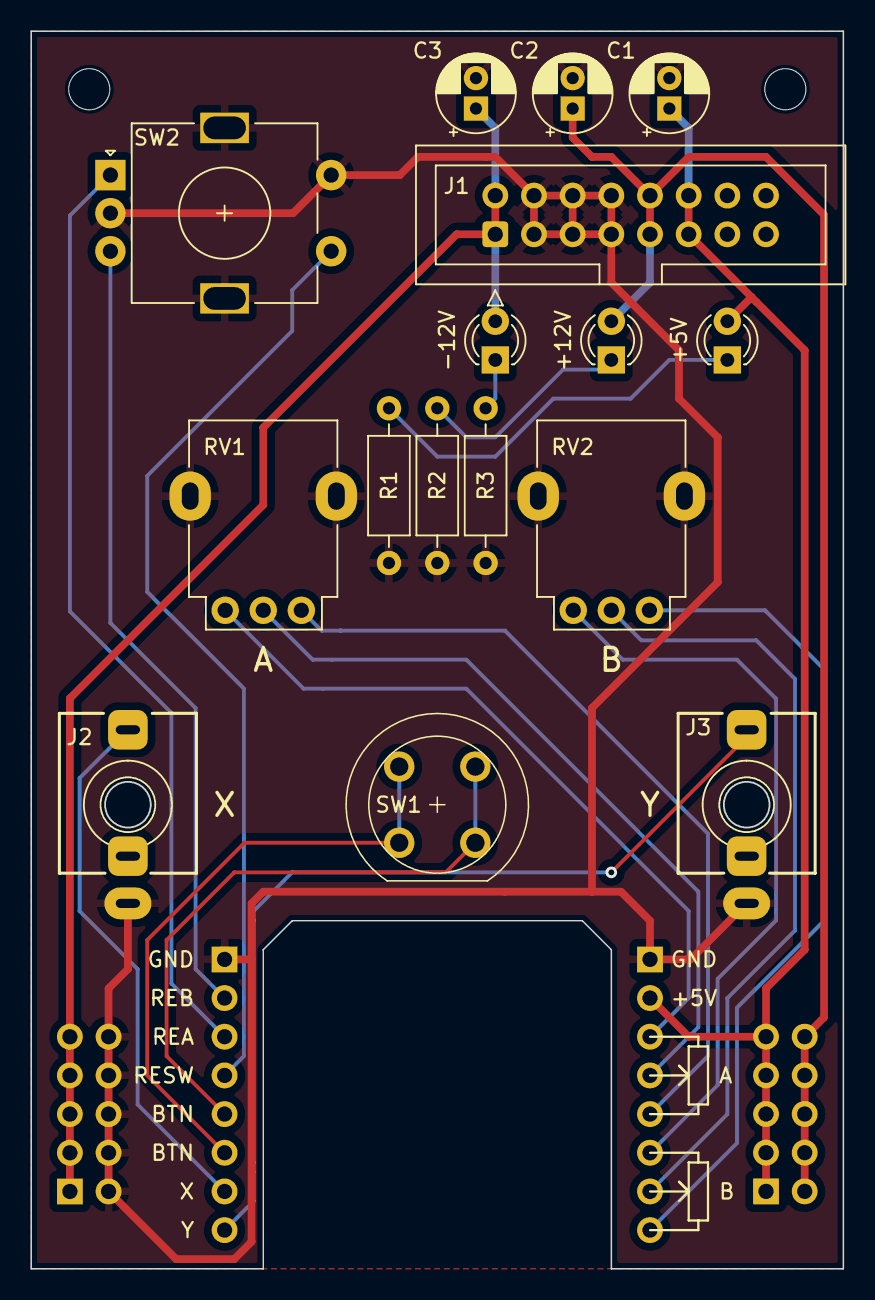
[picture p57: board devboard_pcb.kicad_pcb from above]

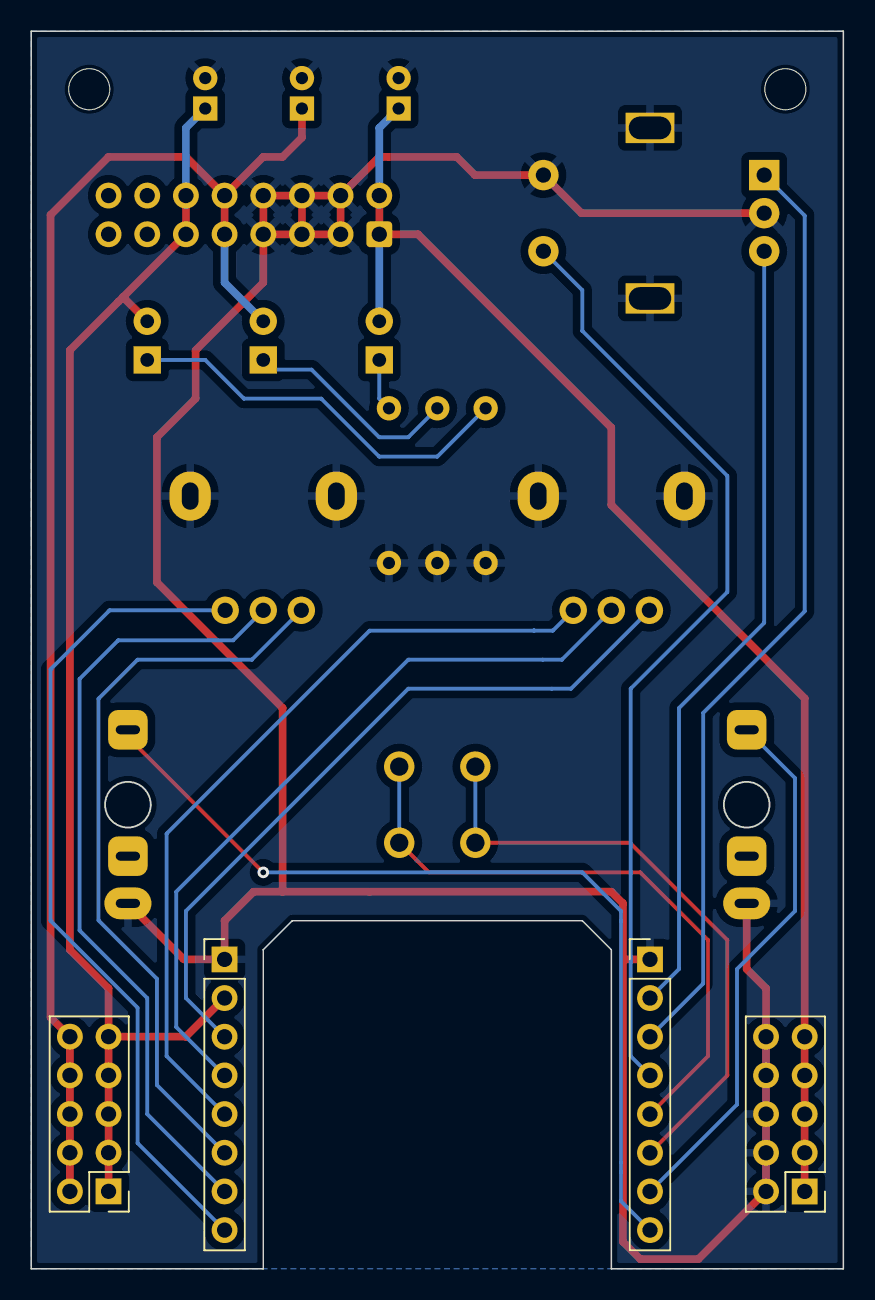
[picture p58: board devboard_pcb.kicad_pcb from below]

Board: 2 copper layers, 53.3 x 81.3 mm, 22 parts (4 on the bottom side), 20 nets.

Parts:
C1, C2, C3: 10uF; CP_Radial_D5.0mm_P2.00mm
D1, D2, D3: LED; LED_D3.0mm
H1, H2: MountingHole; MountingHole_2.7mm_M2.5
J1: Eurorack_2x8_Power; IDC-Header_2x08_P2.54mm_Vertical
J2, J3: THONKICONN
J4, J5: Conn_01x08_Pin; PinHeader_1x08_P2.54mm_Vertical
J6, J7: Conn_02x05_Top_Bottom; PinHeader_2x05_P2.54mm_Vertical
R1, R2, R3: R; R_Axial_DIN0207_L6.3mm_D2.5mm_P10.16mm_Horizontal
RV1, RV2: R_Potentiometer; Alpha_Potentiometer_Grounded
SW1: SW_SPST; D6R
SW2: RotaryEncoder_Switch; RotaryEncoder_Alps_EC11E-Switch_Vertical_H20mm

Connections:
+5V: C1.1, D1.2 (A), J1.11 (+5v), J1.12 (+5v), J4.2, J7.1, J7.3, J7.5, J7.7, J7.9
+12V: C2.1, D2.2 (A), J1.9 (+12v), J1.10 (+12v), J7.2, J7.4, J7.6, J7.8, J7.10
-12V: C3.1, D3.2 (A), J1.1 (-12v), J1.2 (-12v), J6.1, J6.3, J6.5, J6.7, J6.9
GND: C1.2, C2.2, C3.2, J1.3 (GND), J1.4 (GND), J1.5 (GND), J1.6 (GND), J1.7 (GND), J1.8 (GND), J2.1, J3.1, J4.1, J5.1, J6.2, J6.4, J6.6, J6.8, J6.10, R1.2, R2.2, R3.2, RV1.MP, RV2.MP, SW2.C, SW2.MP, SW2.S2
unnamed: D1.1 (K), R1.1
unnamed: D2.1 (K), R2.1
unnamed: D3.1 (K), R3.1
unnamed: J4.3, RV1.1
unnamed: J4.4, RV1.2
unnamed: J4.5, RV1.3
unnamed: J4.6, RV2.1
unnamed: J4.7, RV2.2
unnamed: J4.8, RV2.3
unnamed: J5.2, SW2.B
unnamed: J5.3, SW2.A
unnamed: J5.4, SW2.S1
unnamed: J5.5, SW1.2 (B)
unnamed: J5.6, SW1.1 (A)
unnamed: J2.3, J5.7
unnamed: J3.3, J5.8
