QuinnFreedman/modular/modules/Mixer/PCBs/mixer_pcb/mixer_pcb.kicad_pcb

## KiCad design modules/Mixer/PCBs/mixer_pcb/mixer_pcb.kicad_pcb (2023-12-20)

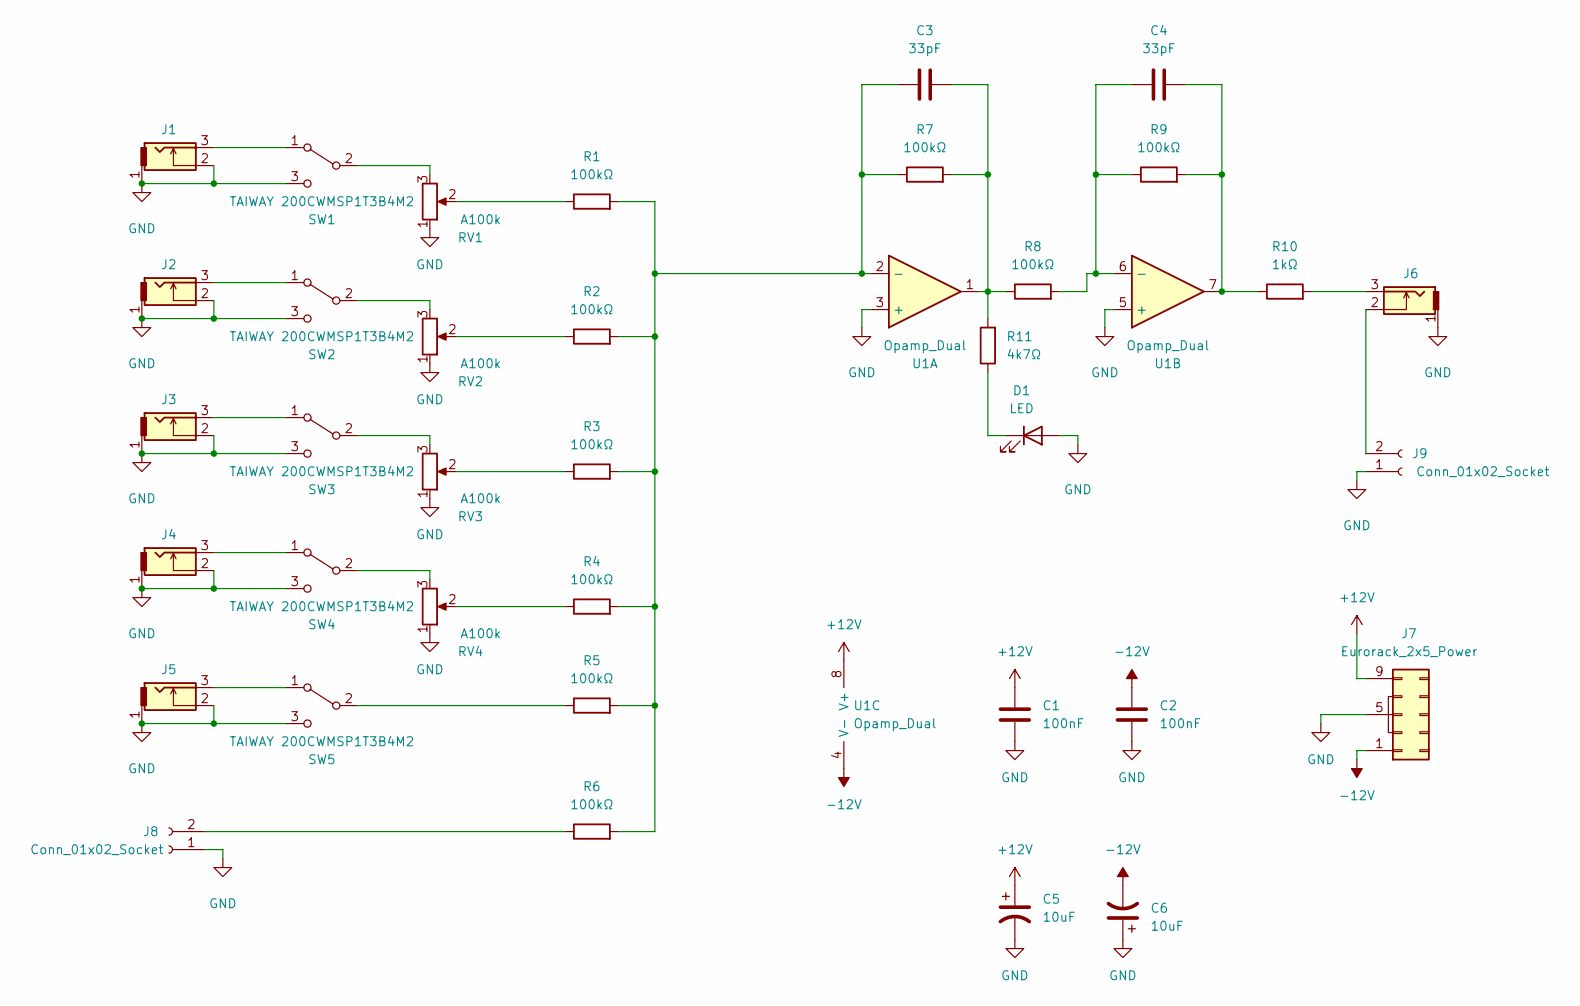
[picture p62: schematic mixer_pcb.kicad_sch, Mixer]

Parts:
C1, C2: 100nF; C_Disc_D4.7mm_W2.5mm_P5.00mm
C3, C4: 33pF; C_Disc_D4.7mm_W2.5mm_P5.00mm
C5, C6: 10uF; CP_Radial_D4.0mm_P2.00mm
D1: LED; LED_D3.0mm
J1, J2, J3, J4, J5, J6: THONKICONN
J7: Eurorack_2x5_Power; IDC-Header_2x05_P2.54mm_Vertical
J8, J9: Conn_01x02_Socket; PinHeader_1x02_P2.54mm_Vertical
R1, R2, R3, R4, R5, R6, R7, R8, R9: 100kΩ; R_Axial_DIN0207_L6.3mm_D2.5mm_P10.16mm_Horizontal
R10: 1kΩ; R_Axial_DIN0207_L6.3mm_D2.5mm_P10.16mm_Horizontal
R11: 4k7Ω; R_Axial_DIN0207_L6.3mm_D2.5mm_P10.16mm_Horizontal
RV1, RV2, RV3, RV4: A100k; Alpha_Potentiometer_Grounded
SW1, SW2, SW3, SW4, SW5: TAIWAY 200CWMSP1T3B4M2
U1: Opamp_Dual; DIP-8_W7.62mm

Connections:
+12V: C1.1, C5.1, J7.9 (+12v), J7.10 (+12v), U1.8 (V+)
-12V: C2.1, C6.2, J7.1 (-12v), J7.2 (-12v), U1.4 (V-)
GND: C1.2, C2.2, C5.2, C6.1, D1.2 (A), J1.1, J1.2, J2.1, J2.2, J3.1, J3.2, J4.1, J4.2, J5.1, J5.2, J6.1, J7.3 (GND), J7.4 (GND), J7.5 (GND), J7.6 (GND), J7.7 (GND), J7.8 (GND), J8.1, J9.1, RV1.1, RV1.MP, RV2.1, RV2.MP, RV3.1, RV3.MP, RV4.1, RV4.MP, SW1.3 (C), SW2.3 (C), SW3.3 (C), SW4.3 (C), SW5.3 (C), U1.3 (+), U1.5 (+)
unnamed: C3.2, R7.2, R8.1, R11.2, U1.1
unnamed: C4.2, R9.2, R10.1, U1.7
unnamed: D1.1 (K), R11.1
unnamed: J6.3, R10.2
unnamed: J8.2, R6.1
unnamed: J6.2, J9.2
unnamed: R1.1, RV1.2
unnamed: R2.1, RV2.2
unnamed: R3.1, RV3.2
unnamed: R4.1, RV4.2
unnamed: J1.3, SW1.1 (A)
unnamed: RV1.3, SW1.2 (B)
unnamed: J2.3, SW2.1 (A)
unnamed: RV2.3, SW2.2 (B)
unnamed: J3.3, SW3.1 (A)
unnamed: RV3.3, SW3.2 (B)
unnamed: J4.3, SW4.1 (A)
unnamed: RV4.3, SW4.2 (B)
unnamed: J5.3, SW5.1 (A)
unnamed: R5.1, SW5.2 (B)
unnamed: C3.1, R1.2, R2.2, R3.2, R4.2, R5.2, R6.2, R7.1, U1.2 (-)
unnamed: C4.1, R8.2, R9.1, U1.6 (-)

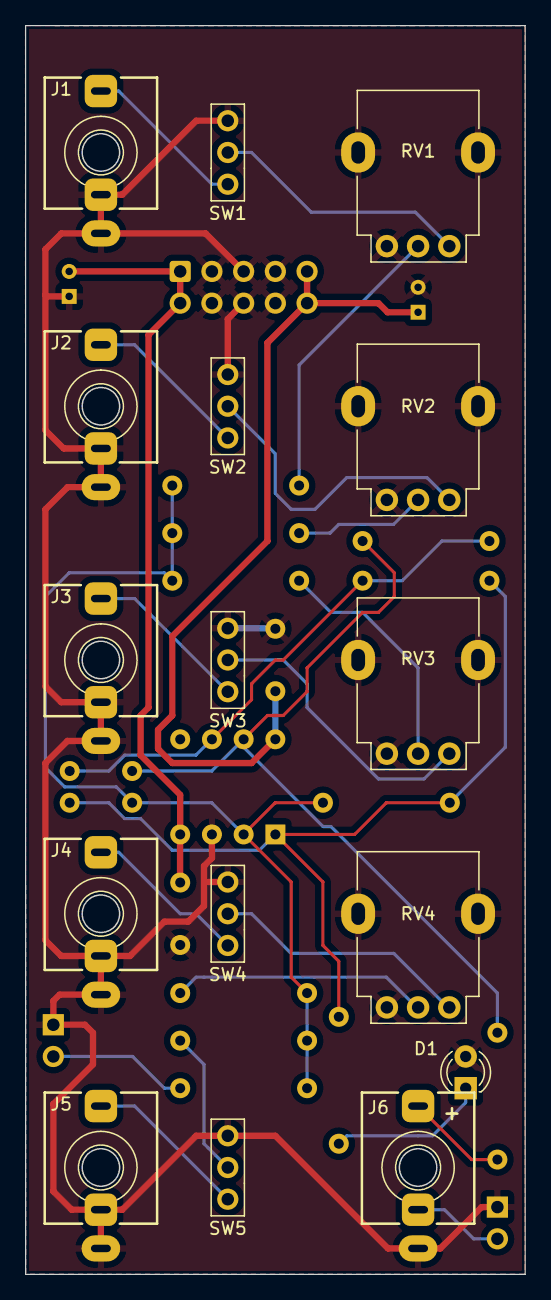
[picture p63: board mixer_pcb.kicad_pcb from above]

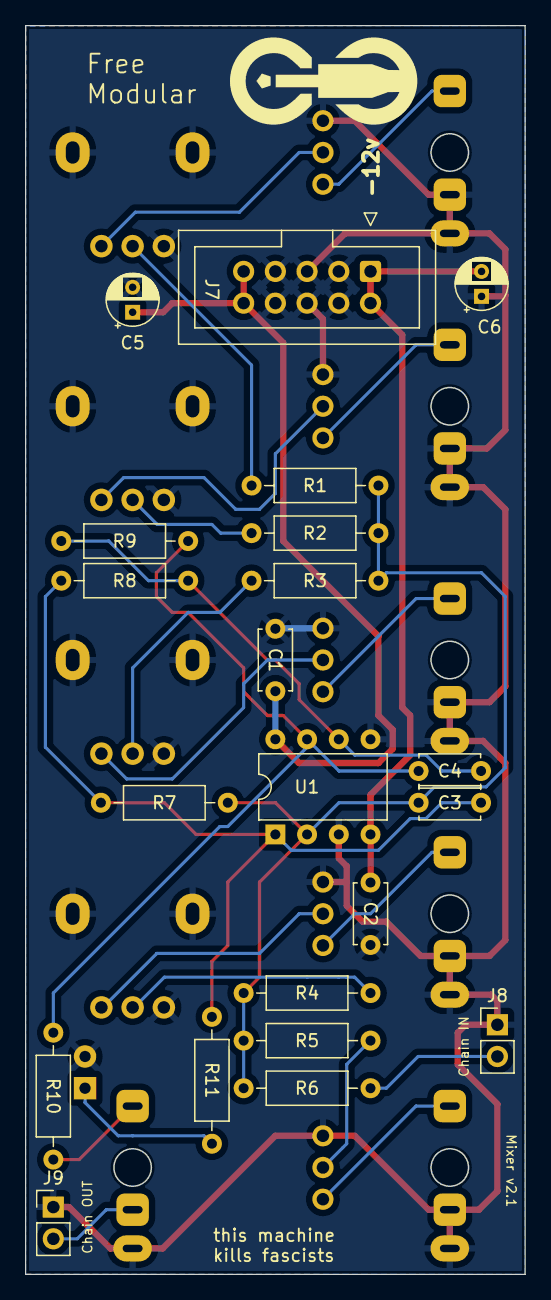
[picture p64: board mixer_pcb.kicad_pcb from below]

Board: 2 copper layers, 40.0 x 100.0 mm, 37 parts (21 on the bottom side), 25 nets.
