QuinnFreedman/modular/modules/Clock/PCBs/clock_back_pcb/clock_back_pcb.kicad_pcb

## KiCad design modules/Clock/PCBs/clock_back_pcb/clock_back_pcb.kicad_pcb (2023-12-01)

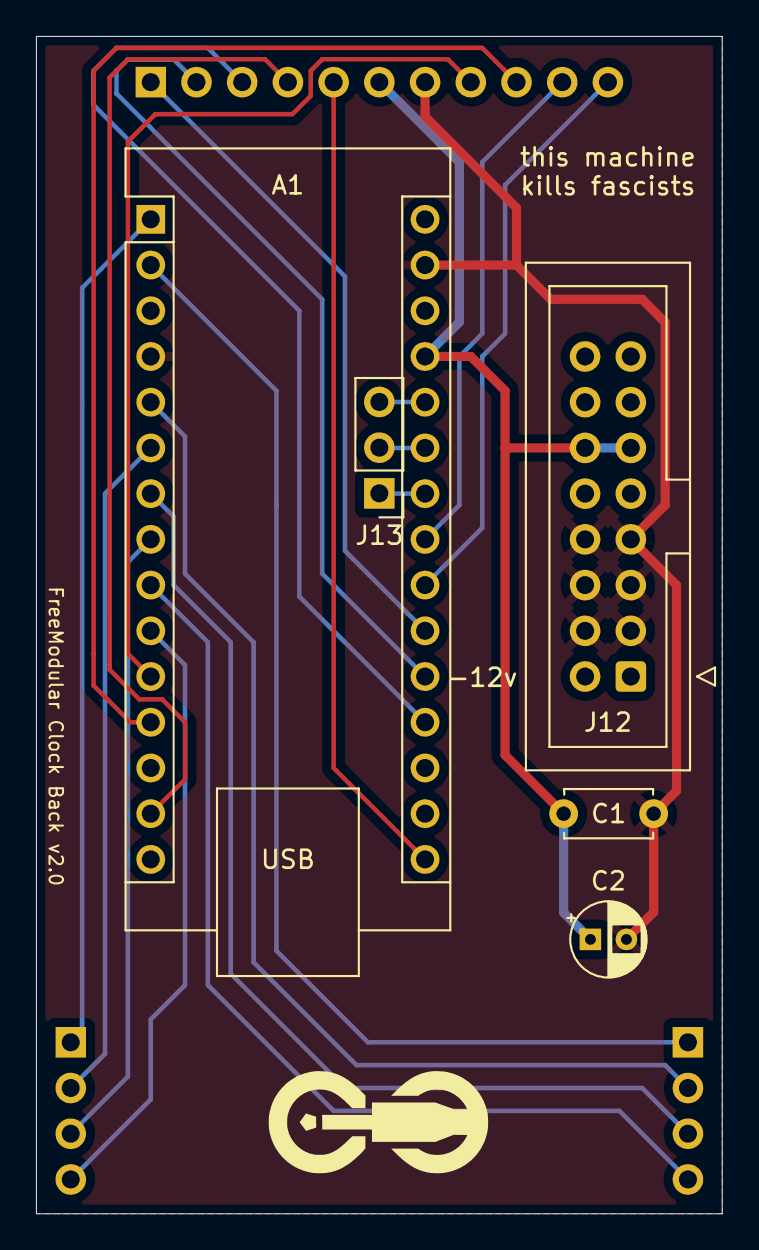
[picture p65: board clock_back_pcb.kicad_pcb from above]

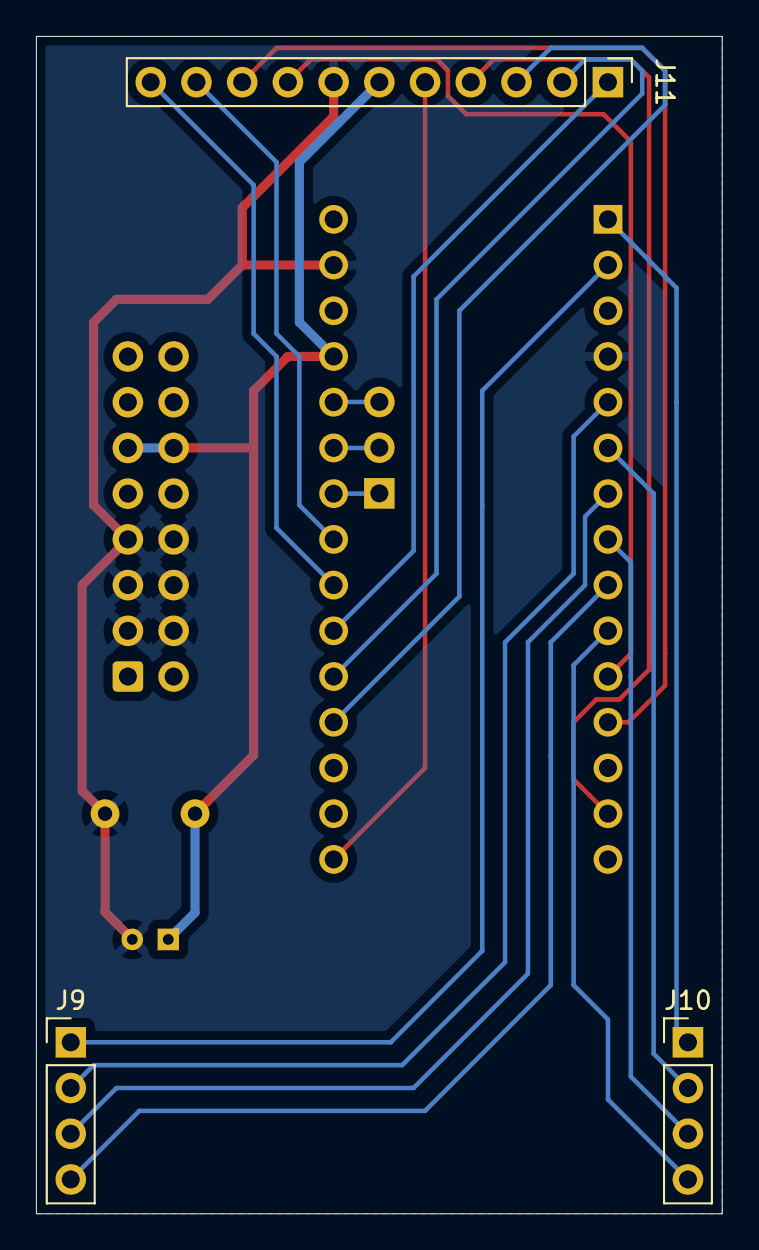
[picture p66: board clock_back_pcb.kicad_pcb from below]

Board: 2 copper layers, 38.1 x 65.4 mm, 9 parts (3 on the bottom side), 22 nets.

Parts:
A1: Arduino_Nano_v3.x; Arduino_Nano
C1: 100nF; C_Disc_D4.7mm_W2.5mm_P5.00mm
C2: 10uF; CP_Radial_D4.0mm_P2.00mm
G1: logo_small
J9, J10: Conn_01x04_Pin; PinHeader_1x04_P2.54mm_Vertical
J11: Conn_01x11_Pin; PinHeader_1x11_P2.54mm_Vertical
J12: Eurorack_2x8_Power; IDC-Header_2x08_P2.54mm_Vertical
J13: Conn_01x03_Socket; PinHeader_1x03_P2.54mm_Vertical

Connections:
+5V: A1.27 (+5V), C1.1, C2.1, J11.6, J12.11 (+5v), J12.12 (+5v)
ENCODER_A: A1.11 (D8), J11.8
ENCODER_B: A1.12 (D9), J11.9
ENCODER_SWITCH: A1.23 (A4), J11.10
GND: A1.4 (GND), A1.29 (GND), C1.2, C2.2, J11.7, J12.3 (GND), J12.4 (GND), J12.5 (GND), J12.6 (GND), J12.7 (GND), J12.8 (GND)
unnamed: A1.24 (A5), J13.1
unnamed: A1.25 (A6), J13.2
unnamed: A1.26 (A7), J13.3
OUT_1: A1.2 (D0/RX), J9.1
OUT_2: A1.1 (D1/TX), J10.1
OUT_3: A1.5 (D2), J9.2
OUT_4: A1.6 (D3), J10.2
OUT_5: A1.7 (D4), J9.3
OUT_6: A1.8 (D5), J10.3
OUT_7: A1.9 (D6), J9.4
OUT_8: A1.10 (D7), J10.4
PAUSE_BTN: A1.22 (A3), J11.11
RESET: A1.19 (A0), J11.3
SPI_CS: A1.21 (A2), J11.1
SPI_DC: A1.20 (A1), J11.2
SPI_SCK: A1.16 (D13), J11.5
SPI_SDA: A1.14 (D11), J11.4
