QuinnFreedman/modular/RNG/Hardware/PCB/rng_pcb_back/rng_pcb_back.kicad_pcb

## KiCad design RNG/Hardware/PCB/rng_pcb_back/rng_pcb_back.kicad_pcb (2023-04-25, an earlier design)

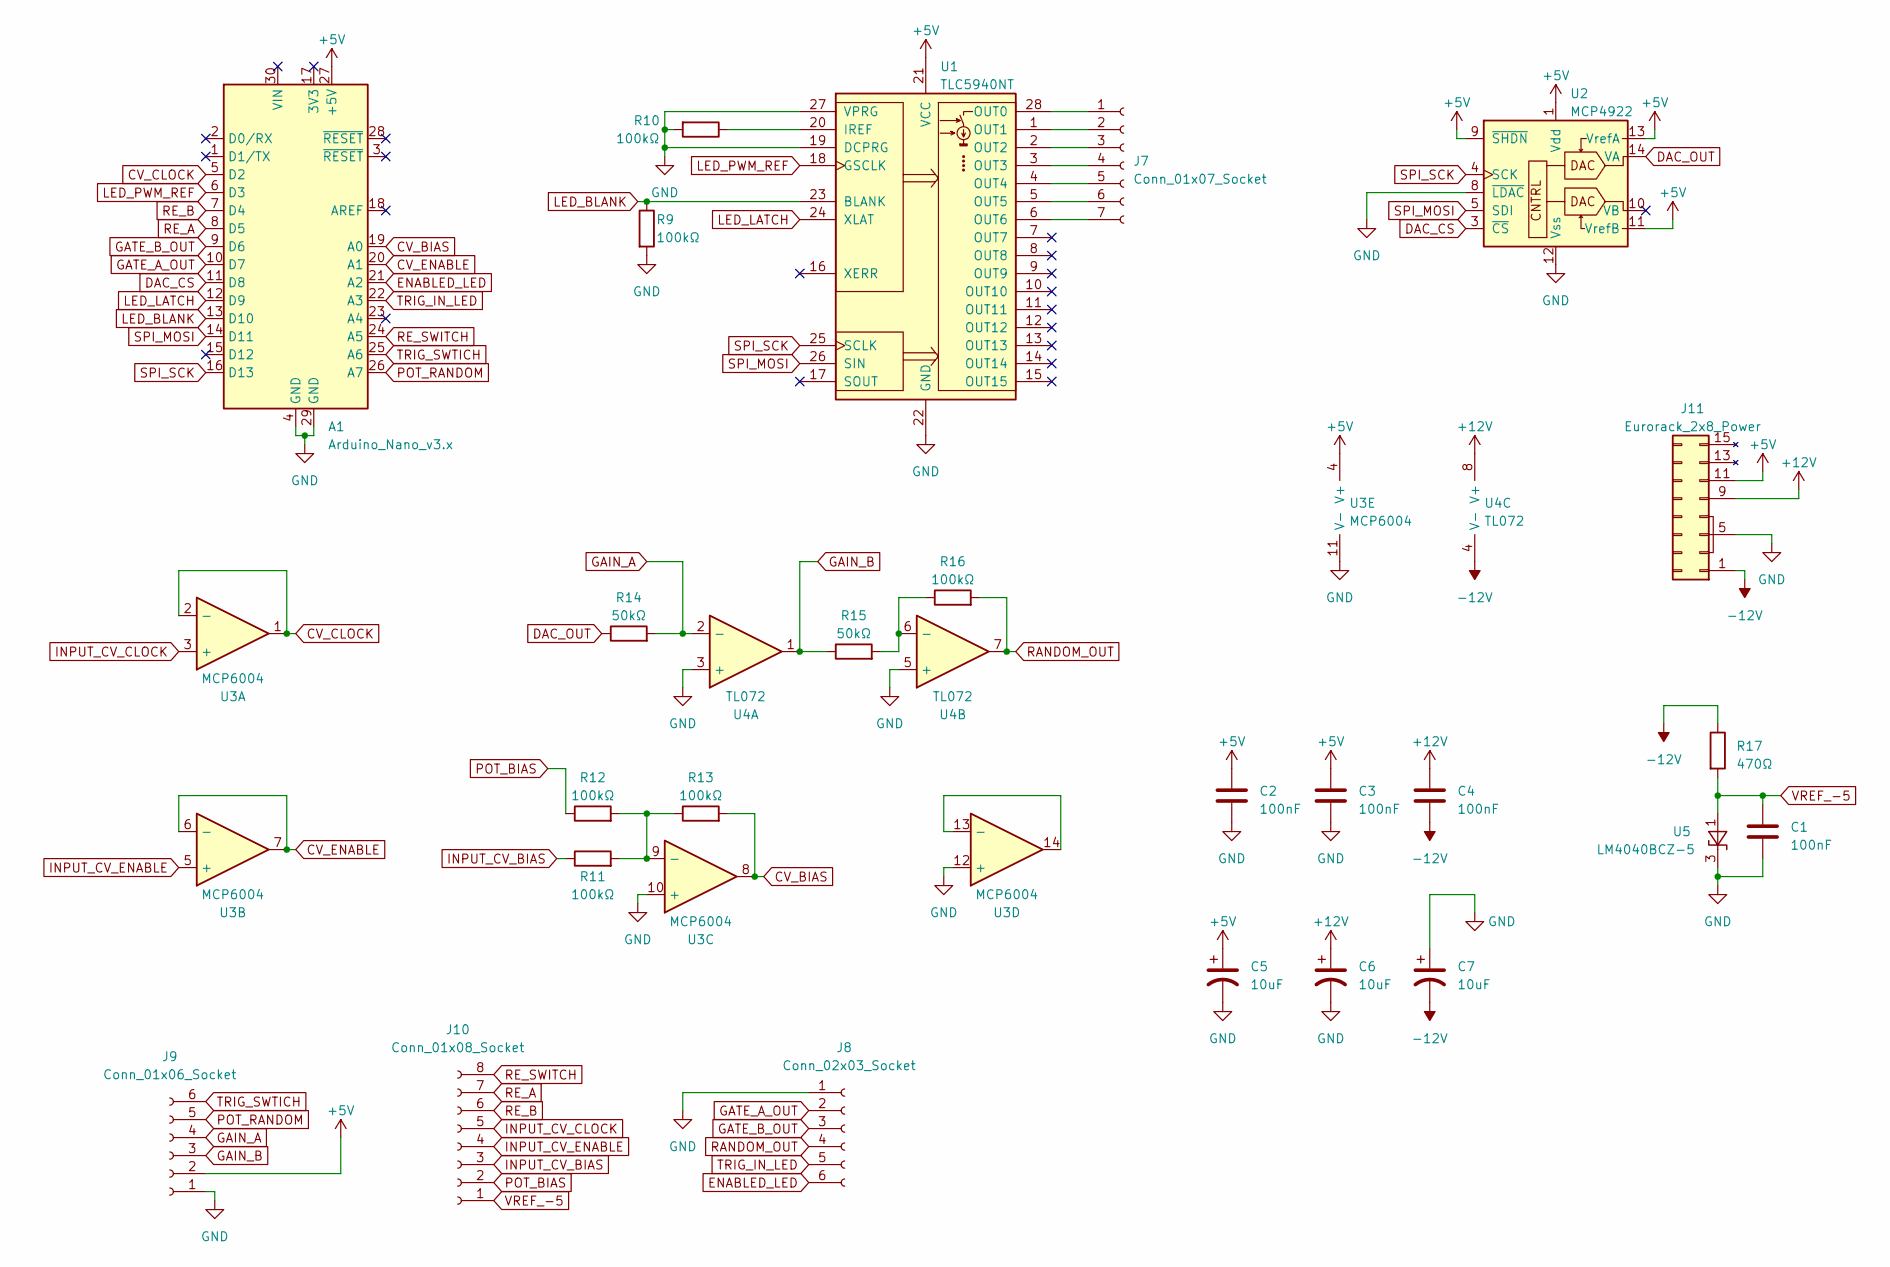
[picture p67: schematic rng_pcb_back.kicad_sch, RNG]

Parts:
A1: Arduino_Nano_v3.x; Arduino_Nano
C1, C2, C3, C4: 100nF; C_Disc_D5.0mm_W2.5mm_P5.00mm
C5, C6, C7: 10uF; CP_Radial_D4.0mm_P1.50mm
J7: Conn_01x07_Socket; PinHeader_1x07_P2.54mm_Vertical
J8: Conn_02x03_Socket; PinHeader_2x03_P2.54mm_Vertical
J9: Conn_01x06_Socket; PinHeader_1x06_P2.54mm_Vertical
J10: Conn_01x08_Socket; PinHeader_1x08_P2.54mm_Vertical
J11: Eurorack_2x8_Power; IDC-Header_2x08_P2.54mm_Vertical
R9, R10, R11, R12, R13, R16: 100kΩ; R_Axial_DIN0207_L6.3mm_D2.5mm_P7.62mm_Horizontal
R14, R15: 50kΩ; R_Axial_DIN0207_L6.3mm_D2.5mm_P7.62mm_Horizontal
R17: 470Ω; R_Axial_DIN0207_L6.3mm_D2.5mm_P7.62mm_Horizontal
U1: TLC5940NT; DIP-28_W7.62mm
U2: MCP4922; DIP-14_W7.62mm
U3: MCP6004; DIP-14_W7.62mm
U4: TL072; DIP-8_W7.62mm
U5: LM4040BCZ-5; TO-92L_Inline_Wide

Connections:
+5V: A1.27 (+5V), C2.1, C3.1, C5.1, J9.2, J11.11 (+5v), J11.12 (+5v), U1.21 (VCC), U2.1 (Vdd), U2.9 (~SHDN), U2.11 (VrefB), U2.13 (VrefA), U3.4 (V+)
+12V: C4.1, C6.1, J11.9 (+12v), J11.10 (+12v), U4.8 (V+)
-12V: C4.2, C7.2, J11.1 (-12v), J11.2 (-12v), R17.1, U4.4 (V-)
CV_BIAS: A1.19 (A0), R13.2, U3.8
CV_CLOCK: A1.5 (D2), U3.1, U3.2 (-)
CV_ENABLE: A1.20 (A1), U3.6 (-), U3.7
DAC_CS: A1.11 (D8), U2.3 (~CS)
DAC_OUT: R14.1, U2.14 (VA)
ENABLED_LED: A1.21 (A2), J8.6
GAIN_A: J9.4, R14.2, U4.2 (-)
GAIN_B: J9.3, R15.1, U4.1
GATE_A_OUT: A1.10 (D7), J8.2
GATE_B_OUT: A1.9 (D6), J8.3
GND: A1.4 (GND), A1.29 (GND), C1.2, C2.2, C3.2, C5.2, C6.2, C7.1, J8.1, J9.1, J11.3 (GND), J11.4 (GND), J11.5 (GND), J11.6 (GND), J11.7 (GND), J11.8 (GND), R9.2, R10.2, U1.19 (DCPRG), U1.22 (GND), U1.27 (VPRG), U2.8 (~LDAC), U2.12 (Vss), U3.10 (+), U3.11 (V-), U3.12 (+), U4.3 (+), U4.5 (+), U5.3 (K)
INPUT_CV_BIAS: J10.3, R11.1
INPUT_CV_CLOCK: J10.5, U3.3 (+)
INPUT_CV_ENABLE: J10.4, U3.5 (+)
LED_BLANK: A1.13 (D10), R9.1, U1.23 (BLANK)
LED_LATCH: A1.12 (D9), U1.24 (XLAT)
LED_PWM_REF: A1.6 (D3), U1.18 (GSCLK)
unnamed: J7.1, U1.28 (OUT0)
unnamed: J7.2, U1.1 (OUT1)
unnamed: J7.3, U1.2 (OUT2)
unnamed: J7.4, U1.3 (OUT3)
unnamed: J7.5, U1.4 (OUT4)
unnamed: J7.6, U1.5 (OUT5)
unnamed: J7.7, U1.6 (OUT6)
unnamed: R10.1, U1.20 (IREF)
unnamed: R11.2, R12.2, R13.1, U3.9 (-)
unnamed: U3.13 (-), U3.14
unnamed: R15.2, R16.1, U4.6 (-)
POT_BIAS: J10.2, R12.1
POT_RANDOM: A1.26 (A7), J9.5
RANDOM_OUT: J8.4, R16.2, U4.7
RE_A: A1.8 (D5), J10.7
RE_B: A1.7 (D4), J10.6
RE_SWITCH: A1.24 (A5), J10.8
SPI_MOSI: A1.14 (D11), U1.26 (SIN), U2.5 (SDI)
SPI_SCK: A1.16 (D13), U1.25 (SCLK), U2.4 (SCK)
TRIG_IN_LED: A1.22 (A3), J8.5
TRIG_SWTICH: A1.25 (A6), J9.6
VREF_-5: C1.1, J10.1, R17.2, U5.1 (A)

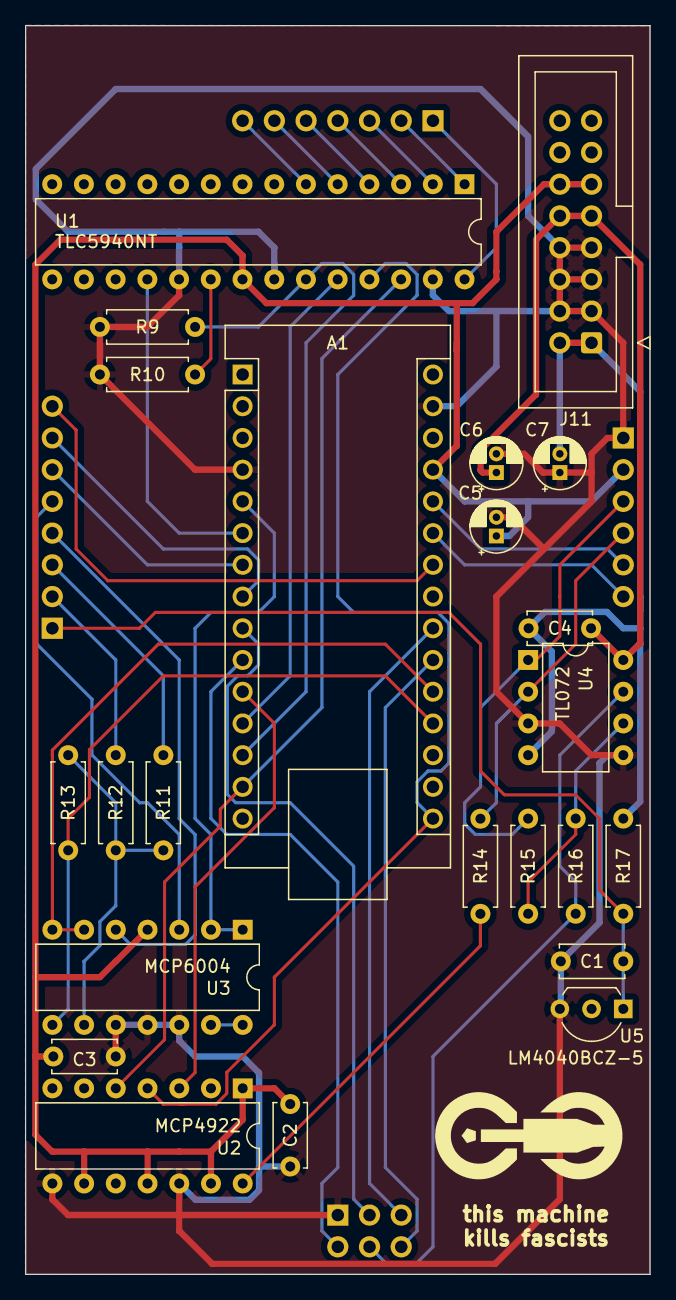
[picture p68: board RNG/Hardware/PCB/rng_pcb_back/rng_pcb_back.kicad_pcb from above]

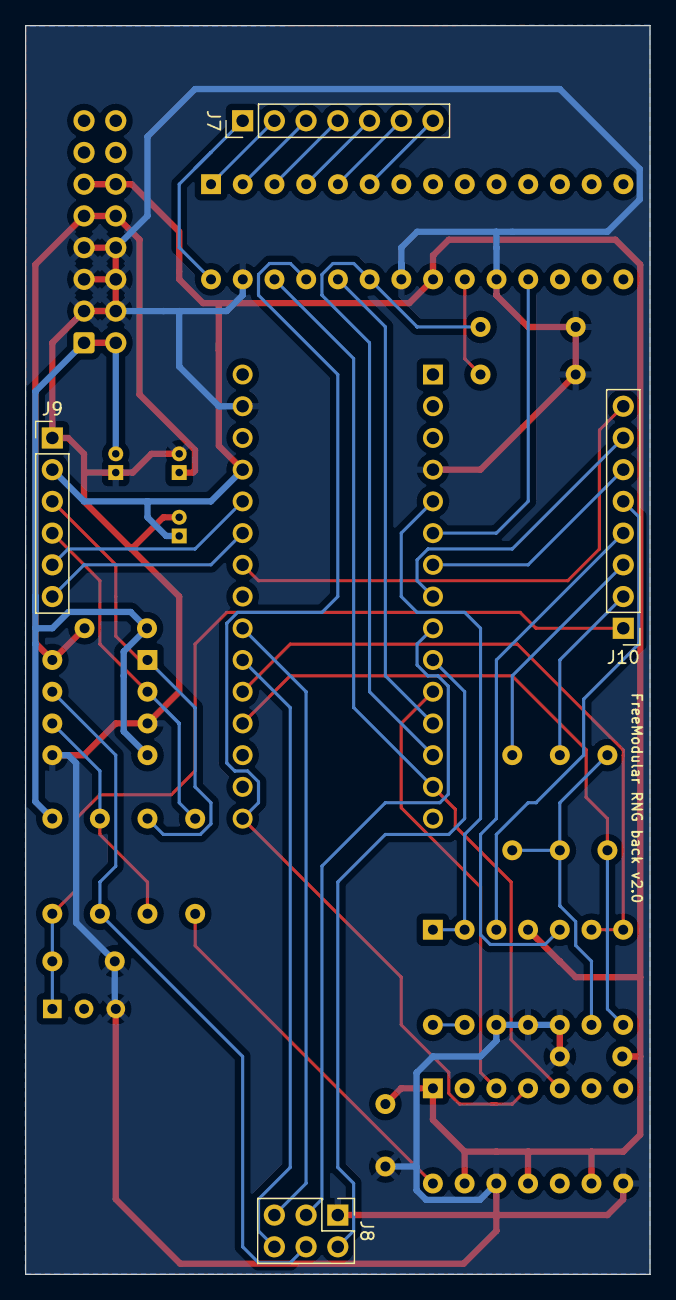
[picture p69: board RNG/Hardware/PCB/rng_pcb_back/rng_pcb_back.kicad_pcb from below]

Board: 2 copper layers, 50.0 x 100.0 mm, 27 parts (4 on the bottom side), 42 nets.
