QuinnFreedman/modular/DiodeDistortion/Hardware/PCB/distortion_pcb/DiodeDistortion.kicad_pcb

## KiCad design DiodeDistortion/Hardware/PCB/distortion_pcb/DiodeDistortion.kicad_pcb (2023-04-25)

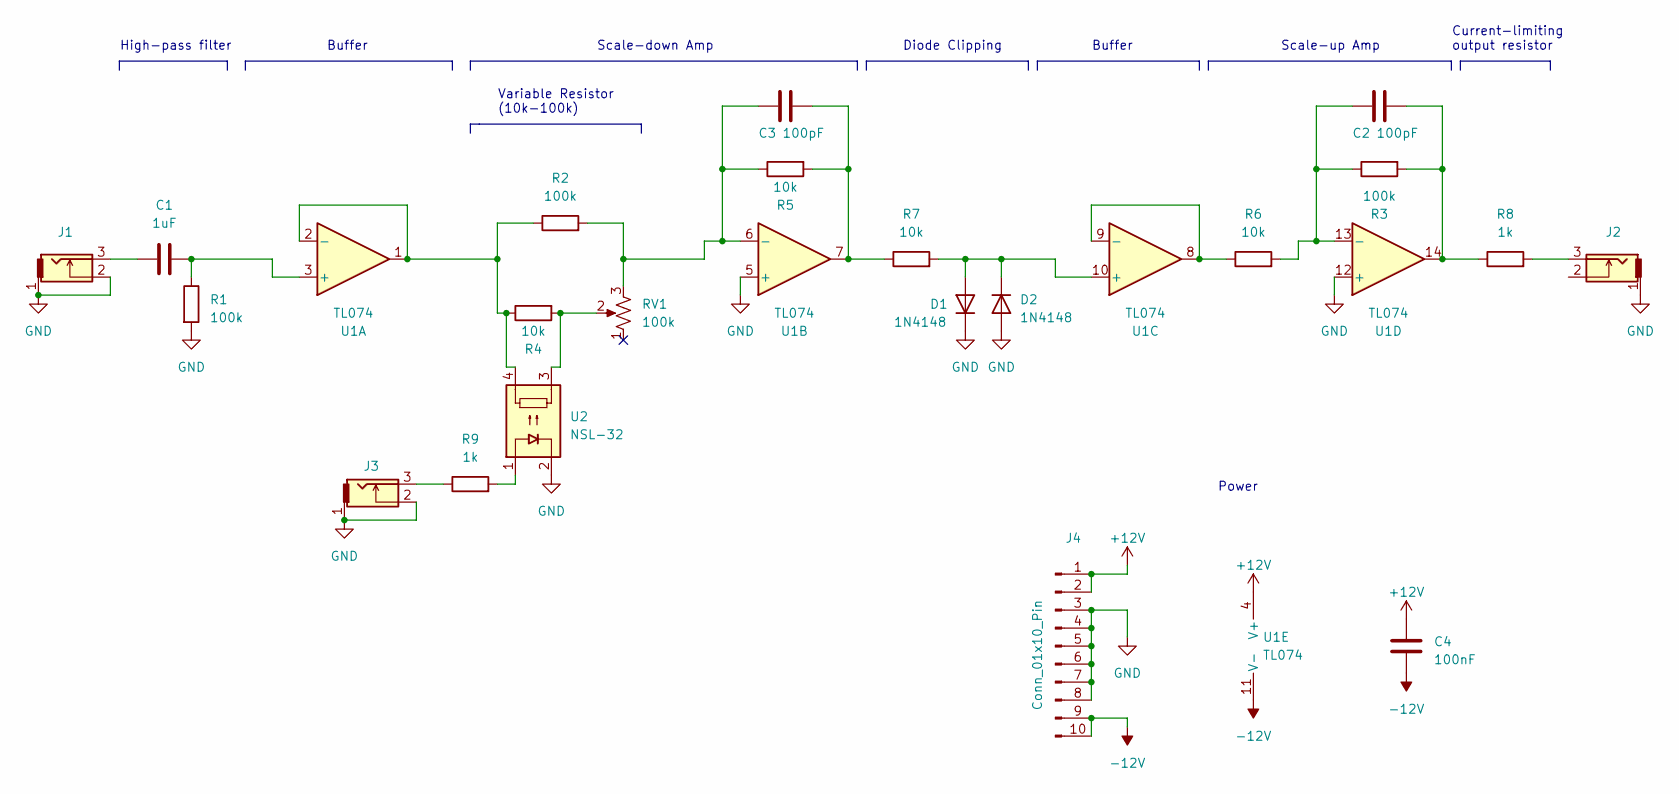
[picture p70: schematic DiodeDistortion.kicad_sch, Diode Distortion]

Parts:
C1: 1uF; C_Disc_D4.7mm_W2.5mm_P5.00mm
C2, C3: 100pF; C_Disc_D4.7mm_W2.5mm_P5.00mm
C4: 100nF; C_Disc_D4.7mm_W2.5mm_P5.00mm
D1, D2: 1N4148; D_DO-35_SOD27_P7.62mm_Horizontal
J1, J2, J3: THONKICONN
J4: Conn_01x10_Pin; PinSocket_2x05_P2.54mm_Vertical
R1, R2, R3: 100k; R_Axial_DIN0207_L6.3mm_D2.5mm_P7.62mm_Horizontal
R4, R5, R6, R7: 10k; R_Axial_DIN0207_L6.3mm_D2.5mm_P7.62mm_Horizontal
R8, R9: 1k; R_Axial_DIN0207_L6.3mm_D2.5mm_P7.62mm_Horizontal
RV1: 100k; Alpha_Potentiometer_Grounded
U1: TL074; DIP-14_W7.62mm
U2: NSL-32

Connections:
+12V: C4.1, J4.1, J4.2, U1.4 (V+)
-12V: C4.2, J4.9, J4.10, U1.11 (V-)
GND: D1.1 (K), D2.2 (A), J1.1, J1.2, J2.1, J3.1, J3.2, J4.3, J4.4, J4.5, J4.6, J4.7, J4.8, R1.2, RV1.MP, U1.5 (+), U1.12 (+), U2.2
unnamed: C1.1, J1.3
unnamed: C2.2, R3.2, R8.1, U1.14
unnamed: C3.2, R5.2, R7.1, U1.7
unnamed: D1.2 (A), D2.1 (K), R7.2, U1.10 (+)
unnamed: J2.3, R8.2
unnamed: J3.3, R9.1
unnamed: R4.2, RV1.2, U2.3
unnamed: R9.2, U2.1
unnamed: C1.2, R1.1, U1.3 (+)
unnamed: R2.1, R4.1, U1.1, U1.2 (-), U2.4
unnamed: C3.1, R2.2, R5.1, RV1.3, U1.6 (-)
unnamed: R6.1, U1.8, U1.9 (-)
unnamed: C2.1, R3.1, R6.2, U1.13 (-)

Notes on the sheet:
Buffer
High-pass filter
Variable Resistor (10k-100k)
Current-limiting output resistor
Scale-up Amp
Diode Clipping
Scale-down Amp
Power

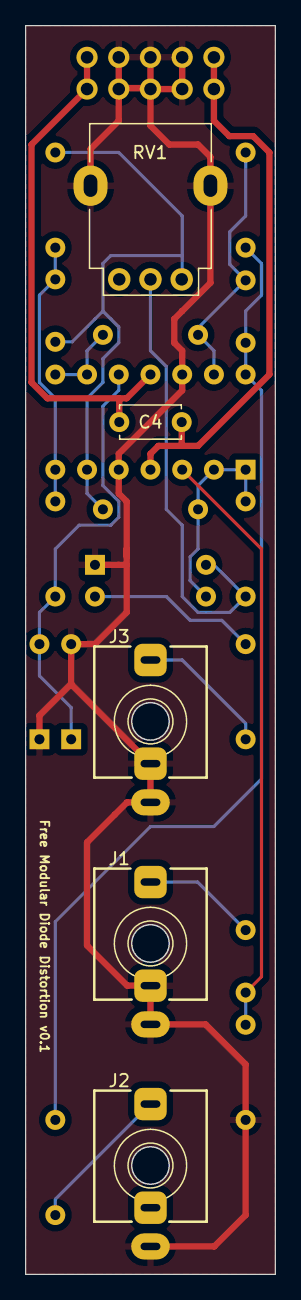
[picture p71: board DiodeDistortion.kicad_pcb from above]

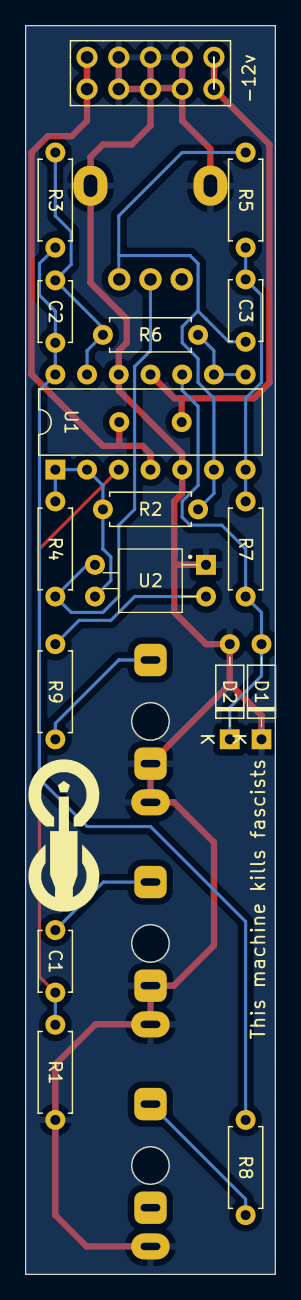
[picture p72: board DiodeDistortion.kicad_pcb from below]

Board: 2 copper layers, 20.0 x 100.0 mm, 22 parts (17 on the bottom side), 16 nets.
