QuinnFreedman/modular/Simplex/Hardware/PCB/simplex_pcb_back/simplex_pcb_back.kicad_pcb

## KiCad design Simplex/Hardware/PCB/simplex_pcb_back/simplex_pcb_back.kicad_pcb (2023-04-10)

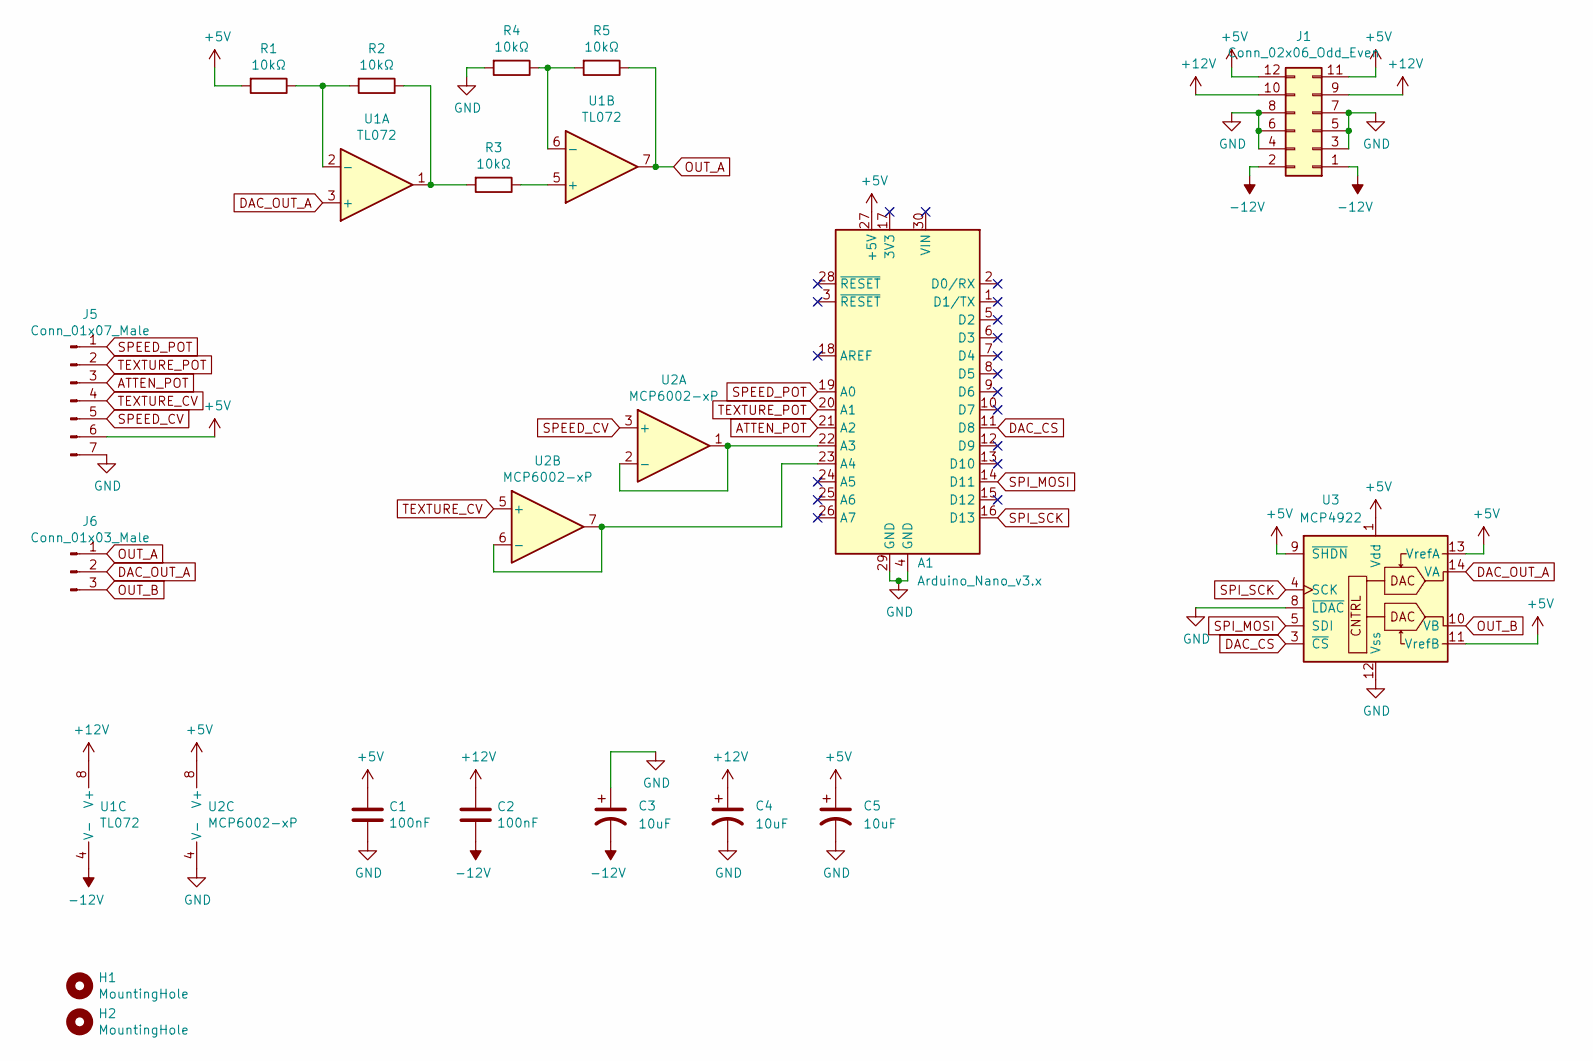
[picture p73: schematic simplex_pcb_back.kicad_sch, Simplex Back]

Parts:
A1: Arduino_Nano_v3.x; Arduino_Nano
C1, C2: 100nF; C_Disc_D4.3mm_W1.9mm_P5.00mm
C3, C4, C5: 10uF; CP_Radial_D4.0mm_P2.00mm
H1, H2: MountingHole; MountingHole_2.7mm_M2.5
J1: Conn_02x06_Odd_Even; IDC-Header_2x06_P2.54mm_Vertical
J5: Conn_01x07_Male; PinHeader_1x07_P2.54mm_Vertical
J6: Conn_01x03_Male; PinHeader_1x03_P2.54mm_Vertical
R1, R2, R3, R4, R5: 10kΩ; R_Axial_DIN0207_L6.3mm_D2.5mm_P10.16mm_Horizontal
U1: TL072; DIP-8_W7.62mm
U2: MCP6002-xP; DIP-8_W7.62mm
U3: MCP4922; DIP-14_W7.62mm

Connections:
+5V: A1.27 (+5V), C1.1, C5.1, J1.11, J1.12, J5.6, R1.2, U2.8 (V+), U3.1 (Vdd), U3.9 (~SHDN), U3.11 (VrefB), U3.13 (VrefA)
+12V: C2.1, C4.1, J1.9, J1.10, U1.8 (V+)
-12V: C2.2, C3.2, J1.1, J1.2, U1.4 (V-)
ATTEN_POT: A1.21 (A2), J5.3
DAC_CS: A1.11 (D8), U3.3 (~CS)
DAC_OUT_A: J6.2, U1.3 (+), U3.14 (VA)
GND: A1.4 (GND), A1.29 (GND), C1.2, C3.1, C4.2, C5.2, J1.3, J1.4, J1.5, J1.6, J1.7, J1.8, J5.7, R4.2, U2.4 (V-), U3.8 (~LDAC), U3.12 (Vss)
unnamed: A1.22 (A3), U2.1, U2.2 (-)
unnamed: A1.23 (A4), U2.6 (-), U2.7
unnamed: R2.1, R3.2, U1.1
unnamed: R1.1, R2.2, U1.2 (-)
unnamed: R3.1, U1.5 (+)
unnamed: R4.1, R5.2, U1.6 (-)
OUT_A: J6.1, R5.1, U1.7
OUT_B: J6.3, U3.10 (VB)
SPEED_CV: J5.5, U2.3 (+)
SPEED_POT: A1.19 (A0), J5.1
SPI_MOSI: A1.14 (D11), U3.5 (SDI)
SPI_SCK: A1.16 (D13), U3.4 (SCK)
TEXTURE_CV: J5.4, U2.5 (+)
TEXTURE_POT: A1.20 (A1), J5.2

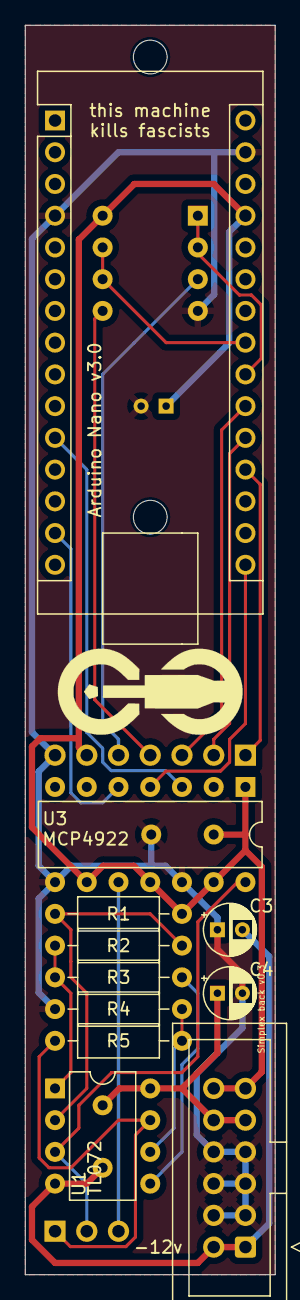
[picture p74: board simplex_pcb_back.kicad_pcb from above]

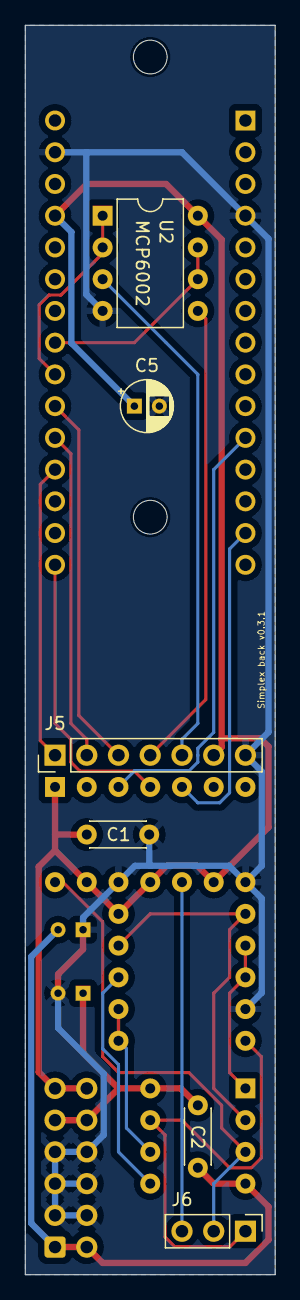
[picture p75: board simplex_pcb_back.kicad_pcb from below]

Board: 2 copper layers, 20.0 x 100.0 mm, 19 parts (6 on the bottom side), 21 nets.
