QuinnFreedman/modular/Simplex/Hardware/PCB/simplex_pcb_front/simplex_pcb_front.kicad_pcb

## KiCad design Simplex/Hardware/PCB/simplex_pcb_front/simplex_pcb_front.kicad_pcb (2023-04-10)

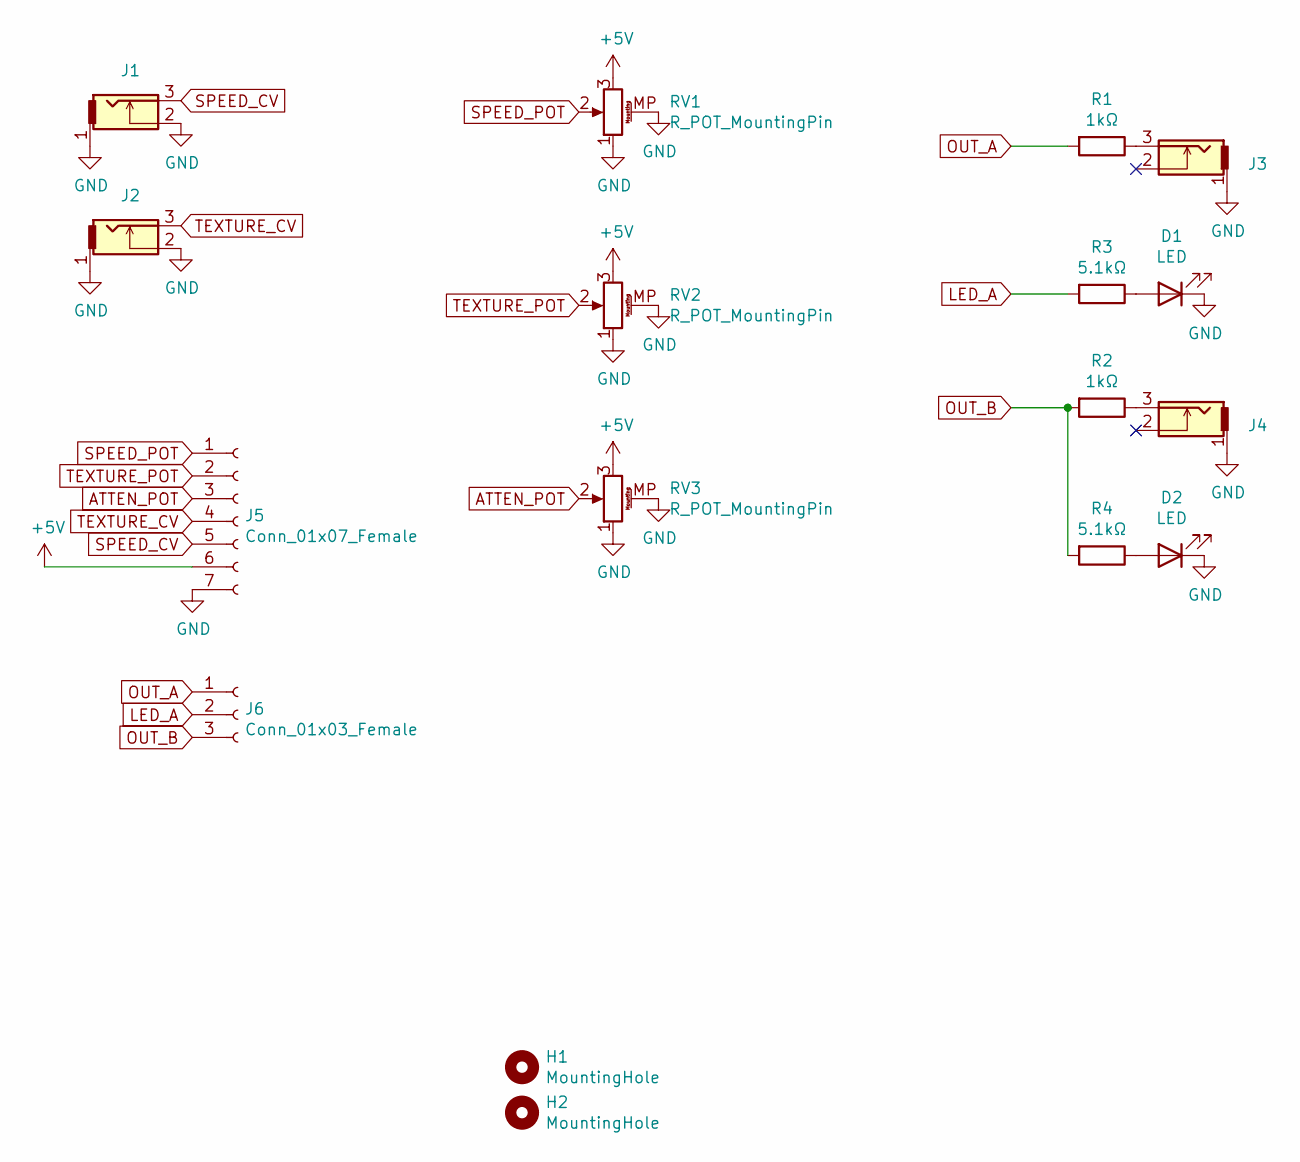
[picture p76: schematic simplex_pcb_front.kicad_sch, Simplex Back]

Parts:
D1, D2: LED; LED_D3.0mm
H1, H2: MountingHole; MountingHole_2.7mm
J1, J2, J3, J4: THONKICONN; THONKICONN_perf
J5: Conn_01x07_Female; PinSocket_1x07_P2.54mm_Vertical
J6: Conn_01x03_Female; PinSocket_1x03_P2.54mm_Vertical
R1, R2: 1kΩ; R_Axial_DIN0207_L6.3mm_D2.5mm_P10.16mm_Horizontal
R3, R4: 5.1kΩ; R_Axial_DIN0207_L6.3mm_D2.5mm_P10.16mm_Horizontal
RV1, RV2, RV3: R_POT_MountingPin; Alpha_Potentiometer_Grounded

Connections:
+5V: J5.6, RV1.3, RV2.3, RV3.3
ATTEN_POT: J5.3, RV3.2
GND: D1.1 (K), D2.1 (K), J1.1, J1.2, J2.1, J2.2, J3.1, J4.1, J5.7, RV1.1, RV1.MP (MountPin), RV2.1, RV2.MP (MountPin), RV3.1, RV3.MP (MountPin)
LED_A: J6.2, R3.2
unnamed: D1.2 (A), R3.1
unnamed: D2.2 (A), R4.1
unnamed: J3.3, R1.1
unnamed: J4.3, R2.1
OUT_A: J6.1, R1.2
OUT_B: J6.3, R2.2, R4.2
SPEED_CV: J1.3, J5.5
SPEED_POT: J5.1, RV1.2
TEXTURE_CV: J2.3, J5.4
TEXTURE_POT: J5.2, RV2.2

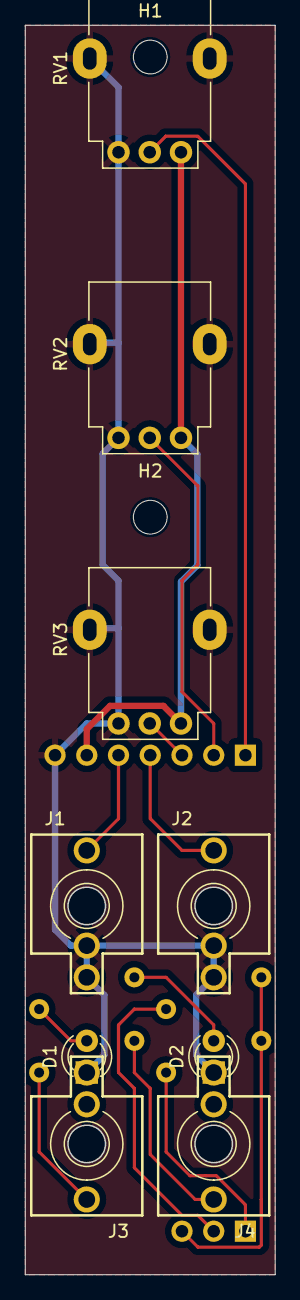
[picture p77: board simplex_pcb_front.kicad_pcb from above]

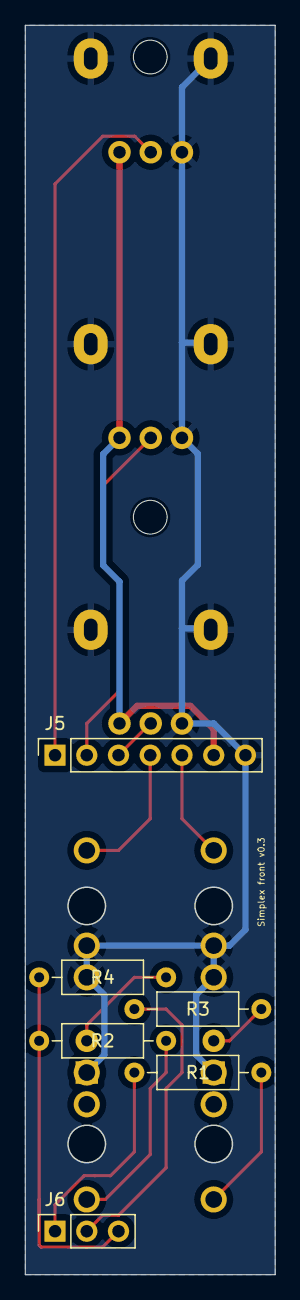
[picture p78: board simplex_pcb_front.kicad_pcb from below]

Board: 2 copper layers, 20.0 x 100.0 mm, 17 parts (6 on the bottom side), 14 nets.
